maximmalin/simul/frontend/README.md

# EngineeringTeam

Open in Bolt (https://bolt.new/~/sb1-g74egklw)
