maximmalin/simul/tests/requirements/README.md

# tests/requirements/
Автоматические тесты Brig Receiver по матрице требований.

## Порядок работы
1. Тесты запускаются через `.venv/bin/pytest tests/requirements/ -v`.
2. Чек-лист обновляется вручную при появлении новых требований или готовности тестов.
3. Расчёты (calculations/, math/) не используются — только параметры из требований и reference-файлов.

## Подпапки
- `tests/requirements/antenna/` — антенная система (REQ-A1/B1/C1/SW1/ANT-ALL)
- `tests/requirements/rf/` — RF Frontend (REQ-01/03/04/05/06, SNR REQ-36, шум REQ-37)
- `tests/requirements/ao/` — акустооптический процессор (REQ-07/08/09/11/13/14/15)
- `tests/requirements/system/` — системные требования (REQ-01 покрытие, диапазон 0–7 ГГц)
- `tests/requirements/emc/` — электромагнитная совместимость (REQ-21…REQ-25)
- `tests/requirements/reception/` — дальность приёма (Friis/шум) и пеленгация (NEC-2/AntennaSim)
- `tests/requirements/reliability/` — надёжность, MTBF по REQ-26 (Octave)
- `tests/requirements/thermal/` — тепловой режим: fast (θ_JA) + FEM (PCB CAD + ngspice)
- `tests/requirements/checklist.csv` — чек-лист требований
- `tests/requirements/README.md` — описание подпапок
- `tests/requirements/checklist/README.md` — описание чек-листа

## Источник
- requirements/*/REQ-*.md
- tests/README.md
