maximmalin/simul/hardware/antenna/README.md

# antenna/README.md
'''
Много диапазонная печатная антенная решетка (Multi-Band Antenna Array)
Размер: 150 × 150 мм, материал — СВЧ-текстолит FR-4 толщиной 0.8 мм.
'''
