maximmalin/simul/sim/outputs/ngspice/README.md

# Brig Receiver antennas -> ngspice S-parameter networks

Generated by `sim/scripts/export_ngspice.py` from the openEMS FDTD results in
`sim/outputs/openems_results.json`.  Reference impedance 50 ohm everywhere.

## Data provenance

* **Ch B / Ch C** - single-patch FDTD (openEMS, FR-4 eps_r=4.5, tan_d=0.02,
  h=0.8 mm, PML_8 absorbing boundaries).  The patch resonant length and the
  probe offset were retuned from an initial simulation so that each element
  resonates at its design frequency and presents ~50 ohm at the feed.
  ``Zin(f)`` is the simulated input impedance; ``S11`` is exact.  Radiation
  efficiency is the FDTD ``Prad/P_acc`` ratio at resonance.
* **Ch A** - analytic printed-dipole model (0-900 MHz).  Not an FDTD result;
  efficiency is assumed ideal.  Replace with an FDTD run if a
  frequency-dependent dipole model is required.

## Files

| Ch | 1-port | 2-port | f_res (GHz) | S11 @ f_res (dB) | eta_rad |
|----|---|---|---|---|---|
| A | `ant_cha.s1p` | `ant_cha.s2p` | 0.200 | -12.0 | 100% |
| B | `ant_chb.s1p` | `ant_chb.s2p` | 2.450 | -33.1 | 30% |
| C | `ant_chc.s1p` | `ant_chc.s2p` | 5.800 | -24.4 | 50% |

* `ant_ch<X>.s1p` - antenna feed reflection only (exact FDTD `Zin`).
* `ant_ch<X>.s2p` - 2-port: port 1 = feed, port 2 = radiated-wave port.
* `ant_sparams.lib` - ngspice subcircuits `ANT_CHA` / `ANT_CHB` / `ANT_CHC`.
* `antenna_model.net` - demo netlist (unit source at the space port).

## Two-port definition

```
 port 1 (feed)  ---[ ANT_CHx ]---  port 2 (radiated wave)
  to RF front-end                   test signal / free space
```

* `S11(f) = (Zin(f) - 50) / (Zin(f) + 50)` - from the FDTD input impedance.
* `S22 = 0` - matched radiation sink.
* `S21 = S12 = sqrt(eta) * sqrt(1 - |S11|^2) * exp(j*arg(S11))`.

Power balance: driving port 1 gives `|S11|^2 + |S21|^2 = eta` (the accepted
power is radiated with efficiency `eta`; the remainder is dielectric and
conductor loss).  On receive, driving port 2 delivers `eta*(1 - |S11|^2)` of
the incident power to the feed.

To emulate a received wave, drive port 2 and read port 1; to load a
transmitter, drive port 1 into the receiver front-end.

## Usage in ngspice

```spice
.include ant_sparams.lib
V_test   space 0 dc 0 ac 1
Xant_chB feed  space 0 ANT_CHB touchstone="ant_chB.s2p"
Rfeed    feed  0 50
.control
sp lin 101 1e9 4e9
print S_1_1 S_2_1
.endc
```

Run the demo: `ngspice -b sim/outputs/ngspice/antenna_model.net`

## Why no FMU

ngspice 44 reads Touchstone natively via the XSPICE `xfer` code model
(see `/usr/share/doc/ngspice/examples/sp/file.cir`).  No FMU wrapper is
needed for this network.

## Notes / limitations

* The model reproduces the simulated feed impedance exactly.
* Radiation efficiency is the FDTD `Prad/P_acc` ratio at resonance.  Pass
  `--eta <x>` to the exporter to override every channel with a fixed value.
* `|S11|` is clipped to `< 1` (passivity) at a handful of far-out-of-band
  points where the raw FDTD impedance gives a marginal `|S11| > 1`.
* The transmission phase is taken as `arg(S11)` (lossless reciprocal 2-port
  convention).  Magnitudes are exact; absolute far-field phase is not
  calibrated (that needs a two-antenna reference measurement).
