maximmalin/simul/design/library_index.md

# Library Index

| Ref | Type | KiCad Lib ID | Footprint |
|-----|---|---|---|
| PLC0415 | plc | Device:R | - |
| BLE001 | ble | Device:R | - |
| PLC0415 | plc | Device:R | - |
| PLC0415 | plc | Device:R | - |
| PLC0415 | plc | Device:R | - |
| PLC0415 | plc | Device:R | - |
| PLC0415 | plc | Device:R | - |
| PLC0415 | plc | Device:R | - |
| PLC0415 | plc | Device:R | - |
| BLE001 | ble | Device:R | - |
| BLE001 | ble | Device:R | - |
| BLE001 | ble | Device:R | - |
| BLE001 | ble | Device:R | - |
| BLE001 | ble | Device:R | - |
