maximmalin/simul/requirements/antenna/REQ-ANT-01_channel_a.md

# REQ-ANT-01 — Антенная система, канал A

**Подсистема:** Антенная панель (печатная плата 150×150 мм, FR-4 0.8 мм)

- **Требование:** Приём в диапазоне 0–900 МГц, входное сопротивление 50 ± 10 Ом, КНД ≥ 5 дБи на 433 МГц.
- **Проверка:** `tests/requirements/antenna/test_antenna.py`; FDTD — `sim/scripts/antenna_fdtd.py`.

### Сквозной расчёт физики

Печатный диполь на FR-4 с ε_r = 4.4 рассчитывается с учётом
диэлектрической проницаемости подложки, уменьшающей эффективную длину:

λ_eff = c / (f · √((1 + ε_r)/2))

Для резонанса на 200 МГц (нижняя граница рабочего диапазона):
λ_0 = 1.5 м, λ_eff ≈ 0.92 м → длина диполя ≈ 0.46 м.

На 433 МГц λ_0 = 0.69 м → КНД печатного диполя на проводящей
подложке с экранирующей обратной стороной составляет ≈ 5.5 дБи.
