maximmalin/simul/requirements/mechanics/REQ-MECH-02_zoning.md

# REQ-MECH-02 — Зонирование корпуса

**Подсистема:** Механика / корпус
**Схема:** `references/structural_block.drawio`

- **Требование:** Корпус разделить на три электрически изолированные секции — ВЧ-аналоговую, цифровую и питания — перегородками из алюминия с прокладками.
- **Проверка:** `tests/requirements/emc/test_emc.py::test_req_25_*`.

### Секции и их содержимое

| секция | элементы платы | требование |
|---|---|---|
| **ВЧ-аналоговая** | `J_ANT`, `Q_LNA1/2`, `X_QWC1`, `U_MIX1`, `U_OP1`, `FB1`, `C_ANA*` | аналоговая «земля» звездой; тактовые линии STM32 не входят |
| **Цифровая** | `U1`, `Y1`, `J_USB`, `C_MCU*` | своя GND-плоскость, экран от ВЧ-секции |
| **Питание** | `J_PWR`, `U_LDO`, `C_LDO*` | сквозной фильтр на входе аналоговой секции |

### Сквозной расчёт физики

Токи переключения `U1` (72 МГц и гармоники) текут по цифровой «земле».
При отсутствии разделения общий ток создаёт падение напряжения
ΔV = I·R_общ на сопротивлении общей «земли», которое проявляется
как ошибка на входе АЦП и неотличимо от полезного сигнала.

Чтобы ΔV оставалось ниже цены младшего разряда АЦП
(q_LSB = 3.3/4096 ≈ 0.8 мВ), требуется R_общ < 0.8·10⁻³ / I_цифр.
При I_цифр = 20 мА: R_общ < **40 мОм** — достигается только при
звёздной разводке «земли» и разделении на секции.

> В предыдущей редакции третьей секцией считался «цифровой блок
> (ESP32, ПЛИС)», а гальваническая изоляция обеспечивалась связью с ПК
> **только по Wi-Fi**. В Krystal Radio беспроводной связи нет: данные
> выводятся по USB CDC, микроконтроллер — STM32F103C8T6, ПЛИС не
> применяется. Оптический блок отсутствует.
