maximmalin/simul/requirements/blocks/req_27.md

# # Блок требования REQ-27

## Электробезопасность (Electrical Safety)
- **Требование:** Изделие должно соответствовать требованиям безопасности по ГОСТ IEC 60950-1-2014 (Эквивалент: IEC 60950-1 / IEC 62368-1)
- **Структурный блок:** Блок 6.2 «Безопасность — Электрическая»
- **Скрещивание с общими техническими требованиями:**
  - Требование раздельного питания блоков (230В Сеть → DC преобразователи изолированы)
  - Гальваническая изоляция интерфейсов (USB, Ethernet — оптические изоляторы)
  - Взаимосвязь с требованием REQ-23 (EMC излучение)
- **Сквозной расчет физики:** Изоляционное напряжение между сетью 230В и низковольтными секциями должно не менее 3000 В (per IEC 62368-1, Class I equipment). При рабочем напряжении +12V и +5V от линейных стабилизаторов (LM7812/LM7805) от батарейного питания изоляция не требуется (обеспечивается батарейной изоляцией от сети). Защита от перегрузок: автоматический выключатель при токе > 2A, время отключения < 0.1 с. Заземление корпуса (Grounding screw per ГОСТ 14192-96, знак «Заземление»). Утечка тока на корпус не должна превышать 0.5 mA (per IEC 60950-1).
