maximmalin/simul/requirements/blocks/req_28.md

# # Блок требования REQ-28

## Защита от перегрузок (Overcurrent Protection)
- **Требование:** Автоматический выключатель при токе > 2A, время отключения < 0.1 с
- **Структурный блок:** Блок 6.3 «Защита цепей»
- **Скрещивание с общими техническими требованиями:**
  - Взаимосвязь с требованием REQ-19 (стабилизация ±0.1° C — система Пельтье)
  - Взаимосвязь с требованием REQ-04 (NF ≤ 3.5 дБ — питание УПЧ КТ368А)
- **Сквозной расчет физики:** Стабилизаторы питания LM7812/LM7805 потребляют ток от батарей в диапазоне 200–500 мА (при нагрузке 0.5–2 А на выходе). Автоматический выключатель (полимерный восстановляемый предохранитель, R PolySwitch, rated 2A) гасит перегрузки от короткого замыкания или аварийной нагрузки. При токе 2A падение напряжения на fuse: V_drop ≈ I · R ≈ 2A · 0.05Ω ≈ 0.1V (минимум). Время отключения: t_break ≈ 0.01–0.1 с (для polymeric fuse). Это предотвращает перегрев проводников (температура подъема ΔT ≈ I²·R·t / C_thermal < 10° C при R_wire ≈ 0.1Ω) и пожары.
