maximmalin/simul/requirements/blocks/req_29.md

# # Блок требования REQ-29

## Заземление и защита от удара током (Grounding)
- **Требование:** Заземление корпуса, утечка тока на корпус не более 0.5 mA
- **Структурный блок:** Блок 6.4 «Заземление»
- **Скрещивание с общими техническими требованиями:**
  - Взаимосвязь с требованием REQ-27 (электробезопасность)
  - Взаимосвязь с требованием REQ-23 (EMC излучение)
- **Сквозной расчет физики:** Заземляющий провод сечением S ≥ 0.5 мм² (per ГОСТ 3198) обеспечивает токос방ока при аварийном контакте. Утечка тока I_leakage ≤ 0.5 mA рассчитывается по формуле I_leakage = V_isolation / R_insulation, где V_isolation ≈ 500 В (напряжение сети) и R_insulation ≥ 100 MΩ (per IEC 60950-1). ΔT на корпусе от потоса: Q = I² · R · t ≈ (0.0005A)² · 0.1Ω · 3600s ≈ 0.0009 J — незначительное нагревание (ΔT < 0.1° C при массе корпуса ~500 г, c_al ≈ 0.9 J/g·K).
