maximmalin/simul/requirements/blocks/req_antenna_system.md

# # Блок требования REQ-A1: Антенна Канал А (0–900 МГц)
## Печатная полуволновая змейка

- **Требование:** Прием радиосигналов в диапазоне 0–900 МГц, входное сопротивление 50 ± 10 Ом, коэффициент усиления не менее 5 дБи на частоте 433 МГц, SWR ≤ 2.0 по всей полосе
- **Структурный блок:** Узел 0.1 / Блок А «Антенна Канал А»
- **Скрещивание с общими техническими требованиями:**
  - Входное сопротивление 50 Ом (REQ-03, ГОСТ 20275-91)
  - Совместимость с ВЧ-трактом 0–7 ГГц (REQ-01)
- **Физическая реализация:**
  - Тип: печатная полуволновая антенна-змейка (Meander Line Antenna)
  - Материал: СВЧ-текстолит FR-4, толщина 0.8 мм, ε = 4.5
  - Связь с трактом: копланарный волновод (GCPW), Z₀ = 50 Ом, ширина 1.2 мм, зазор 0.2 мм
  - Панель: 150 × 150 мм
- **Критерии приемки:**
  - Диапазон приема: не менее 0–900 МГц (SWR ≤ 2.0)
  - Входное сопротивление: 50 ± 10 Ом в полосе
  - КНД ≥ 5 дБи на 433 МГц
  - Результаты моделирования NEC2/NEC4 в файле `antenna/band_a/simulation.nec`

---

# # Блок требования REQ-B1: Антенна Канал Б (1.2–3.0 ГГц)
## Микрополосковая матрица 2×2

- **Требование:** Прием радиосигналов в диапазоне 1.2–3.0 ГГц, резонанс 2.45 ± 0.02 ГГц, коэффициент усиления не менее 8 дБи, входное сопротивление 50 ± 5 Ом (SWR ≤ 1.5)
- **Структурный блок:** Узел 0.2 / Блок Б «Антенна Канал Б»
- **Скрещивание с общими техническими требованиями:**
  - Входное сопротивление 50 Ом (REQ-03, ГОСТ 20275-91)
  - Участие в коммутации через PIN-ключи (структурная схема)
  - Покрытие диапазона 0–7 ГГц в составе антенной решетки (REQ-01)
- **Физическая реализация:**
  - Тип: микрополосковая матрица патчей 2×2 (4 элемента)
  - Материал: СВЧ-текстолит FR-4, толщина 0.8 мм, ε = 4.5
  - Шаг между центрами элементов: 91.7 мм
  - Связь с трактом: GCPW 50 Ом (ширина 1.2 мм, зазор 0.2 мм)
  - Панель: 150 × 150 мм
- **Критерии приемки:**
  - Резонансная частота: 2.45 ± 0.02 ГГц
  - КНД: не менее 8 дБи (в основном лепестке)
  - Входное сопротивление: 50 ± 5 Ом (SWR ≤ 1.5)
  - Результаты моделирования в HFSS/CST или NEC2 в файле `antenna/band_b/simulation.nec`

---

# # Блок требования REQ-C1: Антенна Канал В (4.0–7.0 ГГц)
## Микрополосковая матрица 4×4

- **Требование:** Прием радиосигналов в диапазоне 4.0–7.0 ГГц, резонанс 5.8 ± 0.05 ГГц, коэффициент усиления не менее 12 дБи, входное сопротивление 50 ± 5 Ом, уровень сторонних лепестков ≤ −15 дБ
- **Структурный блок:** Узел 0.3 / Блок В «Антенна Канал В»
- **Скрещивание с общими техническими требованиями:**
  - Входное сопротивление 50 Ом (REQ-03, ГОСТ 20275-91)
  - Участие в коммутации через PIN-ключи (структурная схема)
  - Покрытие диапазона 0–7 ГГц в составе антенной решетки (REQ-01)
  - Требование к помехоустойчивости и экранированию (REQ-21, REQ-25)
- **Физическая реализация:**
  - Тип: микрополосковая матрица патчей 4×4 (16 элементов)
  - Материал: СВЧ-текстолит FR-4, толщина 0.8 мм, ε = 4.5 (для верхней части диапазона ≥ 5 ГГц допускается Rogers RO4350B)
  - Связь с трактом: GCPW 50 Ом (ширина 1.2 мм, зазор 0.2 мм)
  - Экранирование: металлическая камера вокруг антенной решетки (стенки ≥ 1.5 мм, алюминий)
  - Панель: 150 × 150 мм
- **Критерии приемки:**
  - Резонансная частота: 5.8 ± 0.05 ГГц
  - Диапазон работы: 4.0–7.0 ГГц (SWR ≤ 2.0)
  - КНД: не менее 12 дБи (матрица 4×4)
  - Входное сопротивление: 50 ± 5 Ом
  - Уровень сторонних лепестков ≤ −15 дБ
  - Результаты моделирования в HFSS/CST или открытой альтернативе в файле `antenna/band_c/simulation.nec`

---

# # Блок требования REQ-SW1: Переключатель антенных каналов
## СВЧ PIN-ключи

- **Требование:** Коммутация антенных входов А/Б/В с изоляцией не включенных каналов не менее 40 дБ, быстродействие переключения ≤ 1 мкс, управляемость от микроконтроллера (TTL-уровень)
- **Структурный блок:** Узел 1.1 / Блок «Переключатель СВЧ-каналов»
- **Скрещивание с общими техническими требованиями:**
  - Совместимость с ВЧ-трактом (REQ-03, 50 Ом)
  - Защита от наводок Wi-Fi (REQ-23, REQ-25)
  - Входит в Отсек 1 (СВЧ-тракт и селекция)
- **Физическая реализация:**
  - Тип: бескорпусные СВЧ PIN-диоды серии КА507
  - Управление: TTL-импульсы от ESP32 (контроллер Отсек 4)
  - Схема коммутации: три входа (А, Б, В) → один выход на миксер/ТВ-тюнер
  - Изоляция невыбранных каналов: ≥ 40 дБ
- **Критерии приемки:**
  - Изоляция невыбранных каналов: ≥ 40 дБ
  - Время переключения: ≤ 1 мкс
  - Входное и выходное сопротивление: 50 ± 5 Ом
  - Управление от ESP32: TTL-уровень, гарантированное закрытие каналов во время Wi-Fi Burst

---

# # Блок требования REQ-ANT-ALL: Антенная система (комплексный)
## Многодиапазонная печатная антенная решетка

- **Требование:** Три независимых приемных канала (А: 0–900 МГц, Б: 1.2–3.0 ГГц, В: 4.0–7.0 ГГц) на единой печатной панели 150 × 150 мм, FR-4 0.8 мм, с переключением через PIN-ключи, совместное покрытие диапазона 0–7 ГГц
- **Структурный блок:** Узел 0.1–0.3 + Узел 1.1 / Блоки А, Б, В, Переключатель
- **Скрещивание с общими техническими требованиями:**
  - Диапазон 0–7 ГГц (REQ-01)
  - Входное сопротивление 50 Ом (REQ-03)
  - ЭМС: эксплуатация в помеховой обстановке (REQ-21, REQ-22)
  - Совместимость с ТЗ (раздел 3.1, RF Frontend)
- **Критерии приемки:**
  - Полное покрытие: 0–7 ГГц без пропусков
  - Каждый канал: согласован по 50 Ом, SWR ≤ 2.0
  - Переключение каналов: без потери направленности и КНД
  - Панель: единая плата 150 × 150 мм, FR-4 0.8 мм
  - Все файлы трассировки в KiCad/Altium: `block0_5v_bus.kicad_sch`, `block1_rf_frontend.kicad_sch`, `block3.kicad_sch`
