maximmalin/simul/requirements/blocks/req_block_26_29.md

# Блок требований: Надежность и безопасность

## Ссылка на требование: REQ-26 через REQ-27

### 26. Среднее время наработки на отказ (MTBF)
- **Требование:** T₀ должно составлять не менее 10 000 часов
- **Структурный блок:** Блок 6.1 «Надежность — Время наработки»
- **Скрещивание с общими техническими требованиями:**
  - Требование ГОСТ 27.002-2015 (Эквивалент: ISO 13849-1 / IEC 61508)
  - Взаимосвязь с качеством ПО (ISO/IEC 25010) и надежностью 하드웨어
- **Сквозной расчет физики:** MTBF рассчитывается на основе Mean Time Between Failures (MTBF = ΣMTBF_i), где каждый компонент имеет свой собственный MTBF:
  - Алюминиевый корпус: MTBF ≈ 50 000 ч (при условии отсутствия коррозии)
  - Лазерный диод: MTBF ≈ 10 000 ч при температуре 25° C (удваивается при каждом снижении температуры на 10° C по правилу Arrhenius)
  - Элементы Пельтье: MTBF ≈ 20 000 ч (при непрерывной работе в диапазоне -40...+50° C)
  - CMOS-матрица: MTBF ≈ 30 000 ч (при правильном термостабилизировании)
  - Итого система: MTBF_system ≈ 1 / (1/50000 + 1/10000 + 1/20000 + 1/30000) ≈ 5 882 ч — недостаточно, поэтому требуется система предупредительного обслуживания и модулируемое проектирование для замены отдельных узлов без остановки всей системы. Целевой MTBF 10 000 часов достигается за счет использования redundant (дублирующих) каналов для критических функций (стабилизация температуры, захват спектра).

### 27. Электробезопасность (Electrical Safety)
- **Требование:** Изделие должно соответствовать требованиям безопасности по ГОСТ IEC 60950-1-2014 (Эквивалент: IEC 60950-1 / IEC 62368-1)
- **Структурный блок:** Блок 6.2 «Безопасность — Электрическая»
- **Скрещивание с общими техническими требованиями:**
  - Требование раздельного питания блоков (230В Сеть → DC преобразователи изолированы)
  - Гальваническая изоляция интерфейсов (USB, Ethernet — оптические изоляторы)
  - Взаимосвязь с требованием REQ-23 (ЭМС излучение)
- **Сквозной расчет физики:** Изоляционное напряжение между сетью 230В и низковольтными секциями должно не менее 3000 В (per IEC 62368-1, Class I equipment). При рабочем напряжении +12V и +5V от линейных стабилизаторов (LM7812/LM7805) от батарейного питания изоляция не требуется (обеспечивается батарейной изоляцией от сети). Защита от перегрузок: автоматический выключатель при токе > 2A, время отключения < 0.1 с. Заземление корпуса (Grounding screw per ГОСТ 14192-96, знак «Заземление»). Утечка тока на корпус не должна превышать 0.5 mA (per IEC 60950-1).

### 28. Защита от перегрузок (Overcurrent Protection)
- **Требование:** Автоматический выключатель при токе > 2A, время отключения < 0.1 с
- **Структурный блок:** Блок 6.3 «Защита цепей»
- **Скрещивание с общими техническими требованиями:**
  - Взаимосвязь с требованием REQ-19 (стабилизация ±0.1° C — система Пельтье)
  - Взаимосвязь с требованием REQ-04 (NF ≤ 3.5 дБ — питание УПЧ КТ368А)
- **Сквозной расчет физики:** Стабилизаторы питания LM7812/LM7805 потребляют ток от батарей в диапазоне 200–500 мА (при нагрузке 0.5–2 А на выходе). Автоматический выключатель ( polymeric resettable fuse, R PolySwitch, rated 2A) гасит перегрузки от короткого замыкания или аварийной нагрузки. При токе 2A падение напряжения на fuse: V_drop ≈ I · R ≈ 2A · 0.05Ω ≈ 0.1V (минимум). Время отключения: t_break ≈ 0.01–0.1 с (для polymeric fuse). Это предотвращает перегрев проводников (температура подъема ΔT ≈ I²·R·t / C_thermal < 10° C при R_wire ≈ 0.1Ω) и пожары.

### 29. Заземление и защита от удара током (Grounding)
- **Требование:** Заземление корпуса, утечка тока на корпус не более 0.5 mA
- **Структурный блок:** Блок 6.4 «Заземление»
- **Скрещивание с общими техническими требованиями:**
  - Взаимосвязь с требованием REQ-27 (электробезопасность)
  - Взаимосвязь с требованием REQ-23 (EMC излучение)
- **Сквозной расчет физики:** Заземляющий провод сечением S ≥ 0.5 мм² (per ГОСТ 3198) обеспечивает токос방ока при аварийном контакте. Утечка тока I_leakage ≤ 0.5 mA рассчитывается по формуле I_leakage = V_isolation / R_insulation, где V_isolation ≈ 500 В (напряжение сети) и R_insulation ≥ 100 MΩ (per IEC 60950-1). ΔT на корпусе от потоса: Q = I² · R · t ≈ (0.0005A)² · 0.1Ω · 3600s ≈ 0.0009 J — незначительное нагревание (ΔT < 0.1° C при массе корпуса ~500 г, c_al ≈ 0.9 J/g·K).
