maximmalin/simul/hardware/antenna/band_a/task.md

# Блок-узел 0.1: Печатная полуволновая змейка (0–900 МГц)

## Общие данные
- Тип антенны: Печатная полуволновая антенна-змейка (Meander Line Antenna)
- Частотный диапазон: 0–900 МГц
- Назначение: Прием раций (УКВ/ОТР) и служебной связи
- Материал: СВЧ-текстолит FR-4, толщина 0.8 мм, ε = 4.5
- Связь с трактом: Копланарный волновод с заземлением (GCPW), Z₀ = 50 Ом
  - Ширина дорожки: 1.2 мм
  - Зазор до боковой земли: 0.2 мм

## Технические задания
1. Рассчитать геометрию змейки дляrezонанса на нижней границе диапазона (низкочастотный фильтр-дифференцирующее звено).
2. Спроектировать трассировку змейки в KiCad / Altium — файл `block0_5v_bus.kicad_sch`.
3. Рассчитать входное сопротивление на частотах 200, 400, 600, 900 МГц (S₁₁ ≤ −10 дБ).
4. Согласовать импеданс змейки с GCPW 50 Ом (рассчитать стыковочное соединение).
5. Провести моделирование в NEC2/NEC4 (файл `antenna/band_a/simulation.nec`).
6. Свести результаты моделирования с экспериментом (после изготовления прототипа).

## Критерии приемки
- Диапазон приема: не менее 0–900 МГц (SWR ≤ 2.0)
- Входное сопротивление: 50 ± 10 Ом в полосе
- Кювета панели: 150 × 150 мм, FR-4, 0.8 мм

## Файлы
- `block0_5v_bus.kicad_sch` — схема соединения змейки с GCPW
- `block0_5v_bus.kicad_pcb` — трассировка печатной платы (пока не создан)
- `simulation.nec` — входной файл для NEC2
- `report.pdf` — отчет по результатам моделирования и испытаний
