maximmalin/simul/plan/blocks.md

> **⚠️ УСТАРЕВШИЙ ДОКУМЕНТ.** Этот план относится к отменённой
> акустооптической схеме (акустооптический преобразователь, ESP32 + Wi-Fi,
> ПЛИС, лазер 650 нм, нож Фуко, фотодиоды BPW34). **Изделие не строим.**
> Действующие требования — в `requirements/` (структура по подсистемам SDR).
> Соответствие «старое требование → чем заменено» — в
> `requirements/README.md`, раздел «Исправленные ошибки исходной редакции».

# План робіт над проєктом Brig Receiver

**Проєкт:** Компактний багаточастотний випромінювальний приймач спеціального призначення  
**Дата створення плану:** 2026-09-17  
**Версія плану:** 2.0 (антенна система + переключач, виправлення відповідності ТЗ)

---

## Огляд

| Розділ | Зміст |
|---|---|
| 1. Основні блоки системи (за схемою structural.drawio) | Таблиця всіх блоків з кодами та посиланнями на вимоги |
| 2. Критерії прийому (для кожного блоку) | Мінімальні параметри прийому |
| 3. Діаграма взаємодії блоків | Короткий опис потоків сигналу |
| 4. План робіт по кожному блоку | Кроки реалізації |
| 5. Посилання на ТЗ | Файли в requirements/*/ та work/tz-* |

---

## 1. Основні блоки системи (за схемою structural.drawio)

| № | Блок | Код блоку | Вхід | Вихід | Вимоги | Файл проекту |
|---|---|---|---|---|---|---|
| 0.1 | Антенна Канал А (0–900 МГц) — печатная змейка | `Ant_A` | Ефір 0–900 МГц | GCPW 50 Ом → PIN_Switches | REQ-A1 | hardware/antenna/band_a/task.md |
| 0.2 | Антенна Канал Б (1.2–3.0 ГГц) — матрица 2×2 | `Ant_B` | Ефір 1.2–3.0 ГГц | GCPW 50 Ом → PIN_Switches | REQ-B1 | hardware/antenna/band_b/task.md |
| 0.3 | Антенна Канал В (4.0–7.0 ГГц) — матрица 4×4 | `Ant_C` | Ефір 4.0–7.0 ГГц | GCPW 50 Ом → PIN_Switches | REQ-C1 | hardware/antenna/band_c/task.md |
| 1.1 | Переключач СВЧ-каналів (PIN-ключі КА507) | `PIN_Switches` | 3 входи від Ant_A/B/C | 1 вихід на Міксер/Тюнер | REQ-SW1 | — (в складі Отсек1) |
| 1.2 | Міксер 1 (1.2–3 ГГц, LO 2.0 ГГц) | `Mixer_1` | Від PIN_Switches | На ТВ-Тюнер (ПЧ 38 МГц) | REQ-06 | — |
| 1.3 | Міксер 2 (4.0–7 ГГц, LO 5.15 ГГц) | `Mixer_2` | Від PIN_Switches | На ТВ-Тюнер (ПЧ 38 МГц) | REQ-06 | — |
| 1.4 | ТВ-Селектор каналів (KS-H-132) | `TV_Tuner` | Від Міксерів + Канал А | ПЧ 38 МГц → КТ368А | REQ-05 | — |
| 1.5 | Буферний УПЧ КТ368А | `KT368_Amp` | Від ТВ-Тюнер (38 МГц) | На захисну вилку | REQ-04 | — |
| 1.6 | Захисна диодна вилка КД522/1N4148 | `Diode_Clamp` | Від КТ368А | На кварц (КТ-1) | REQ-05, REQ-06 | — |
| 2.1 | Вскритий кварц 38 МГц | `Custom_Transducer` | Від Diode_Clamp (КТ-1) | Звук у PMMA | — | — |
| 2.2 | Звукопровід PMMA (ТОСП) 20×30×5 мм | `PMMA_Block` | Від кварца + лазер | На нож Фуко | — | — |
| 2.3 | Лазер DVD 650 нм | `Laser_DVD` | Від ОУ К140УД7 | На PMMA | REQ-07 | — |
| 2.4 | ОУ К140УД7 (стабілізатор струму) | `OpAmp_Driver` | Від LDO 5В | На лазер | REQ-08 | — |
| 2.5 | Нож Фуко (винт М3×0.25) | `Foucault_Knife` | Від PMMA + лазер | На фотодіоди | — | — |
| 2.6 | Диференціальна фотодіодна матриця BPW34 | `Photodiode_IQ` | Від ножу Фуко | Ток 100 нА–600 мкА → FPAA | — | — |
| 3.1 | Трансимпедансний каскад К140УД7 | `FPAA_Denoise` | Від Photodiode_IQ (КТ-2) | На вичател | — | — |
| 3.2 | Диференціальний вичател К140УД8 | `FPAA_Subtractor` | Від FPAA_Denoise | Очищений аналог → STM32 | — | — |
| 3.3 | АЦП STM32F103C8T6 (PA0/PA1 + DMA) | `STM32_ADC` | Від FPAA_Subtractor | Цифровий потік → STM32_ML | REQ-13, REQ-14, REQ-15 | — |
| 3.4 | Ядро TinyML (int8, TensorFlow Lite Micro) | `STM32_ML` | Від STM32_ADC | Цифровий потік I/Q → ESP32_DMA | — | — |
| 4.1 | SPI DMA приймач (ESP32, Ядро 0) | `ESP32_DMA` | Від STM32_ML | У кільцевий буфер RAM | — | — |
| 4.2 | Глибокий кільцевий буфер RAM | `ESP32_Buffer` | Від ESP32_DMA | На ESP32_WiFi | — | — |
| 4.3 | Вбудована PCB-антенна змійка (ESP32, Ядро 1) | `ESP32_WiFi` | Від ESP32_Buffer | UDP/TCP на ПК | REQ-23 | — |
| 4.4 | Апаратний таймер 2-Tone (ESP32, Ядро 1) | `ESP32_2Tone` | — | TTL на PIN_Switches | — | — |
| 5.1 | Акумулятор Li-Po (2S/3S) | `Battery` | — | На Buck + LDO | — | — |
| 5.2 | Impульсний Buck-конвертер | `Buck_Converter` | Від Battery | Шумні 5В → ESP32_DMA | — | — |
| 5.3 | Cверхмалошумящий LDO (LT1763/LM7805) | `LDO_Analog` | Від Battery | Чисті 5В → OpAmp_Driver, TV_Tuner, FPAA_Denoise, STM32_ADC | — | — |
| 5.4 | СВЧ-дроссель BLM18 + кераміка 10нФ/33пФ | `Ferrite_Bead` | Від ESP32_DMA (навідка) | Запоруха на границі відсеків | REQ-24 | — |
| ПК | Ноутбук оператора (SDR++ / GNU Radio) | `PC_SDR` | Від ESP32_WiFi | Відображення водопаду | REQ-31–REQ-34 | — |

---

## 2. Критерії прийому (для кожного блоку)

| № блоку | Критерії прийому | Файл вимог |
|---|---|---|
| 0.1 | Діапазон 0–900 МГц (SWR ≤2.0); вхідний опір 50±10 Ом; КНД ≥5 дБи на 433 МГц | REQ-A1 |
| 0.2 | Резонанс 2.45±0.02 ГГц; діапазон 1.2–3.0 ГГц; КНД ≥8 дБи; вхідний опір 50±5 Ом (SWR≤1.5) | REQ-B1 |
| 0.3 | Резонанс 5.8±0.05 ГГц; діапазон 4.0–7.0 ГГц; КНД ≥12 дБи; вхідний опір 50±5 Ом; бокові лепестки ≤-15 дБ; екранірование алюміній ≥1.5 мм | REQ-C1 |
| 1.1 (переключач) | Ізоляція невиділених каналів ≥40 дБ; час переключення ≤1 мкс; вхідний/вихідний опір 50±5 Ом; керування TTL від ESP32 | REQ-SW1 |
| Антена система (комплекс) | Повне покриття 0–7 ГГц без пропусків; єдина панель 150×150 мм FR-4 0.8 мм; всі канали 50 Ом, SWR≤2.0 | REQ-ANT-ALL |
| 1.2–1.3 (міксери) | Виходна потужність до 1.5 Вт; зонування частот | REQ-06 |
| 1.4 (ТВ-тюнер) | Захист від перевантаження до +20 дБм; NF ≤3.5 дБ (разом з УПЧ) | REQ-05, REQ-04 |
| 2.3 (лазер) | λ = 650 нм; стабільність опт. потужності ≤0.5% | REQ-07, REQ-08 |
| 2.4 (АРМ) | Наявність АРМ; клас безпеки лазера 3B | REQ-09 |
| 2.1 (кварц) | TeO₂; просвітлення торців R<0.2% | REQ-11, REQ-12 |
| 3.3 (АЦП) | КМОП ≥2048 пікселів; ДДП пікселя ≥72 дБ; частота зчитування рядків ≥50 кГц | REQ-13, REQ-14, REQ-15 |
| 4.3 (Wi-Fi) | Рівень помехоемісії ≤CISPR 22 Class B; екраніровання корпусу | REQ-23, REQ-25 |
| 5.4 (фільтри питання) | Фільтри на лініях +5В, GND; гашення ВЧ-шуму | REQ-24 |
| ПК (HOST API) | Драйвер C/C++ (Linux/Windows); Source block для GNU Radio; USB 3.0 без втрат кадрів | REQ-31, REQ-32, REQ-33, REQ-34 |

---

## 3. Діаграма взаємодії блоків (коротко)

```
[0.1]→[0.2]→[0.3]  Антенна система (3 канали)
   ↓     ↓     ↓
  Ant_A  Ant_B  Ant_C  →  GCPW 50 Ом
   ↓     ↓     ↓
[1.1] PIN_Switches (переключач 3→1, REQ-SW1)
   ↓
[1.4] TV_Tuner ←— [1.2] Mixer_1 ←— Канал Б (1.2–3 ГГц)
              ←— [1.3] Mixer_2 ←— Канал В (4.0–7 ГГц)
   ↓
[1.5] KT368_Amp → [1.6] Diode_Clamp → [2.1] Кварц (КТ-1, P≤1 мВт)
                                            ↓
[2.2] PMMA ←— [2.3] Лазер + [2.4] ОУ К140УД7
   ↓ (звук + світло)
[2.5] Нож Фуко → [2.6] Photodiode_IQ (КТ-2, ток 100 нА–600 мкА)
   ↓
[3.1] FPAA_Denoise → [3.2] FPAA_Subtractor → [3.3] STM32_ADC → [3.4] STM32_ML
                                                                    ↓
[4.1] ESP32_DMA → [4.2] ESP32_Buffer → [4.3] ESP32_WiFi → ПК (SDR++)
   ↖__________ [4.4] ESP32_2Tone (зворотний зв'язок на PIN_Switches) __________↙

Питання (зіркова розводка):
[Battery] → [Buck_Converter] → ESP32_DMA (шумні 5В)
[Battery] → [LDO_Analog] → OpAmp_Driver, TV_Tuner, FPAA_Denoise, STM32_ADC (чисті 5В)
[ESP32_DMA] —(навідка СВЧ)→ [5.4] Ferrite_Bead BLM18 → земля
```

---

## 4. План робіт по кожному блоку

### Блок 0.1: Антенна Канал А (0–900 МГц)
1. Розрахувати геометрію змійки для резонансу на нижній межі діапазону.
2. Спроектувати трасування в KiCad: `block0_5v_bus.kicad_sch`.
3. Розрахувати вхідний опір на 200/400/600/900 МГц (S₁₁ ≤-10 дБ).
4. Узгодити імпеданс з GCPW 50 Ом.
5. Моделювання в NEC2/NEC4: `antenna/band_a/simulation.nec`.

### Блок 0.2: Антенна Канал Б (1.2–3.0 ГГц)
1. Розрахувати розміри патча для 2.45 ГГц.
2. Спроектувати систему живлення 4 елементів (рівномірна фаза і амплітуда).
3. Розрахувати взаємний вплив елементів.
4. Трасування в KiCad: `block1_rf_frontend.kicad_sch`.
5. Моделювання в HFSS/CST або NEC2.

### Блок 0.3: Антенна Канал В (4.0–7.0 ГГц)
1. Розрахувати розміри патча для 5.8 ГГц (врахувати дисперсію, втрати).
2. Спроектувати систему живлення 16 елементів.
3. Розрахувати напрямність (dBi) матриці 4×4.
4. Екранірование: металева камера навколо решітки (алюміній ≥1.5 мм).
5. Трасування в KiCad: `block3.kicad_sch`.
6. Моделювання в HFSS/CST або відкриті альтернативи.

### Блок 1.1: Переключач СВЧ-каналів (PIN-ключі)
1. Відібрати PIN-діоди КА507 для діапазону до 7 ГГц.
2. розрахувати схему комутації 3 входи → 1 вихід.
3. Розрахувати ізоляцію невиділених каналів (≥40 дБ).
4. Забезпечити TTL-керування від ESP32 (Отсек 4).
5. Переконатися, що канали гасяться під час Wi-Fi Burst (REQ-SW1).

### Блоки 1.2–1.6 (СВЧ-тракт)
1. Збірка міксерів на 3А112А, LO 2.0 ГГц і 5.15 ГГц.
2. Настройка ТВ-тюнеру на ПЧ 38 МГц.
3. Буферний каскад КТ368А (ток коллектора 5 мА).
4. Захисна вилка КД522/1N4148 (U_пп ≤0.63 В).
5. Перевірка NF ≤3.5 дБ (REQ-04).

### Блоки 2.1–2.6 (Акустооптична камера)
1. Монтаж кварца 38 МГц, PMMA, лазера, ножу Фуко.
2. Налаштування керування лазером (ОУ К140УД7, 45 мА).
3. Юстировка ножу Фуко (винт М3×0.25, перекриття 50%).
4. Монтаж фотодіодів BPW34 з кроком 0.915 мм.
5. Перевірка стабільності опт. потужності ≤0.5% (REQ-08).

### Блоки 3.1–3.4 (FPAA + STM32)
1. Збірка трансимпедансного каскаду К140УД7.
2. Збірка диференціального вичателю К140УД8 (компенсація 1 мА).
3. Налаштування АЦП STM32 на PA0/PA1 + DMA.
4. Інтеграція TinyML (int8, TensorFlow Lite Micro).

### Блоки 4.1–4.4 (ESP32)
1. Налаштування SPI DMA приймача (Ядро 0).
2. Кільцевий буфер RAM (глибокий).
3. Вбудована PCB-антенна змійка, орієнтація назад (REQ-23).
4. Таймер 2-Tone (Ядро 1, частота ≥125 кГц).
5. Перевірка рівня помехоемісся (CISPR 22 Class B).

### Питання (Блоки 5.1–5.4)
1. Розводка зіркою: Battery → Buck + LDO.
2. Встановлення СВЧ-дросселя BLM18 на кордоні відсеків (REQ-24).
3. Кераміка 10нФ/33пФ на землю біля перегородок.

---

## 5. Посилання на ТЗ

### Основне ТЗ
- `technical_task.md` — Технічне завдання версії 2.0 (повна версія, з антенною системою)
- `technical_task_ru.md` — російська версія (довершена відповідно до §10 таблиці відповідностей)
- `technical_task_en.md` — англійська версія
- `technical_task_ua.md` — українська версія

### Вимоги (requirements/*/) — УСТАРЕЛИ, див. requirements/README.md
- `req_antenna_system.md` — **новий файл**: REQ-A1, REQ-B1, REQ-C1, REQ-SW1, REQ-ANT-ALL (антенна система)
- `req_01.md` — REQ-01 (мгновена смуга 500 МГц)
- `req_02.md` — REQ-02 (SFDR 75–80 дБ)
- `req_03.md` — REQ-03 (вхідний опір 50 Ом, SMA)
- `req_04.md` — REQ-04 (NF ≤3.5 дБ)
- `req_05.md` — REQ-05 (захист від перевантаження)
- `req_06.md` — REQ-06 (ВЧ-драйвер 1.5 Вт)
- `req_07.md–req_15.md` — REQ-07–REQ-15 (оптико-механічний вузол, АО-процесор)
- `req_16.md–req_20.md` — REQ-16–REQ-20 (кліматичні умови)
- `req_21.md–req_25.md` — REQ-21–REQ-25 (ЕМС)
- `req_26.md–req_29.md` — REQ-26–REQ-29 (надежність і безпека)
- `req_30.md` — REQ-30 (консервация)
- `req_block_30_33.md` — REQ-30–REQ-33 (упаковка, транспортування)
- `req_31.md–req_34.md` — REQ-31–REQ-34 (HOST API, ПЗ)
- `req_block_01_035.md` — REQ-31–REQ-35 (інтеграция ПЗ і HOST API)

### Файли антенної системи
- `hardware/antenna/README.md` — опис антенної решітки
- `hardware/antenna/band_a/task.md` — завдання на Канал А
- `hardware/antenna/band_b/task.md` — завдання на Канал Б
- `hardware/antenna/band_c/task.md` — завдання на Канал В

### Схема
- `structural.drawio` — структурна схема (Mermaid) з антенною системою і переключачем

### Робочі папки (work/tz-*)
- `work/tz-a/block0_power.md` — Блок 0: Система живлення 5В
- `work/tz-b/block1_rf_frontend.md` — Блок 1: СВЧ-тракт і селекція
- `work/tz-c/block2_ao_camera.md` — Блок 2: Акусто-оптична камера
- `work/tz-d/block3_fpaa_stm32.md` — Блок 3: ФПАА і Сопроцесор STM32
- `work/tz-e/block4_esp32_wifi.md` — Блок 4: Цифровий канал зв'язку ESP32

---

## 6. Зміни від версії 1.0 до 2.0

1. Додано антнену систему: 3 канали (0.1, 0.2, 0.3) + переключач (1.1) в таблицю блоків.
2. Додено новий файл вимог `req_antenna_system.md` (REQ-A1, REQ-B1, REQ-C1, REQ-SW1, REQ-ANT-ALL).
3. Оновлено `structural.drawio` — антennі блоки і переключач мають явні посилання на вимоги.
4. Оновлено `technical_task.md` версії 2.0 — додано розділ 3.1 "Антенная система" з підрозділами 3.1.1–3.1.5, розділ 9 "Структурная схема", таблицю відповідностей вимог (§10), Приложение А і Б.
5. Перевірено відповідність всіх файлів вимог `requirements/blocks/req_*.md` — без конфліктів з talk.txt.
6. Оновлено план робіт — додано кроки для антенної системи і переключача.
