maximmalin/simul/plan/plan.md

міррідж брек-рецівер: план роботи

1. Блок 0: повітряна шина + LC-фільтри
   1.1. KiCad schematic (KіCad 9, S-Expression формат) — наявна? перевірити
   1.2. ngspice симуляція Buck-конвертера
   1.3. Підключення схемної бібліотеки сімволів
   1.4. Експорт PDF/PNG для документації

2. Блок 1: акусто-оптичне ядро (Br...[truncated]
