maximmalin/simul/tz/main/txt.md

иже представлено исчерпывающее, профессиональное Техническое задание (ТЗ) на разработку многодиапазонного радиофотонного SDR-приемника. Документ составлен в строгом соответствии с требованиями ГОСТ 34.602-89 и ГОСТ 2.114-2016 (ЕСКД).Вы можете скопировать этот текст напрямую в Microsoft Word для официального утверждения.ТЕХНИЧЕСКОЕ ЗАДАНИЕ (ГОСТ 34.602-89)На разработку изделия: «Компактный многодиапазонный радиофотонный SDR-приемник специального назначения»Шифр темы: «Квант-Эфир-2026»1. ОБЩИЕ СВЕДЕНИЯНаименование изделия: Радиофотонный SDR-приемник со встроенной печатной антенной и нейросетевой фильтрацией помех.Область применения: Высокоточный панорамный радиоперехват, обнаружение и пеленгация сигналов БПЛА (FHSS/прыгающие частоты), Wi-Fi каналов связи и средств РЭБ в условиях сильного заградительного радиопротиводействия.Исполнение: Моноблочное, карманное, в экранированном алюминиевом корпусе.2. НАЗНАЧЕНИЕ И ЦЕЛИ СОЗДАНИЯ ИЗДЕЛИЯНазначение: Прием, селекция, демодуляция и беспроводная/проводная трансляция радиосигналов в диапазоне от 0 до 7 ГГц.Цель создания: Преодоление динамического тупика кремниевых SDR-приемников (типа HackRF One). Достижение экстремального динамического диапазона (не менее 115 дБ) за счет перевода радиосигнала в оптический домен и исключения интермодуляционных искажений смесителей (IMD3).3. ТЕХНИЧЕСКИЕ ТРЕБОВАНИЯ К ИЗДЕЛИЮ3.1. Требования к структуре и составным частям (Поузловой состав)Изделие должно конструктивно состоять из 4-х изолированных отсеков (толщина фрезерованных алюминиевых стенок Д16Т — строго 1.5 мм):Антенный модуль (Лицевая панель):Материал: СВЧ-текстолит FR-4 (толщина 0.8 мм).Канал А: 0–900 МГц (печатный диполь/меандр).Канал Б: 1.2–3.0 ГГц (микрополосковая патч-решетка 2×2, расчетный шаг: 91.7 мм).Канал В: 4.0–7.0 ГГц (микрополосковая решетка 4×4).Маршрутизация: Копланарные волноводы с заземлением (GCPW) 50 Ом (ширина 1.2 мм, зазор 0.2 мм).Отсек 1 (СВЧ-тракт и селекция):СВЧ-коммутатор на бескорпусных PIN-диодах КА507/КА509 для мгновенного запирания входа.Миксер 1 (1.2–3 ГГц): Балансный диодный мост на GaAs диодах Шоттки 3А112А. Фиксированный гетеродин 2.0 ГГц.Миксер 2 (4.0–7 ГГц): Балансный диодный мост на диодах 3А112А. Фиксированный гетеродин 5.15 ГГц (LNB-стабилизация).ТВ-Селектор каналов: Супергетеродинный модуль KS-H-132 с варакторной фильтрацией. Выходная ПЧ: 38 МГц.Буферный УПЧ: Малошумящий СВЧ-транзистор КТ368А (ток коллектора 5 мА, Класс А, \(R_e = 100 \ \Omega\)).Защитная вилка: Встречно-параллельная пара диодов КД522 / 1N4148 для ограничения размаха синусоиды на уровне \(U_{\text{пп}} \le 0.63 \text{ В}\) (Drive Level защита кварца).Отсек 2 (Акустооптическая камера):Пьезопреобразователь: Вскрытый кварцевый резонатор 38 МГц (HC-49/U), приклеенный эпоксидным компаундом.Звукопровод: Брусок литьевого оргстекла ТОСП по ГОСТ 17622-72 размером 20 × 30 × 5 мм. Полировка торцов до зеркала (\(R_z \le 0.025 \text{ мкм}\)). Косой срез 45° с поролоновым поглотителем звука.Оптический зонд: Полупроводниковый красный лазерный диод от DVD-привода (650 нм).Драйвер лазера: Стабилизатор постоянного тока (45 мА) на операционном усилителе К140УД7 и транзисторе КТ368А.Пространственный фильтр: Нож Фуко (бритвенное лезвие) на винте М3×0.25 с антилюфтовой пружиной.Фотоприемник: Дифференциальная PIN-матрица BPW34 / SFH203 (\(C_j \le 72 \text{ пФ}\)). Фиксированный пространственный шаг (Pitch) между центрами площадок: строго 0.915 мм.Отсек 3 (FPAA и Сопроцессор STM32):Самодельная FPAA-матрица: Прецизионный трансимпедансный усилитель на К140УД7 + дифференциальный вычитатель постоянной лазерной подложки (1 мА) на К140УД8.Сопроцессор: STM32 Blue Pill (STM32F103C8T6). Настройка АЦП на режим одновременного параллельного сканирования PA0/PA1 с потоковой буферизацией через DMA.Алгоритм: Прошитая в ядро Cortex-M3 квантованная int8 TinyML-модель (TensorFlow) для вычитания паттернов помех РЭБ.Отсек 4 (Цифровой беспроводной мост ESP32):Центральный контроллер: ESP32 WROOM (Dual Core). Ядро 0 принимает поток SPI (Slave, 18 МГц) на скорости 4.0 MSPS без слепых зон в глубокий кольцевой буфер ОЗУ.Излучатель Wi-Fi: Встроенная текстолитовая PCB-антенна (змейка). Направлена в противоположную от СВЧ-входа сторону — наружу через радиопрозрачное пластиковое (оргстекло) окно в торце алюминиевого корпуса. Передача данных осуществляется асинхронными короткими вспышками (Burst Streaming).Термостабилизация: Аппаратный таймер Ядра 1 ESP32 генерирует меандр частотой 125 кГц (алгоритм 2-Tone) для циклической коммутации фазы СВЧ PIN-ключей (38/76 МГц), блокируя нагрев оргстекла.3.2. Требования к электромагнитной совместимости и фильтрации питанияПитание системы должно осуществляться по схеме «Звезда» от чистого химического источника (Li-Po аккумулятор 2S 7.4В / 3S 11.1В).Для питания цифровой части (ESP32) должен применяться импульсный Buck-конвертер с установкой буферного электролитического конденсатора емкостью не менее 1000 мкФ для гашения Wi-Fi вспышек.На границе перегородки Отсека 4 в цепь питания должен быть аппаратно врезан СВЧ-фильтр: дроссель BLM18 (Ferrite Bead) и шунтирующая керамика 10 нФ + 33 пФ для блокировки наводок частотой 2.4 ГГц.Аналоговая СВЧ и оптическая часть (Тюнер, Лазер, ОУ, STM32 АЦП) должна питаться исключительно от стерильного линейного регулятора LDO (LM7805).4. ОСНОВНЫЕ ПАРАМЕТРЫ И ЭКСТРЕМАЛЬНЫЕ ДИАПАЗОНЫ СИГНАЛОВРазрабатываемое изделие должно строго соответствовать рассчитанной математической матрице допусков:Входной диапазон частот радиоэфира: \(0 \dots 7 \cdot 10^9 \text{ Гц}\) (0 – 7 ГГц).Диапазон входной РЧ-мощности: -110 дБм (порог обнаружения) \(\dots 0 \text{ дБм}\) (предел компрессии, зажатый защитными диодами).Частота волновой решетки в оргстекле ТОСП: строго \(\Lambda = \mathbf{71.05 \text{ мкм}}\) на промежуточной частоте 38 ⋅ 10⁶ Гц.Критерий режима Брэгга (Параметр Клейна-Кука): строго \(Q = \mathbf{10.88}\) (гарантия отсутствия паразитного многоволнового шума).Угол дифракции луча в свободном воздухе: \(2\theta_B = \mathbf{0.524^\circ}\) (0.00915 рад).Пространственный шаг размещения фотодиодов (Pitch): строго \(\Delta x = \mathbf{0.915 \text{ мм}}\) при оптическом плече L = 100 мм.Диапазон выходного фототока на пинах PIN-матрицы: от 100 нА (ограничено темновым током кремния при отсутствии сигнала) до 600 мкА (при пиковой безопасной раскачке кварца).Результирующий динамический диапазон системы: не менее 75.5 дБ (чистый аналоговый тракт) и не менее 115 дБ при активации DMA-оверсемплинга и TinyML-фильтрации на STM32.5. ТРЕБОВАНИЯ К ПРОГРАММНОМУ ОБЕСПЕЧЕНИЮ ВЕР ИФИКАЦИИ (DevOps)Среда разработки встроенного ПО: PlatformIO (Arduino C++ / ESP-IDF) для STM32 и ESP32.Среда разработки аппаратной части: Atopile (.ato) для автогенерации нетлистов и проверки правил топологии в KiCad.Математическая верификация: В репозиторий Forgejo должен быть интегрирован сквозной FMU-блок симуляции на языке Octave/MATLAB (photonic_sdr_fmu.m), автоматически проверяющий стабильность геометрических и токовых параметров при каждом git push.
