maximmalin/simul/work/tz-d/block3_fpaa_stm32.md

***[ГОСТ 34.602-89]***

**ПЕРЕДАЧА ТЕХНИЧЕСКОГО ЗАДАНИЯ**

На разработку изделия: **Нейро-фильтрация и оверсемплинг (Отсек 3)** для приёмника Brig Receiver

Шифр темы: **B3_FPAA_STM32**

> Документ составлен по образцу РГР «Перетворювач з 5 на 9В» (КПІ, 2024) + ГОСТ 34.602-89, ГОСТ 2.114-2016 (ЕСКД).

---

## 1. ОБЩИЕ СВЕДЕНИЯ

### 1.1. Наименование изделия
**ФПАА + сопроцессор STM32 (отсек 3)** — узел 3.x структурной схемы `structural.drawio`.

### 1.2. Область применения
Аналого-цифровая обработка слабого фототока с выходов PIN-матрицы (узел 2.6): трансимпедансное преобразование, вычитание постоянной засветки лазера, параллельное сканирование АЦП, вычитание паттернов помех РЭБ с помощью TinyML-модели на STM32F103C8T6.

### 1.3. Исполнение
Самодельная FPAA-матрица на советских операционных усилителях (К140УД7, К140УД8) + STM32 Blue Pill (STM32F103C8T6) с прошитой int8 TinyML-моделью (TensorFlow Lite Micro). Питание: стерильный LDO 5В.

---

## 2. НАЗНАЧЕНИЕ И ЦЕЛИ СОЗДАНИЯ

### 2.1. Назначение
Преобразование дифференциального фототока (100 нА – 600 мкА) в цифровые I/Q-числа, очистка от DC-составляющей лазера (1 мА) и паттернов помех РЭБ, выдача очищенного цифрового потока на SPI (4.0 MSPS) в отсек 4 (ESP32).

### 2.2. Цель создания
Достижение динамического диапазона ≥ 75.5 дБ на чистом аналоговом тракте + ≥ 115 дБ с активацией DMA-оверсемплинга и TinyML-фильтрации на STM32.

---

## 3. ТЕХНИЧЕСКИЕ ТРЕБОВАНИЯ К ИЗДЕЛИЮ

### 3.1. Требования к структуре (поузловой состав)

Отсек 3 должен содержать 3 изолированных узла:

#### Узел 3.1 — Трансимпедансный усилитель (К140УД7)
- Функция: преобразование тока фотодиодов (100 нА – 600 мкА) в напряжение
- К140УД7: прецизионный операционный усилитель
- Коэффициент трансимпеданса: R_f = 10 кОм – 100 кОм (настраиваемый)
- Питание: стерильный LDO 5В

#### Узел 3.2 — Дифференциальный вычитатель (К140УД8)
- Функция: аппаратное вычитание постоянной засветки лазера (1 мА)
- К140УД8: дифференциальный операционный усилитель
- Вход: трансимпедансный сигнал от узла 3.1
- Выход: очищенный аналоговый сигнал (AC-компонента только)
- Питание: стерильный LDO 5В

#### Узел 3.3 — АЦП STM32 (STM32F103C8T6)
- Микроконтроллер: STM32F103C8T6 (Cortex-M3, 72 МГц)
- Режим АЦП: непрерывное параллельное сканирование PA0/PA1
- Разрядность: 12 бит
- Потоковый захват буфера в ОЗУ через DMA
- Частота дискретизации: 4.0 MSPS (за счёт DMA)
- Вход: очищенный аналоговый сигнал от узла 3.2

#### Узел 3.4 — Ядро TinyML (Edge Inference)
- Модель: квантованная int8 TinyML-модель (TensorFlow Lite Micro)
- Функция: математическое вычитание паттернов помех РЭБ из I/Q-потока
- Разрядность: int8 (квантование весов)
- Размещение: во флеш-памяти STM32F103C8T6
- Вход: цифровой поток от АЦП (узел 3.3)
- Выход: очищенный I/Q-поток на SPI (узел 4.1)

### 3.2. Требования к электромагнитной совместимости и фильтрации питания

- Питание от стерильного LDO (LM7805, узел 5.3)
- Аналоговая часть (К140УД7, К140УД8) должна питаться исключительно от стерильного линейного регулятора
- STM32: отдельный таймер ядра 1 для генерации меандра 125 кГц (алгоритм 2-Tone)

---

## 4. ОСНОВНЫЕ ПАРАМЕТРЫ И ЭКСТРЕМАЛЬНЫЕ ДИАПАЗОНЫ СИГНАЛОВ

| Параметр | Значение | Ед. |
|---|---|-----|
| Диапазон входного фототока | 100 нА – 600 мкА | А |
| Постоянная засветка лазера (вычитается) | 1 мА (эквивалентный ток) | мА |
| Коэффициент трансимпеданса R_f | 10 кОм – 100 кОм | Ом |
| Разрядность АЦП | 12 бит | бит |
| Частота дискретизации (DMA) | 4.0 млн отсчётов/с | с⁻¹ |
| Частота тактирования STM32 | 72 | МГц |
| Ядро TinyML: тип модели | int8 quantized | — |
| Динамический диапазон (чистый аналоговый тракт) | ≥ 75.5 | дБ |
| Динамический диапазон (с DMA + TinyML) | ≥ 115 | дБ |

---

## 5. ТРЕБОВАНИЯ К ПРОГРАММНОМУ ОБЕСПЕЧЕНИЮ ВЕРИФИКАЦИИ (DevOps)

- Среда разработки встроенного ПО: PlatformIO (Arduino C++ / ESP-IDF) для STM32 и ESP32
- Математическая верификация: FMU-блок симуляции Octave/MATLAB (`photonic_sdr_fmu.m`) в репозиторий Forgejo, проверка стабильности геометрических и токовых параметров при каждом git push
- ТinyML-модель: TensorFlow Lite Micro, квантование int8, обучение на паттернах помех РЭБ

---

## ДОДАТОК А. Схема электрическая принципиальная

- FPAA-цепь: PIN-матрица → трансимпедансный усилитель (К140УД7) → дифференциальный вычитатель (К140УД8) → АЦП STM32 (PA0/PA1) → TinyML ( Cortex-M3) → SPI (4.0 MSPS)
- Питание: стерильный LDO 5В для аналоговой части, 5В цифровой для STM32

---

## ДОДАТОК Б. Перечень элементов

| Узел | Компонент | Количество | Примечание |
|---|---|---|---|
| 3.1 | ОУ К140УД7 | 1 | трансимпедансный, R_f настраиваемый |
| 3.2 | ОУ К140УД8 | 1 | дифференциальный вычитатель |
| 3.3 | STM32F103C8T6 (Blue Pill) | 1 | Cortex-M3, 72 МГц, 12-бит АЦП |
| 3.4 | Flash-память STM32 | 1 | TinyML модель int8 |
| Питание | LDO LM7805 | 1 | стерильный |

---

## ДОДАТОК В. Кресление друкованной платы

- Для отсека 3: одна плата с FPAA-матрицей и STM32
- Разводка по звезде: аналоговая и цифровая части разделены
- Экранирование: алюминиевая стенка 1.5 мм (Д16Т), изоляция ≥ 80 дБ

---

## ДОДАТОК Г. Кресление электронного модуля

- FPAA-матрица на дискретных советских ОУ (К140УД7, К140УД8)
- STM32 Blue Pill (STM32F103C8T6) на плате с разъёмом для отладки

---

## ДОДАТОК Д. Спецификация на электронный модуль

- Узел 3.x — 4 подузла: трансимпедансный УС, дифференциальный вычитатель, АЦП STM32, TinyML-ядро
- Коэффициент трансимпеданса: 10 кОм – 100 кОм
- Частота дискретизации: 4.0 MSPS (DMA)
- ТinyML-модель: int8 quantized, TensorFlow Lite Micro
- Динамический диапазон: ≥ 75.5 дБ (аналог) + ≥ 115 дБ (с DMA + TinyML)
