maximmalin/simul/requirements/reception_range.md

# Дальность приёма по разделам требований (reception distance)

Документ сводит **дальность приёма** (reception distance) — максимальное
расстояние, на котором приёмник различает сигнал с требуемым отношением
сигнал/шум, — к каждому разделу матрицы требований
(`requirements/requirements_matrix.csv`).

## Модель

Дальность считается по уравнению Friis с порогом приёмника:

```
S_min = k·T₀·B·NF + SNR        (REQ-04: NF = 3.5 дБ; REQ-36/37: B = 2.7 кГц, SNR = 10 дБ)
R     = λ/(4π) · 10^((EIRP + G_rx − S_min)/20)
```

Опорные параметры — `sim/scripts/link_budget.py` (цель `make link-budget`):

| Параметр | Значение |
|---|---|
| Шумовая дорожка N (2.7 кГц, NF 3.5 дБ) | −136.2 дБм (≤ −120 дБм, REQ-37 ✓) |
| Порог S_min (MDS) | −126.2 дБм (≤ −110 дБм, REQ-37 ✓) |
| EIRP источника (опорный) | +30 дБм (1 Вт) |
| Запас на помехи/многолучёвость | 20 дБ |

## Дальность радиовидимости по каналам

| Канал | f | G_rx | Радиовидимость | С запасом 20 дБ |
|---|---|---|---|---|
| A — змейка 200 МГц | 200 МГц | 2.15 дБи | 9 821 км | 982 км |
| Б — решётка 2×2 2.45 ГГц | 2.45 ГГц | 6.0 дБи | 1 249 км | 125 км |
| В — решётка 4×4 5.8 ГГц | 5.8 ГГц | 12.0 дБи | 1 053 км | 105 км |

> Дальности приёмника — «в свободном пространстве». При подавлении внешней
> помехи на 40…60 дБ (REQ-22) гарантированная дальность составляет
> **0.1…10 км** (наихудший канал В — около 0.1 км при 60 дБ десенса).

## Дальность по разделам

### Раздел 1 — Общие сведения (цели проекта: полоса, динамический диапазон)
Дальность приёма определяет целевой ориентир по дальности обнаружения.
Максимум — по каналу A (200 МГц): **982 км** (радиовидимость 9 821 км).
См. REQ-01 (мгновенная полоса) и REQ-02 (динамический диапазон).

### Раздел 2 — Радиочастотный тракт (RF Frontend)
Дальность задаётся чувствительностью тракта (NF ≤ 3.5 дБ, REQ-04) и
шумовой дорожкой (REQ-37): **982 км** (канал A, реальная обстановка).
MDS = −126.2 дБм ≤ −110 дБм.

### Раздел 3 — Акустооптический процессор (АО-процессор)
Дальность приёма определяется **RF-трактом**, а не оптической обработкой
(АО-ядро работает с уже принятым сигналом и не меняет радиус приёма).
Значение — как в разделе 2: **982 км**.

### Раздел 4 — Климатические и механические условия
В рабочем диапазоне температур (+15…+30 °C, REQ-16) и влажности
(≤ 80 %, REQ-18) дальность не изменяется: **982 км**.

### Раздел 5 — Электромагнитная совместимость (ЭМС)
Дальность под воздействием внешнего поля 3 В/м (REQ-22) после подавления
помехи на 40…60 дБ: **1…10 км** (гарантированная дальность при ЭМС).
См. `tests/requirements/emc/`.

### Раздел 6 — Надёжность и безопасность
Дальность сохраняется на протяжении всего срока службы
(MTBF ≈ 2.05·10⁶ ч по REQ-26): **982 км**.

### Раздел 7 — Упаковка, транспортирование и консервация
Дальность приёма при хранении/транспортировании не нормируется — **н/д**.

### Раздел 8 — Требования к программному обеспечению (HOST API)
Дальность приёма не зависит от ПО; однако оценка дальности/пеленга
доступна в API/отчёте (разделы «Дальность приёма» и «Пеленгация») — **н/д**.
