maximmalin/simul/requirements/mechanics/REQ-MECH-01_enclosure.md

# REQ-MECH-01 — Корпус и экранирование

**Подсистема:** Механика / корпус
**Задание агента:** `AGENT_ENCLOSURE.md` (FreeCAD-модель)

- **Требование:** Корпус из фрезерованного алюминия с толщиной стенки ≥ 0.5 мм, разделённый перегородками на три секции с радиочастотными электропроводящими прокладками.
- **Стандарт:** MIL-DTL-83528 (прокладки), IPC-2221 Class 2 / ГОСТ Р 51418-620.1 (зазоры), CISPR 22-2012 (экранирование).
- **Проект:** `hardware/enclosure/krystal-case.FCStd`, `krystal-case.step`.

### Сквозной расчёт физики

Глубина скин-слоя алюминия:

δ = √(2ρ/(ω·μ₀·μᵣ)), ρ = 2.65·10⁻⁸ Ом·м

| частота | δ |
|---|---|
| 1 ГГц | 2.59 мкм |
| 7 ГГц | 0.98 мкм |

При толщине стенки 0.5 мм и f = 1 ГГц коэффициент поглощения
A = 8.686·t/δ ≈ **1677 дБ** — сам металл даёт практически неограниченное
экранирование. Реальный предел задают не стенки, а стыки, щели, окна
и разъёмы, поэтому нормой является **контактное сопротивление прокладок
≤ 10 мОм**, а не толщина.

Компонент отражения R = 168 − 20·log₁₀(f·r) + 20·log₁₀(√(σ_Cu/σ_Al))
при f = 1 ГГц, r = 0.1 м даёт **10.2 дБ**.

### Материалы

| элемент | материал | примечание |
|---|---|---|
| стенки, перегородки | Al 6061-T6 или Al Mg3 | σ ≈ 3.5·10⁷ См/м |
| прокладки | токопроводящий эластомер | R ≤ 10 мОм до 10 ГГц |
| винт заземления | М3, ГОСТ 14192-96 | знак «Заземление», 0.5 Н·м |
| отсек силикагеля | герметичный карман | ГОСТ 3956-76 тип V, ≈ 8 г / 500 см³ |

### Построенная модель

Габариты платы взяты из `out/circuit.json` (88.6 × 85.1 × 1.6 мм).

| параметр | значение |
|---|---|
| наружный размер | 92.6 × 89.1 × 17.5 мм |
| стенка | 0.5 мм Al |
| дно / крышка | 2.0 / 1.5 мм |
| перегородки | 1.0 мм, 3 секции |
| рекурсия прокладки | 0.5 мм глубиной × 2.5 мм шириной, по периметру |
| отверстие силикагеля | Ø 3 мм |
| крепёж | 4 × М3 в углах дна |
| объём алюминия | 25 см³ (7 % от габаритного параллелепипеда) |

Три секции (REQ-MECH-02): ВЧ-аналоговая (слева, до X = 0.1·W),
цифровая и питание (справа, разделены по Y = 0.28·H).
