maximmalin/simul/requirements/baseband/REQ-BB-01_buffers.md

# REQ-BB-01 — Буферы полосы основных частот

**Подсистема:** Полоса основных частот (ПЧ = 0 Гц, complex I/Q)
**Аппаратная реализация:** `U_OP1` (OPA2134), `R_OPI`/`R_OPQ` 10 кОм, `C_OPI`/`C_OPQ` 100 пФ

- **Требование:** Дифференциальное усиление I и Q квадратур с размахом, достаточным для полной загрузки 12-разрядного АЦП, и коэффициентом шума, не ухудшающим тракт.
- **Проверка:** `sim/scripts/verify_pin_contract.py` (контракт выводов PA0/PA1), ngspice.

### Сквозной расчёт физики

OPA2134 — малосигнальный прецизионный усилитель с полосой 8 МГц и
напряжением смещения ±5 В, что перекрывает диапазон ±3.3 В цифровой шины
с запасом на голову (headroom).

Усиление задаётся `R_OPI`/`R_OPQ` = 10 кОм в цепи обратной связи OPA2134:
коэффициент усиления 1+R = 11 при единичном резисторе обратной связи
не более 100 кОм, что соответствует точности предусилителя.

Размах на выходе буфера должен быть ≥ 2.5 В размах, чтобы загрузить
12-разрядный АЦП (4096 отсчётов) при полном использовании диапазона.
При 12 бит и опорном напряжении 3.3 В цена младшего значащего разряда:
q_LSB = 3.3 / 4096 ≈ **0.8 мВ**.

Конденсаторы `C_OPI`/`C_OPQ` = 100 пФ вместе с входным импедансом АЦП
образуют фильтр, срезающий ВЧ составляющие на частоте
f_c = 1/(2π·R·C) = 1/(2π·10·10³·100·10⁻¹²) ≈ **159 кГц** — это и есть
полоса ПЧ приёмника (REQ-PERF-02).
