maximmalin/simul/requirements/baseband/REQ-BB-02_adc.md

# REQ-BB-02 — Оцифровка I/Q в микроконтроллере

**Подсистема:** Оцифровка
**Аппаратная реализация:** `U1` (STM32F103C8T6), `TP_ADC_I`, `TP_ADC_Q`, `C_MCU1..C_MCU3`

- **Требование:** Оцифровка обеих квадратур I и Q встроенным АЦП с разрядностью 12 бит и частотой выборки ≥ 0.8 МГц, с фиксированным назначением выводов.
- **Стандарт:** STM32F103C8T6 datasheet (DM-00004189), раздел АЦП: f_ADC,max = 14 МГц.
- **Проверка:** `sim/scripts/verify_pin_contract.py` — 31 проверка контракта выводов.

### Контракт выводов

Жёсткий контракт между аналоговой и цифровой частями платы; проверяется
автоматически (`verify_pin_contract.py`) и не может быть изменён молча:

| вывод STM32 | назначение | источник |
|---|---|---|
| **PA0** | ADC_IN0 — квадратура **I** | `ADC_I_F` через `R_AF_I` |
| **PA1** | ADC_IN1 — квадратура **Q** | `ADC_Q_F` через `R_AF_Q` |
| **PA6** | гетеродин **LO** | `LO_SRC` через `R_LO` 50 Ом |
| **PA7** | управление усилением **GAIN** | `CTRL` |

### Сквозной расчёт физики

Цикл преобразования 12-разрядного АЦП = время выборки + 12.5 тактов
на сходимость. При минимальном времени выборки 1.5 такта полный цикл
составляет 14 тактов. Предельная частота такта АЦП по datasheet — 14 МГц:

f_max = 14·10⁶ / 14 = **1.0 MSPS**

При тактовой частоте ядра 72 МГц и делителе АЦП 6 (12 МГц):
f = 12·10⁶ / 14 ≈ **0.86 MSPS**.

> **Известное ограничение первой ревизии.** Частота выборки ограничена
> 1 MSPS, а не 2–4 MSPS. Значение `DEFAULT_SAMP_RATE = 2.4 МГц` в
> `src/gnuradio_krystal/virtual_iq.py` относится к **виртуальной**
> ко-симуляции GNU Radio, а не к аппаратному АЦП, и не является
> характеристикой приёмника.
>
> Следствие: требование «мгновенная полоса ≥ 500 МГц в реальном времени»
> (REQ-PERF-01) **не выполняется** этим АЦП. Для 500 МГц на выходе нужен
> АЦП ≥ 0.5 GSPS, что требует внешнего АЦП либо замены МК.
>
> Для расширения полосы в будущей ревизии: переход на STM32H7
> (до 3.6 MSPS встроенный АЦП) либо внешний АЦП с параллельным интерфейсом.
