maximmalin/simul/requirements/emc/REQ-EMC-01_shielding.md

# REQ-EMC-01 — Экранирование корпуса

**Подсистема:** ЭМС · **Связано с:** REQ-MECH-01, REQ-MECH-02

- **Требование:** Корпус из фрезерованного алюминия, разделённый на три изолированные секции, с радиочастотными электропроводящими прокладками.
- **Стандарт:** MIL-DTL-83528 (прокладки), ГОСТ CISPR 22-2012 Класс Б.
- **Проверка:** `tests/requirements/emc/test_emc.py::test_req_21_*` — 7 тестов.

### Сквозной расчёт физики

Глубина скин-слоя алюминия δ = √(2ρ/(ω·μ₀·μᵣ)) при ρ = 2.65·10⁻⁸ Ом·м:

| частота | δ | требуемая кратность |
|---|---|---|
| 1 ГГц | 2.59 мкм | 3δ = 7.8 мкм |
| 7 ГГц | 0.98 мкм | 3δ = 2.9 мкм |

При стенке 0.5 мм (500 мкм) толщина превышает 3δ более чем в 60 раз.

> **Исправленная ошибка исходной редакции.** Указывалось δ ≈ 0.025 мм при
> 1 ГГц — значение завышено примерно в 10 раз. Корректно δ ≈ 2.6 мкм.
> Тест `test_req_21_skin_depth_aluminium` падает при возврате старой цифры.

Эффективность экранирования складывается из отражения, поглощения и
переизлучения: SE ≈ R + A + B, где A = 8.686·t/δ.
При t = 0.5 мм и f = 1 ГГц: R ≈ 10.2 дБ, A ≈ 1677 дБ.

Практический предел задают стыки: норма — контактное сопротивление
прокладок **≤ 10 мОм** до 10 ГГц, а не толщина стенки.
