maximmalin/simul/requirements/emc/REQ-EMC-02_immunity.md

# REQ-EMC-02 — Иммунитет к внешним электромагнитным полям

**Подсистема:** ЭМС · **Связано с:** REQ-MECH-01, REQ-EMC-01

- **Требование:** Приёмник должен сохранять работоспособность при воздействии внешнего электромагнитного поля уровня жёсткости 2 (3 В/м) в диапазоне 80–2700 МГц.
- **Стандарт:** ГОСТ 30804.4.3-2013, IEC 61000-4-3 (уровень 2).
- **Проверка:** `tests/requirements/emc/test_emc.py::test_req_22_*` — 7 тестов.

### Критерий соответствия

Иммунитет по IEC 61000-4-3 — это критерий **функционирования**: прибор
не должен насыщаться и терять функции. Отношение сигнал/помеха при этом
ухудшается — это ожидаемо и не является нарушением.

### Сквозной расчёт физики

Мощность, наведённая внешним полем на эффективную длину антенны h,
в согласованном 50-омном входе:

U_ind = E·h,  P_ind = U_ind²/(4·R_вх)

При E = 3 В/м и h = 0.1 м: U_ind = 0.3 В, **P_ind = 4.5·10⁻⁴ Вт**.

> **Исправленная ошибка исходной редакции.** Указывалось 1.8·10⁻⁵ Вт —
> занижено примерно в 25 раз. Тест `test_req_22_induced_power_correct`
> падает при возврате старой цифры.

Доступная мощность поля на согласованной антенне 1 ГГц (диполь 1.5 дБи)
по формуле P = E²·G·λ²/(32π²) составляет ≈ 3.6 мВт (**+5.6 дБм**) —
на 130 дБ выше MDS (−126.16 дБм).

Помеха гасится двумя независимыми механизмами:

| механизм | ослабление | источник |
|---|---|---|
| экранирование корпуса | 40–60 дБ | REQ-EMC-01 |
| избирательность тракта (1000 МГц → 2.7 кГц ПЧ) | 55.7 дБ | REQ-BB-01 |

В сумме > 90 дБ. На входе смесителя (после 40 дБ экрана и 20 дБ усиления
LNA) помеха составляет −14…−34 дБм — с запасом >20 дБ до точки компрессии
1 дБ тракта (+10 дБм), то есть АЦП **не насыщается**.
