maximmalin/simul/requirements/emc/REQ-EMC-03_emission.md

# REQ-EMC-03 — Уровень радиопомех

**Подсистема:** ЭМС · **Связано с:** REQ-PWR-01, REQ-MECH-02

- **Требование:** Уровень индустриальных радиопомех, создаваемых приёмником, не должен превышать норм ГОСТ CISPR 22-2012 (Класс Б).
- **Стандарт:** ГОСТ CISPR 22-2012 / EN 55022 / CISPR 32.
- **Проверка:** `tests/requirements/emc/test_emc.py::test_req_23_*` — 5 тестов.

### Нормы Класс Б (квазипиковый детектор, 3 м)

| диапазон | предел |
|---|---|
| 30–1000 МГц | 40 дБмкВ/м |
| 0.5–5 ГГц | 47 дБмкВ/м |

### Источники помех приёмника

| источник | механизм | мера |
|---|---|---|
| `U1` STM32F103C8T6, 72 МГц | переключение ядра и периферии, гармоники 72·n МГц | экран цифровой секции |
| `Y1` XTAL 8 МГц | тактовые гармоники | разделение с ВЧ-трактом |
| `J_USB` USB CDC | синхронизирующие переходы, кабель как антенна | фильтр на входе питания |
| `U_LDO` AMS1117-3.3 | пульсации нагрузки | `C_LDO1` 100 мкФ, `C_LDO2` 100 нФ |
| `U_MIX1` LT5560 | ВЧ-излучение смесителя | ВЧ-секция под экраном |

Количество гармоник тактовой в нормируемой полосе 30–1000 МГц:
1000/72 ≈ 13 гармоник — все они попадают под норму Класс Б и должны
подавляться экранированием и фильтрацией.

> В исходной редакции источником помех указывался Wi-Fi модуль ESP32
> на частотах 2.4 и 5 ГГц. Беспроводной связи в Krystal Radio нет:
> вывод данных — USB CDC, микроконтроллер — STM32F103C8T6.
