maximmalin/simul/requirements/emc/REQ-EMC-04_supply_filters.md

# REQ-EMC-04 — Фильтры питания

**Подсистема:** ЭМС · **Связано с:** REQ-PWR-01, REQ-PWR-02

- **Требование:** Линии питания (+5V вход, +3V3 цифровая, +3V3_ANA аналоговая, GND) должны быть снабжены развязывающими конденсаторами и ферритами для подавления ВЧ-шума.
- **Проверка:** `tests/requirements/emc/test_emc.py::test_req_24_*` — 6 тестов.

### Сквозной расчёт физики

Частота среза фильтра «индуктивность + ёмкость»:

f_c = 1/(2π·√(L·C))

| фильтр | L | C | f_c |
|---|---|---|---|
| LC-фильтр (справочный) | 10 мкГн | 100 нФ | **159 кГц** |
| накопление AMS1117 | — | 100 мкФ | 1.6 кГц |
| ВЧ-шунт | — | 100 нФ | > 1 МГц |
| буфер ОУ (REQ-BB-01) | 10 кОм | 100 пФ | 159 кГц |

> **Исправленная ошибка исходной редакции.** Указывалось f_c ≈ 16 кГц при
> L = 10 мкГн, C = 100 нФ. Расчёт даёт 1/(2π·√(10⁻⁵·10⁻⁷)) = 1/(2π·10⁻⁶)
> ≈ **159 кГц** — на порядок выше. Тест `test_req_24_lc_cutoff_correct`
> падает при возврате старой цифры.

Феррит `FB1` (600 Ом @ 100 МГц) даёт ослабление на аналоговой шине:
35.6 дБ @ 100 МГц, 55.6 дБ @ 500 МГц, при этом сопротивление
постоянному току практически нулевое.

Без развязки ВЧ-шум от нагрузки проникал бы в приёмный тракт и ухудшал
NF с нормы 3.5 дБ (REQ-RF-02), что снижает чувствительность.
