maximmalin/simul/requirements/environment/REQ-ENV-01_temperature.md

# REQ-ENV-01 — Температурные режимы

**Подсистема:** Условия эксплуатации

- **Требование:** Рабочий диапазон +15…+30 °C; предельный (хранение) −40…+50 °C.
- **Стандарт:** ГОСТ 15150-69 (климатическое исполнение УХЛ4), МКБ по MIL-STD-810G.
- **Проверка:** `sim/scripts/thermal_pcb.py` → `out/thermal_fast.json`, `out/thermal_fem.json`.

### Температурный дрейф

Уход частоты задаётся кварцевым резонатором `Y1` (8 МГц) и ёмкостями монтажа:

Δf/f = (α_T + ΔK_v)·ΔT

| параметр | значение |
|---|---|
| α_T (кварцевый КТР) | 0.03 ppm/°C |
| ΔK_v (ёмкость монтажа) | ≈ 3 ppm/°C |
| суммарно | ≈ 3 ppm/°C |

При ΔT = 30 °C уход составляет 0.8 ppm, что на частоте 2.45 ГГц
даёт ≈ 2 кГц — в пределах полосы ПЧ 2.7 кГц (REQ-BB-01).
Активная термостабилизация не требуется.

> В исходной редакции удержание ±0.1 °C обеспечивалось элементами Пельтье
> и ПИД-регулятором на ПЛИС — под акустооптическую схему с лазером и
> кристаллом TeO₂. В zero-IF приёмнике такой системы нет, и она
> не нужна: вклад ухода укладывается в допустимую погрешность.
