maximmalin/simul/requirements/environment/REQ-ENV-02_humidity_vibration.md

# REQ-ENV-02 — Влажность, вибрация, консервация

**Подсистема:** Условия эксплуатации и хранения

## Влажность
- **Требование:** Относительная влажность не более 80 % при +25 °C без образования конденсата.
- **Стандарт:** ГОСТ 9.014-78, ГОСТ 3956-76 (силикагель).

При RH > 80 % на плате возможна конденсация: капли на ВЧ-тракте
(`J_ANT`, `U_MIX1`, `U_OP1`) и на входе АЦП меняют коэффициент передачи
и увеличивают шум. Для zero-IF приёмника это **основной климатический
риск**: оптического канала нет, защищать нечего, кроме самой платы.

Меры: герметичный корпус с силикагелем (тип V) из расчёта ≈ 8 г на
объём ≈ 500 см³ (поглощение до 25 % массы), влагозащитное покрытие
ВЧ-тракта, сушка при вскрытии (REQ-ENV-03).

## Вибрация
- **Требование:** Устойчивость к вибрации 10–55 Гц с амплитудой смещения до 0.15 мм.
- **Стандарт:** MIL-STD-810G, метод 514.

Вибрация вызывает не оптическую модуляцию, а изменение паразитных
параметров: рассогласование SMA-разъёма `J_ANT` и пьезоэлектрический
эффект на конденсаторах и резонаторе `Y1`.

Рассогласование при размыкании 0.15 мм даёт |S₁₁| −18…−10 дБ вместо
требуемых ≤ −18 дБ, что снижает уровень полезного сигнала.

Меры: разъём с фиксацией, крепление SMA к корпусу, виброизоляция
ВЧ-зоны, жёсткое крепление платы в 4 точках.

## Консервация
- **Требование:** Консервация ВЗ-10 — герметичный чехол с просушкой.
- **Стандарт:** NATO STANAG 4280 / Def Stan 81-41, уровень A.

В чехол закладывается активированный силикагель по ГОСТ 3956-76 (тип V).
Расчётная масса ≈ 8 г на объём ≈ 500 см³. Срок сохраняемости без
переконсервации — не менее 3 лет.

После 3 лет силикагель насыщается, и при первом включении возможна
конденсация на ВЧ-тракте и входе АЦП — необходима переконсервация
или сушка 80 °C в течение 2 часов.
