maximmalin/simul/requirements/power/REQ-PWR-01_supply.md

# REQ-PWR-01 — Цепь питания

**Подсистема:** Питание
**Аппаратная реализация:** `J_PWR` (USB_B, 5V_IN), `U_LDO` (AMS1117-3.3), `C_LDO1` 100 мкФ, `C_LDO2` 100 нФ, `C_MCU1..3`

- **Требование:** Линейное питание 5 В → 3.3 В без импульсных преобразователей, с развязкой на каждом выводе потребителя.
- **Проверка:** ngspice `.op` — `sim/scripts/thermal_pcb.py` (расчёт потерь), `tests/requirements/emc/test_emc.py::test_req_24_*`.

### Сквозной расчёт физики

```
J_PWR (USB-B, 5V_IN)
   └── U_LDO AMS1117-3.3 ── +3V3
         ├── C_LDO1  100 мкФ   накопление, сглаживает шаг нагрузки
         ├── C_LDO2  100 нФ    ВЧ-шунт
         ├── C_MCU1  100 нФ    развязка U1
         ├── C_MCU2  100 нФ    развязка Y1
         └── C_MCU3  4.7 мкФ   ВН-фильтр питания U1
```

Расчёт тока: AMS1117-3.3 в SOT-223 допускает до 1 А. Потребление платы:
STM32F103 ≈ 25 мА, LT5560 ≈ 30 мА, 2N7002 ×2 ≈ 6 мА, OPA2134 ≈ 7 мА,
светодиоды/прочее ≈ 2 мА — итого **≈ 70 мА**, что составляет 7 % от
максимума и обеспечивает запас по рассеиванию.

Импульсный преобразователь отсутствует намеренно: его тактовая частота
давала бы спектральную плотность помех на порядок выше, чем у линейного
стабилизатора (REQ-EMC-03).
