maximmalin/simul/requirements/power/REQ-PWR-02_analog_rail.md

# REQ-PWR-02 — Аналоговая шина и развязка от ВЧ-помех

**Подсистема:** Питание
**Аппаратная реализация:** `FB1` (600 Ом @ 100 МГц), `C_ANA1` 10 мкФ, `C_ANA2` 100 нФ, `L_MIX` (600 Ом @ 100 МГц), `C_MIX3` 100 нФ

- **Требование:** Аналоговая шина `+3V3_ANA` должна быть изолирована от цифровой `+3V3` ферритом, чтобы ВЧ-шум цифровой части не попадал в усиливаемый тракт.
- **Проверка:** `tests/requirements/emc/test_emc.py::test_req_24_ferrite_isolation`.

### Сквозной расчёт физики

`FB1` — ферритовая бусинка с импедансом 600 Ом на 100 МГц и практически
нулевым сопротивлением на постоянном токе. Это развязывает ВЧ-шум
цифровой шины, сохраняя постоянную составляющую питания.

Полоса подавления: при 100 МГц ослабление 35.6 дБ, при 200 МГц — 41.6 дБ,
при 500 МГц — 55.6 дБ (рост ~20 дБ на декаду).

Отдельная ферритовая бусинка `L_MIX` питает смеситель `U_MIX1`:
это защищает вход усиления от тактовых гармоник STM32 (72 МГц и его
гармоники в диапазоне 0–7 ГГц, где и сосредоточено экранирование).

Частота среза шунтирующего конденсатора 100 нФ:
|X_C| при 1 ГГц = 1/(2π·10⁹·100·10⁻⁹) ≈ **1.6 Ом** — практически
закорачивает ВЧ на землю во всём рабочем диапазоне.

Аналоговая шина питает: `Q_LNA2`, `U_MIX1`, `U_OP1` — то есть только
аналоговые каскады. Цифровые (`U1`, `Y1`) питаются от `+3V3` напрямую.
