maximmalin/simul/requirements/reliability/REQ-REL-01_mtbf.md

# REQ-REL-01 — Надёжность

**Подсистема:** Надёжность · **Связано с:** REQ-ENV-01

- **Требование:** MTBF при эксплуатации не менее 10 000 часов.
- **Проверка:** `sim/octave/reliability_model.m` → `out/reliability.json`; `tests/requirements/reliability/`.

### Модель

Parts-count + ускорение Аррениуса для каждого элемента:

λ_total = Σ λ_i(T_use)

где λ_i(T) = λ_i,ref · exp(−Ea/k · (1/T_use − 1/T_ref)),
T_use = 308 K (+35 °C), T_ref = 298 K (+25 °C).

### Элементы и их вклад

| элемент | кол-во | роль |
|---|---|---|
| STM32F103C8T6 | 1 | МК, тактовые гармоники |
| LT5560 | 1 | смеситель |
| OPA2134 | 1 | буферы ПЧ |
| 2N7002 | 2 | усилители |
| AMS1117-3.3 | 1 | стабилизатор |
| LPJ-1 | 1 | фильтр |
| конденсаторы MLCC | 22 | развязка, согласование |
| резисторы | 16 | делители, нагрузки |
| ферриты | 2 | развязка ВЧ |
| кварц 8 МГц | 1 | тактирование |
| SMA / USB-B | 2 | разъёмы |

Параметры (base FIT, Ea, T_ref, T_use) — в
`sim/octave/reliability_parts.tsv`.

### Результат

MTBF ≈ **2.05·10⁶ ч**, что превышает норму 10 000 ч более чем на два
порядка. Запас обусловлен тем, что критичные элементы (конденсаторы,
кварцевый резонатор) имеют базовую надёжность 10⁻⁷ и выше, а
полупроводниковые приборы работают при малом повышении температуры
относительно опорной.

> В исходной редакции строка MTBF «Лазерный диод ≈ 10 000 ч»
> относилась к оптическому изделию. Здесь указаны реальные элементы платы.
