maximmalin/simul/requirements/rf/REQ-RF-02_lna.md

# REQ-RF-02 — Малошумящие усилители

**Подсистема:** ВЧ (радиочастотная часть)
**Аппаратная реализация:** `Q_LNA1` (2N7002, общий затвор), `Q_LNA2` (2N7002), `X_QWC1` (LPJ-1), `R_G1..R_G4`, `L_LNA1/L_LNA2` 18 мкГн

- **Требование:** Два каскада усиления с суммарным коэффициентом шума тракта ≤ 3.5 дБ и усилением ≥ 15 дБ в диапазоне 0–7 ГГц.
- **Стандарт:** IEEE Std 145 ( Noise Figure).
- **Проверка:** `tests/requirements/rf/test_rf.py`, каскадный расчёт Friis.

### Сквозной расчёт физики

LNA1 включён по схеме общего затвора (common-gate): вход и выход на истоке,
затвор подключён к входу через `C_IN` 100 пФ и смещён делителем
`R_G1`/`R_G2` = 10 кОм/10 кОм. Такая схема даёт развязку по выходу
при 180° фазовом сдвиге и полное согласование по входу без трансформатора.

Каскадное сложение по Friis:

| каскад | NF, дБ | G, дБ | вклад в NF_total |
|---|---|---|---|
| `Q_LNA1` | 2.0 | 10 | 2.00 |
| `X_QWC1` LPJ-1 | 0.5 | −1.5 | ≈ 0.00 |
| `Q_LNA2` | 2.0 | 10 | 0.09 |
| `U_MIX1` LT5560 | 8.0 | 6 | 0.05 |

NF_total ≈ 2.14 дБ — с запасом укладывается в 3.5 дБ.
Доминирует первый каскад: все последующие в сумме дают менее 0.15 дБ.

Инд��кторы `L_LNA1`/`L_LNA2` (18 мкГн) — дроссели развязки питания
нагрузочного затвора, они не входят в полосу усиления.
