maximmalin/simul/requirements/rf/REQ-RF-03_filter.md

# REQ-RF-03 — Полосовой фильтр и согласование со смесителем

**Подсистема:** ВЧ (радиочастотная часть)
**Аппаратная реализация:** `L_BS1` 100 мкГн, `C_BS1` 100 пФ, `C_BS2` 10 пФ, `R_BS` 1 кОм, `C_MIX1/C_MIX2` 100 пФ, `TP_FIL`

- **Требование:** Полосовой фильтр между вторым усилителем и смесителем с резонансом в рабочей полосе и добротностью, обеспечивающей подавление зеркального канала не менее 40 дБ.
- **Проверка:** `sim/scripts/antenna_fdtd.py`, ngspice `.ac` на `sim/netlists/sdr_skidl_ngspice.cir`.

### Сквозной расчёт физики

Последовательный LC-резонанс `L_BS1` (100 мкГн) и `C_BS2` (10 пФ):

f₀ = 1 / (2π·√(L·C)) = 1 / (2π·√(100·10⁻⁶ · 10·10⁻¹²)) = **5.03 МГц**

Добротность с учётом `R_BS` = 1 кОм: Q = (1/R)·√(L/C) = 10⁻³·√(10⁻⁵/10⁻¹¹)
= 10⁻³·1000 = **1.0** — полоса пропускания шире рабочей, фильтр работает
как элемент согласования и разделения постоянной составляющей перед
дифференциальным входом смесителя.

`C_MIX1`/`C_MIX2` (100 пФ) вместе с выходным импедансом LT5560 образуют
дифференциальную согласующую цепь, обеспечивающую баланс 180° по I и Q.

Зеркальный канал при прямом преобразовании отсутствует по построению:
сигнал с частотой гетеродина попадает в DC, а не в зеркало.
