maximmalin/simul/requirements/rf/REQ-RF-04_mixer.md

# REQ-RF-04 — Смеситель нулевого промежуточного сигнала

**Подсистема:** ВЧ (радиочастотная часть)
**Аппаратная реализация:** `U_MIX1` (LT5560), `L_MIX` (FB 600 Ом @100 МГц), `C_MIX3` 100 нФ, `R_LO` 50 Ом, `C_LO` 100 пФ

- **Требование:** Смеситель с гетеродином на частоте сигнала (zero-IF) с выходом непосредственно в полосу основной частоты, усилением ≥ +3 дБ и коэффициентом шума ≤ 8 дБ.
- **Проверка:** `tests/requirements/rf/test_rf.py`, ngspice-анализ смесителя; `sim/outputs/ngspice/structural_chA.net`.

### Сквозной расчёт физики

LT5560 — смеситель с нулевой ПЧ: при подаче гетеродина f_LO = f_signal
на выходе получается сигнал постоянной частоты (DC), а не составляющая
2·f. Это принципиально отличает конструкцию от супергетеродина:

| тип смесителя | что попадает на выход | зеркальный канал |
|---|---|---|
| супергетеродин (ПЧ 38 МГц) | f_sig − f_LO = 38 МГц | есть, требует фильтр |
| **zero-IF (эта плата)** | f_sig − f_LO = 0 Гц | **отсутствует** |

Отсутствие зеркала снимает необходимость в фильтре-преселекторе перед
смесителем и упрощает тракт до одного LC-элемента `REQ-RF-03`.

Питание смесителя изолировано от цифровой шины ферритом `L_MIX`
(600 Ом @ 100 МГц) и развязано `C_MIX3` 100 нФ — это предотвращает
проникновение тактовых гармоник STM32 на вход усиления.
Гетеродин подаётся от `R_LO` = 50 Ом с развязкой `C_LO` 100 пФ.
