maximmalin/simul/requirements/safety/REQ-SAFE-01_electrical.md

# REQ-SAFE-01 — Электробезопасность

**Подсистема:** Безопасность · **Связано с:** REQ-PWR-01, REQ-MECH-01

- **Требование:** Изделие должно соответствовать требованиям электробезопасности по ГОСТ IEC 60950-1-2014 (класс II).
- **Стандарт:** IEC 60950-1 / IEC 62368-1.
- **Проверка:** `tests/requirements/emc/test_emc.py`, `tests/requirements/reliability/`.

### Класс защиты

Плата питается от USB-порта (5 В, `J_PWR`). Преобразования 230 В → постоянный
ток на плате **нет**, поэтому класс защиты — **II** (двойная изоляция),
а не I.

| узел | напряжение | примечание |
|---|---|---|
| `J_PWR` VBUS | 5 В | вход питания |
| `U_LDO` AMS1117-3.3 | 3.3 В | линейный стабилизатор |
| ВЧ-тракт | 3.3 В (`+3V3_ANA`) | через феррит `FB1` |
| `U1` STM32F103C8T6 | 3.3 В | цифровая зона |

### Требования

- **Предел тока** — ограничивается в БП и USB-портом: 500 мА (USB 2.0) /
  900 мА (USB 3.0). Потребление платы ≈ 70 мА.
- **Ток утечки на корпус** ≤ 0.5 мА (IEC 60950-1). При напряжении
  изоляции ≈ 250 В (USB) и сопротивлении изоляции ≥ 100 МОм:
  I_ут = 250/100·10⁶ = **2.5 мкА** — на два порядка ниже нормы.
- **Заземление корпуса** — винт М3, ГОСТ 14192-96, знак «Заземление».
- **Выделение тепла** от тока утечки пренебрежимо:
  Q = I²·R·t = (2.5·10⁻⁶)²·0.1·3600 ≈ 2·10⁻⁹ Дж.

> **Изменения относительно исходной редакции.** Указывались стабилизаторы
> LM7812/LM7805, питание «от батарейного питания» и автоматический
> выключатель на 2 А, а также требование изоляции 3000 В между сетью
> 230 В и низковольтными секциями. В Krystal Radio фактически применяется
> AMS1117-3.3 с питанием от USB; сетевого напряжения на плате нет,
> поэтому требование 3000 В **не применимо**.
