maximmalin/simul/requirements/blocks/req_21.md

# Блок требования REQ-21

## Экранирование корпуса (Case Shielding)

- **Требование:** Корпус приёмника должен быть выполнен из фрезерованного алюминия и разделён на три изолированные секции (ВЧ-аналоговая, цифровая, питание) с использованием радиочастотных электропроводящих прокладок (MIL-DTL-83528).
- **Структурный блок:** Блок 5 «ЭМС — конструктивное экранирование»
- **Скрещивание с общими техническими требованиями:**
  - ГОСТ CISPR 22-2012 (Класс Б — для жилых и промышленных зон)
  - ГОСТ 30804.4.3-2013 (иммунитет к внешним полям 2–3 В/м)
  - MIL-DTL-83528 (электропроводящие прокладки)
  - IPC-2221 Class 2 / ГОСТ Р 51418-620.1 (минимальные зазоры и ширина токопроводящих дорожек)

### Соответствие фактической конструкции

Требование относится к плате **Krystal Radio (zero-IF, прямое преобразование)**,
а не к устаревшей акустооптической схеме. Фактические блоки, которые корпус
разделяет:

| Секция | Содержимое платы |
|---|---|
| ВЧ-аналоговая | `J_ANT` (SMA), `Q_LNA1`/`Q_LNA2` (2N7002), `X_QWC1` (LPJ-1), `U_MIX1` (LT5560), `U_OP1` (OPA2134) |
| Цифровая | `U1` (STM32F103C8T6, 72 МГц), `Y1` (XTAL 8 МГц), `J_USB` (USB CDC), `J_PWR` (USB-B питание) |
| Питание | `U_LDO` (AMS1117-3.3), `C_LDO1` 100 мкФ, `C_LDO2` 100 нФ, `FB1` 600 Ом@100 МГц |

В конструкции **нет** оптического блока, лазера, ножа Фуко, фотодиодов и
FPGA — эти элементы относятся к отменённой акустооптической схеме и в
изделии не применяются.

- **Сквозной расчет физики:** Глубина скин-слоя алюминия

  δ = √(2ρ / (ω·μ₀·μᵣ)), ρ_al = 2.65·10⁻⁸ Ом·м, μᵣ = 1

  При f = 1 ГГц: ω = 2π·10⁹, ω·μ₀ = 7895.6, δ = √(5.3·10⁻⁸ / 7895.6) ≈ **2.59 мкм**.
  При f = 7 ГГц: δ ≈ 2.59 / √7 ≈ **0.98 мкм**.

  > **Замечание к исходной редакции.** В предыдущей версии требования было
  > указано δ ≈ 0.025 мм при 1 ГГц. Это значение завышено примерно в 10 раз;
  > корректная глубина скин-слоя для алюминия на 1 ГГц — ≈ 2.6 мкм.
  > Исправленное значение используется в `tests/requirements/emc/test_emc.py`.

  Эффективность экранирования при толщине стенки t ≫ δ складывается из
  отражения, поглощения и переизлучения:

  SE ≈ 168 − 20·log₁₀(f·r) + 20·log₁₀(√(σ_Cu/σ_Al)) + 8.686·t/δ

  При t = 0.5 мм, f = 1 ГГц, r = 0.1 м: R ≈ 10 дБ, A ≈ 1677 дБ.
  То есть **сам материал стенки даёт практически неограниченное экранирование**;
  реальный предел задают не металл, а стыки, щели, окна и разъёмы. Именно
  поэтому нормой является не «толщина», а контактное сопротивление по
  прокладкам ≤ 10 мОм и разделение на три секции.

  Без экранирования мощность наведённых помех (REQ-22) может превысить
  полезный сигнал приёмника и привести к насыщению АЦП STM32 и потере
  динамического диапазона.
