maximmalin/simul/requirements/blocks/req_22.md

# Блок требования REQ-22

## Иммунитет к внешним электромагнитным полям (Immunity to External EM Fields)

- **Требование:** Приёмник должен сохранять работоспособность и заложенный динамический диапазон при воздействии внешних электромагнитных полей в соответствии с ГОСТ 30804.4.3-2013 (уровень жёсткости 2 — 3 В/м) в диапазоне 80–2700 МГц.
- **Структурный блок:** Блок 5.2 «Иммунитет к помехам»
- **Скрещивание с общими техническими требованиями:**
  - ГОСТ CISPR 22-2012 (Класс Б)
  - IEC 61000-4-3 (уровень 2 — 3 В/м), эквивалент ГОСТ 30804.4.3-2013
  - REQ-21 (экранирование), REQ-24 (фильтры питания)

### Соответствие фактической конструкции

Проверяется устойчивость ВЧ-тракта платы Krystal Radio:
`J_ANT` → `Q_LNA1`/`Q_LNA2` → `X_QWC1` → `U_MIX1` (LT5560) → `U_OP1` (OPA2134) → АЦП `U1`.

Помеха попадает в тракт только через вход SMA и через цепи питания
(`FB1`, аналоговая шина `+3V3_ANA`). Цифровой тракт (`U1`, USB CDC) и
стабилизатор `U_LDO` защищены разделением на секции (REQ-25).

- **Сквозной расчет физики:** Напряжение, наведённое внешним полем на
  эффективную длину антенны h, и соответствующая мощность в 50-омном входе:

  U_ind = E · h, P_ind = U_ind² / (4 · R_вх)

  При E = 3 В/м и h = 0.1 м: U_ind = 0.3 В, P_ind = 0.09 / 200 = **4.5·10⁻⁴ Вт**.

  > **Замечание к исходной редакции.** В предыдущей версии требования было
  > указано P_ind = (E·h)²/50 ≈ 1.8·10⁻⁵ Вт. Величина занижена примерно в 25 раз:
  > при 50-омном согласованном входе мощность нормируется как U²/(4·R), что даёт
  > 4.5·10⁻⁴ Вт. Даже с этой поправкой помеха превышает целевой сигнал
  > (MDS ≈ −126 дБм ≈ 2.4·10⁻¹⁶ Вт) на 9 порядков, поэтому экранирование
  > и фильтрация обязательны.

  Требуемое ослабление — не менее 40–60 дБ — обеспечивается совместно
  REQ-21 (алюминиевый корпус + прокладки ≤10 мОм) и REQ-24 (феррит
  `FB1` 600 Ом@100 МГц и развязка 10 мкФ/100 нФ на аналоговой шине).

  > **Замечание о критерии.** Иммунитет по ГОСТ 30804.4.3-2013 / IEC 61000-4-3 — это
  > критерий **функционирования**: прибор не должен насыщаться и терять функции,
  > а отношение сигнал/помеха при этом ухудшается. Требовать сохранения MDS
  > в поле 3 В/м физически невозможно.

  Действительно, доступная мощность поля на согласованной антенне 1 ГГц
  (диполь, 1.5 дБи) по формуле P = E²·G·λ²/(32π²) составляет ≈ 3.6 мВт (+5.6 дБм) —
  это на 130 дБ выше MDS. Помеха гасится двумя независимыми механизмами:

  1. **Экранирование** 40–60 дБ (REQ-21);
  2. **Избирательность тракта**: при качании поля 80–2700 МГц и полосе ПЧ 2.7 кГц
     ослабление составляет 10·log₁₀(1000·10⁶ / 2700) ≈ 55.7 дБ.

  В сумме это более 90 дБ — достаточно, чтобы помеха не достигла точки
  компрессии ВЧ-тракта. На входе смесителя (после 40 дБ экрана и 20 дБ
  усиления LNA) помеха составляет −14…−34 дБм, то есть с запасом >20 дБ
  до точки компрессии 1 дБ (+10 дБм). Потеря чувствительности при этом
  ожидаема и не является нарушением критерия иммунитета.
