maximmalin/simul/requirements/blocks/req_23.md

# Блок требования REQ-23

## Уровень радиопомех (Emission Level)

- **Требование:** Уровень индустриальных радиопомех, создаваемых приёмником, не должен превышать норм ГОСТ CISPR 22-2012 (Класс Б), эквивалент EN 55022.
- **Структурный блок:** Блок 5.3 «Эмиссия: излучаемая и проводимая»
- **Скрещивание с общими техническими требованиями:**
  - ГОСТ CISPR 22-2012 (Класс Б — для жилых и промышленных зон)
  - REQ-21 (экранирование корпуса), REQ-24 (фильтры питания), REQ-25 (зонирование)
  - IEC 55022 Class B, CISPR 32

### Соответствие фактической конструкции

Источники помех приёмника Krystal Radio (без устаревшего Wi-Fi модуля):

| Источник | Механизм излучения | Мера |
|---|---|---|
| `U1` STM32F103C8T6, такт 72 МГц | переключение ядра и периферии, гармоники 72·n МГц | экран цифровой секции |
| `Y1` XTAL 8 МГц + тактовые гармоники | экранирование, разнесение с ВЧ-трактом | разделение секций (REQ-25) |
| USB CDC (`J_USB`) | синхронизирующие переходы, кабель как антенна | фильтр на входе питания |
| `U_LDO` AMS1117-3.3 | пульсации напряжения нагрузки (линейный, не импульсный) | `C_LDO1` 100 мкФ, `C_LDO2` 100 нФ |
| `U_MIX1` LT5560, гетеродин LO | ВЧ-излучение смесителя | ВЧ-секция под экраном |

> **Замечание к исходной редакции.** Ранее источником помех указывался
> Wi-Fi модуль ESP32 на частотах 2.4 и 5 ГГц. В конструкции Krystal Radio
> беспроводной связи нет: данные выводятся по USB CDC (`J_USB`), а
> микроконтроллер — STM32F103C8T6. Требование по норме эмиссии (Класс Б)
> остаётся в силе, но обоснование переписано под фактические источники.

- **Сквозной расчет физики:** Норма CISPR 22 Класс Б (квазипиковый детектор,
  дистанция 3 м) — 30–1000 МГц: **40 дБмкВ/м**; 0.5–5 ГГц: **47 дБмкВ/м**.

  Импульсный преобразователь в схеме отсутствует, поэтому спектральная
  плотность помех от питания определяется пульсациями AMS1117 и разбросом
  нагрузки; линейный стабилизатор на порядок тише ШИМ-источника того же
  класса. Обязательны керамические конденсаторы 0.1 мкФ на выводах
  стабилизатора и феррит `FB1` перед аналоговой шиной.

  Без этих мер проводимые помехи по цепи питания могут превысить норму
  Класс Б на 10–20 дБ, что делает приёмник непригодным для жилых зон.
