maximmalin/simul/requirements/blocks/req_24.md

# Блок требования REQ-24

## Фильтры питания (Power Supply Filters)

- **Требование:** Линии питания приёмника (+5V вход, +3V3 цифровая, +3V3_ANA аналоговая, GND) должны быть снабжены развязывающими конденсаторами и обводчиками (ферритами) для подавления ВЧ-шума.
- **Структурный блок:** Блок 5.4 «Фильтры питания»
- **Скрещивание с общими техническими требованиями:**
  - REQ-04 (NF ≤ 3.5 дБ — приёмный тракт)
  - REQ-21 (экранирование), REQ-23 (эмиссия)
  - IPC-2221 / ГОСТ Р 51418-620.1 (развязка питания)

### Соответствие фактической конструкции

Фактическая цепь питания платы Krystal Radio:

```
J_PWR (USB-B, 5V_IN)
   └── U_LDO  AMS1117-3.3 ── +3V3
         ├── C_LDO1  100 мкФ   (накопление)
         ├── C_LDO2  100 нФ    (ВЧ-шунт)
         └── FB1  600 Ом @ 100 МГц ── +3V3_ANA
               ├── C_ANA1  10 мкФ
               └── C_ANA2  100 нФ
```

Импульсных преобразователей в схеме нет — питание линейное (AMS1117-3.3),
поэтому спектральный состав помех определяется пульсациями нагрузки, а не
частотой переключения.

- **Сквозной расчет физики:** Частота среза фильтра «дроссель + конденсатор»

  f_c = 1 / (2π·√(L·C))

  | Фильтр | L | C | f_c |
  |---|---|---|---|
  | LC-фильтр (справочный, из исходной редакции) | 10 мкГн | 100 нФ | **159 кГц** |
  | Выходная развязка AMS1117 | — | 100 мкФ | 1.6 кГц (ESR-коррекция) |
  | ВЧ-шунт | — | 100 нФ | > 1 МГц (шунтирование до 1 ГГц) |

  > **Замечание к исходной редакции.** Указано f_c ≈ 16 кГц при L = 10 мкГн и
  > C = 100 нФ. Расчёт даёт 1/(2π·√(10⁻⁵·10⁻⁷)) = 1/(2π·10⁻⁶) ≈ **159 кГц** —
  > значение занижено на порядок.

  Феррит `FB1` (600 Ом @ 100 МГц) даёт падение уровня на аналоговой шине
  в полосе 100 МГц и выше. Без развязки ВЧ-шум от нагрузки проникал бы
  в приёмный тракт и ухудшал коэффициент шума с нормы 3.5 дБ (REQ-04),
  что ведёт к потере чувствительности и динамического диапазона.
