maximmalin/simul/requirements/blocks/req_25.md

# Блок требования REQ-25

## Зонирование экранирования (Shielding Zoning)

- **Требование:** Корпус приёмника должен быть разделён на три изолированные секции — ВЧ-аналоговую, цифровую и питания — с алюминиевыми перегородками и радиочастотными электропроводящими прокладками.
- **Структурный блок:** Блок 5.5 «Зонирование»
- **Скрещивание с общими техническими требованиями:**
  - REQ-21 (экранирование корпуса)
  - REQ-04 (NF ≤ 3.5 дБ)
  - REQ-23 (уровень радиопомех)
  - REQ-24 (фильтры питания)

### Соответствие фактической конструкции

Секции корпуса для платы Krystal Radio:

| Секция | Элементы платы | Требование к разделению |
|---|---|---|
| **ВЧ-аналоговая** | `J_ANT`, `Q_LNA1`, `Q_LNA2`, `X_QWC1`, `U_MIX1`, `U_OP1`, `FB1`, `C_ANA1/2` | заземление — аналоговая «земля» звездой; тактовые линии STM32 не входят |
| **Цифровая** | `U1` STM32F103C8T6, `Y1`, `J_USB`, `C_LDO1/2` | own-плоскость GND, экран от ВЧ-секции |
| **Питание** | `J_PWR`, `U_LDO` AMS1117-3.3 | сквозной фильтр/феррит на входе аналоговой секции |

> **Замечание к исходной редакции.** Ранее третья секция описывалась как
> «цифровой блок (ESP32, ПЛИС)», а изоляция обеспечивалась связью с ПК
> **только по Wi-Fi**. В Krystal Radio беспроводной связи нет: вывод данных
> выполняется по **USB CDC** (`J_USB`), микроконтроллер — STM32F103C8T6,
> ПЛИС не применяется. Оптический блок (лазер 650 нм, PMMA, нож Фуко,
> фотодиоды BPW34) в изделии также отсутствует.
>
> Гальваническая изоляция ВЧ-тракта обеспечивается **разделением на секции и
> экранированием**, а не отсутствием проводной связи: сигнал I/Q приходит
> на АЦП по дифференциальным аналоговым входам `PA0/PA1` через развязанную
> операционную ступень.

- **Сквозной расчет физики:** Зонирование предотвращает перекрёстную связь
  между ВЧ- и цифровой секциями. Токи переключения `U1` (72 МГц и гармоники)
  текут по цифровой «земле»; при отсутствии разделения их общий ток создаёт
  падение напряжения на сопротивлении общей «земли», которое проявляется как
  напряжение ошибки на входе АЦП и неотличимо от полезного сигнала.

  Требуемое ослабление — 40–60 дБ (REQ-21/REQ-22), контактное сопротивление
  прокладок ≤ 10 мОм. Разделение секций обеспечивает сохранение динамического
  диапазона 85–100 дБ.
