maximmalin/simul/requirements/blocks/req_37.md

# Блок требования REQ-37

## Уровень собственного шума и порог обнаружимости (Noise Floor / MDS)
- **Требование:** Уровень собственного шума приёмника (приведённый ко входу) — не более −120 дБм в полосе 2.7 кГц; минимальный различимый сигнал (MDS) — не менее −110 дБм при S+N/N = 10 дБ.
- **Стандарт:** ITU-R SM.326 / Эквивалент: IEEE Std 145
- **Структурный блок:** Блок 2 «RF Frontend — шумовая дорожка и чувствительность»
- **Скрещивание с общими техническими требованиями:**
  - REQ-04 (коэффициент шума NF ≤ 3.5 дБ) — определяет наклон шумовой дорожки
  - REQ-36 (SNR ≥ 60 дБ) — числитель отношения сигнал/шум
  - REQ-03 (50 Ом, SMA) — источник согласованной шумовой нагрузки
- **Сквозной расчёт физики:** Шум согласованной нагрузки при T = 290 K в полосе B = 2700 Гц: N₀ = kTB = −174 дБм/Гц + 10·log₁₀(2700) = −174 + 34.3 = −139.7 дБм. С учётом коэффициента шума приёмника NF ≤ 3.5 дБ (REQ-04) приведённый ко входу шум не превышает N = −139.7 + 3.5 ≈ −136 дБм, что даёт ≥ 16 дB запаса относительно нормы −120 дБм (учитывая сетевые и индустриальные помехи KB-диапазона). Порог обнаружимости MDS = N + 10 дБ = −120 + 10 = −110 дБм, что обеспечивает сигнал S+N/N = 10 дБ. Значение MDS согласовано с чувствительностью −110 дБм из REQ-04.
