maximmalin/simul/requirements/blocks/req_01.md

# Блок требования REQ-01

## Мгновенная полоса частот (Instantaneous Bandwidth)
- **Требование:** Прибор должен обеспечивать мгновенную полосу частот не менее 500 МГц (целевой показатель: 1000 МГц)
- **Сравнение с HackRF One:** Не менее чем в 25 раз шире (HackRF: 20 МГц)
- **Структурный блок:** Блок 1 «Общие параметры системы»
- **Скрещивание с общими техническими требованиями:**
  - Требование ГОСТ Р 52016-2003 / ITU-R SM.328 (диапазон 10 МГц–6 ГГц)
  - Требование ГОСТ 24375-80 / IEEE Std 211 (мгновенная БПЧ)
- **Сквозной расчет физики:** Расчет Friis Transmission Equation определяет минимальную мощность сигнала на входе антенны (Cantenna) в диапазоне 0–7 ГГц, что задает нижний порог чувствительности, который последующие блоки должны преодолеть. Целевая БПЧ 500 МГц обеспечивает в 25 раз больше информации за одно сканирование по сравнению с HackRF One (20 МГц), что критично для автоматического мониторинга среды без поиска частоты.
