maximmalin/simul/requirements/blocks/req_02.md

# # Блок требования REQ-02

## Динамический диапазон блокировки (Dynamic Range of Blocking)
- **Требование:** Коэффициент динамического диапазона по блокированию (SFDR) не менее 75–80 дБ
- **Сравнение с HackRF One:** Мин. на 30 дБ лучше (HackRF: 45–50 дБ)
- **Структурный блок:** Блок 2 «RF Frontend — Входной тракт»
- **Скрещивание с общими техническими требованиями:**
  - Требование NF ≤ 3.5 дБ (IEEE Std 145)
  - Требование входного опора 50 Ом (GOST 20275-91)
- **Сквозной расчет физики:** Каскад усиления ТВ-селектора + УПЧ КТ368А обеспечивает суmulтивное уси amplification 316×63 = 19 908, что преображает входной сигнал −38 дБм в выходную мощность 3.1 мВт, укладываясь в предел безопасности ≤10 мВт для исключения насыщения лазерного луча. SFDR ≥75–80 дБ гарантирует, что сильные помехи (например, сигнал дрона на 1 Вт = +30 дБм) не насытят АЦП, а слабый сигнал (входной уровень −110 дБм) останется distinguishable. Динамический диапазон 85–100 дБ достигается за счет оптического разделения мощностей и пассивной фильтрации ножом Фуко: избыточная энергия помехи превращается в свет и геометрически сбрасывается, не перегружая электронную цепь.
