maximmalin/simul/requirements/blocks/req_03.md

# # Блок требования REQ-03

## Входное опора и разъем (Input Impedance)
- **Требование:** Входное опора ВЧ-порта: 50 Ом, разъем типа SMA
- **Стандарт:** GOST 20275-91 / Эквивалент: IEC 60169-15
- **Структурный блок:** Блок 2 «RF Frontend — Соединение с антенной»
- **Скрещивание с общими техническими требованиями:**
  - Совместимость с антенной Cantenna (диаметр 90 мм, частота 2.4 ГГц)
  - Интеграция с системой RF-фронтэнда
- **Сквозной расчет физики:** Расчет коэффициента усиления антенны Grec ≈ 10 дБи = 1 для диаметра 90 мм на частоте 2.4 ГГц λ_rf = 0.125 м определяет захваченную мощность сигнала P_rec = P_tx · G_tx · G_rec · (λ_rf / 4πR)² = 1 Вт · 1.58 · 10 · (0.125 / (4π·100))² ≈ 1.56×10⁻⁷ Вт (−38 дБм). Это минимальный сигнал, который последующие каскады усиления должны обрабатывать без насыщения. Совместимость разъема SMA гарантирует минимизацию потерь на контактах (VSWR < 1.5) в диапазоне 0–7 ГГц.
