maximmalin/simul/requirements/blocks/req_04.md

# # Блок требования REQ-04

## Коэффициент шума входного тракта (Noise Figure)
- **Требование:** Коэффициент шума (Noise Figure, NF) входного тракта: не более 3.5 дБ
- **Стандарт:** Эквивалент: IEEE Std 145
- **Структурный блок:** Блок 3 «RF Frontend — Минимальный шум»
- **Скрещивание с общими техническими требованиями:**
  - Критически важно для достижения чувствительности −110 дБм
  - Взаимодействие с ластовыми усилителями КТ368А
- **Сквозной расчет физики:** Каскадное усиление G_tuner ≈ 25 дБ = 316 и G_KT368 ≈ 18 дБ = 63 приводит к полной мощности на выходе P_rf_out = P_rec · G_tuner · G_KT368 = (1.56×10⁻⁷ Вт) × 316 × 63 = 0.0031 Вт = 3.1 мВт (+4.9 дБм). Уровень шума на выходе определяется формулой NF_total = NF_1 + (NF_2 − 1)/G_1, где NF_1 = 3.5 дБ (входной усилитель), G_1 = 316 (усилитель селектора). Итоговый NF системы ≈ 3.5 + (NF_KT368 − 1)/316. Даже при NF_KT368 = 10 дБ, итоговый NF ≈ 3.53 дБ, что соответствует требованию. Без хорошего входного усилителя с NF ≤ 3.5 дБ общий NF системы вырастал бы до 5–6 дБ, что снизил бы чувствительность до −100 дБм вместо целевых −110 дБм, а динамический диапазон — до 70–80 дБ вместо 85–100 дБ.
