maximmalin/simul/requirements/blocks/req_05.md

# # Блок требования REQ-05

## Защита от перегрузки (Overload Protection)
- **Требование:** ВЧ-тракт должен содержать коммутируемый блок преселекторов, малошумящий усилитель с защитой от перегрузки (до +20 дБм)
- **Структурный блок:** Блок 4 «RF Frontend — Защита от перегрузок»
- **Скрещивание с общими техническими требованиями:**
  - Требление GOST IEC 60825-1 Class 3B (безопасность лазера)
  - Соответствие ГОСТ 30804.4.3-2013 (иммунность к внешним полям)
- **Сквозной расчет физики:** Выходной ВЧ-драйвер: Линейный усилитель мощности сигнала до 1.5 Вт для обеспечения максимальной дифракционной эффективности пьезоэлектрического преобразователя ячейки Брэгга. Мощность 1.5 Вт — это расчетный предел, выше которогоPossible laser channel saturation. При входном сигнале 3.1 мВт (после каскада усиления) и потенциальной помехе 1 Вт (+30 дБм) коэффициент перегрузки +20 дБм гарантирует, что мощность 1.3 Вт не вызовет насыщения лазерного луча, а защитный блок преселекторов отсечет переженные гармоники перед входом в УПЧ КТ368А. Нож Фуко additionally снижает фазовый шум от оставшихся помех до < -110 дБс/Гц.
