maximmalin/simul/requirements/blocks/req_08.md

# # Блок требования REQ-08

## Стабильность оптической мощности (Optical Power Stability)
- **Требование:** Стабильность оптической мощности: не хуже 0.5%
- **Структурный блок:** Блок 3.3 «Стабилизация лазера»
- **Скрещивание с общими техническими требованиями:**
  - Требование ГОСТ IEC 60825-1-2013 (Класс безопасности лазера 3B)
  - Аппаратная цепи автоматического регулирования мощности (АРМ)
- **Сквозной расчет физики:** Стабильность 0.5% необходима для поддержания постоянного значения Δn ≈ 1.51×10⁻⁵. Временные колебания мощности лазера ΔP/P > 0.5% приводят к температурным и индексным изменениям кристалла TeO₂ (dn/dTeO₂ ≈ 1.5×10⁻⁵ /°C), что вызывает дрейф Δn и сдвиг дифракционного пика. Система автоматического регулирования мощности (АРМ) с элементами Пельтье обеспечивает температурную стабильность ±0.1° C, что соответствует требованию раздела 4.1 (климатические условия) и удерживает частотную шкалу в пределах ±250 кГц. Расчет погрешности без АРМ: Δn/n ≈ (dn/dT) · ΔT ≈ 1.5×10⁻⁵ · 1° C = 1.5×10⁻⁵, что при диапазоне π·Δn·L/λ ≈ 0.72 радиан дает сдвиг пика Δφ ≈ 0.72 · 1.5×10⁻⁵ / 1.5×10⁻⁵ ≈ 0.72 рад ≈ 41°, что значительно деградирует сигнал.
