maximmalin/simul/requirements/blocks/req_09.md

# # Блок требования REQ-09

## Автоматическое регулирование мощности (Automatic Power Regulation)
- **Требование:** Наличие цепи автоматического регулирования мощности (АРМ) (ГОСТ IEC 60825-1-2013 / Эквивалент: IEC 60825-1 — Класс безопасности лазера 3B)
- **Структурный блок:** Блок 3.2 «Оптико-механический узел — ЦОС»
- **Скрещивание с общими техническими требованиями:**
  - Требование класса безопасности лазера 3B
  - Взаимодействие с ГОСТ 30804.4.3-2013 (иммунность к внешним полям)
- **Сквозной расчет физики:** Цепи АРМ с элементами Пельтье обеспечивают удержание температуры ±0.1° C, что критически важно для стабильности Δn ≈ 1.51×10⁻⁵. Без АРМ дрейф температуры на 1° C приведет к изменению Δn на ~15% (dn/dTeO₂ ≈ 1.5×10⁻⁵ /°C), что сведет динамический диапазон с 85–100 дБ до 70–80 дБ. АРМ измеряет выходную мощность лазера пирогой пирометром или диодным 감지телем и корректирует ток драйвера лазера в реальном времени. ПИД-регулятор с коэффициентами Kp=0.5, Ki=0.1, Kd=0.01 обеспечивает перерегулирование без осцилляций при шаге регулирования 0.1% мощности.
