maximmalin/simul/requirements/blocks/req_12.md

# # Блок требования REQ-12

## Покрытие торцов кристалла (Crystal End Face Coating)
- **Требование:** Торцы кристалла должны иметь диэлектрическое просветляющее покрытие с коэффициентом отражения R < 0.2%
- **Структурный блок:** Блок 3.1 «Оптическая предварительная подготовка»
- **Скрещивание с общими техническими требованиями:**
  - Требование ГОСТ ISO 9211-1-2016
  - Соответствие SFDR ≥75–80 дБ
- **Сквозной расчет физики:** Коэффициент отражения R < 0.2% минимизирует потери мощности лазера на поверхности кристалла. При R = 0.2% потеря мощности на одной поверхности: ΔP/P = R = 0.002 = 0.2%. При двух концах (вход и выход) общие потери: 1 − (1 − R)² ≈ 2R = 0.4%. При R > 0.2% потеря мощности сократит интенсивность ультразвука I_ac, что приведет к уменьшению Δn по формуле Δn = √(½M₂ρv³I_ac). При I_ac уменьшении на 0.4% Δn уменьшится на ~0.2%, а η_opt = sin²(π·Δn·L/λ) уменьшится примерно на 0.44% (по правилу цепочки производных). Хотя это кажется небольшим, накопление эффектов приведет к динамическому диапазону ниже целевых 85–100 дБ. При R = 1% потери составят ~2% на каждой поверхности, итого ~4%, что приведет к снижению η_opt с 44.4% до примерно 42.5% и динамическому диапазону до ~96 дБ (все еще в пределах целевого диапазона, но с меньшим запасом).
