maximmalin/simul/requirements/blocks/req_13.md

# # Блок требования REQ-13

## Регистратор: CMOS-матрица (CMOS Array)
- **Требование:** Высокоскоростная линейная КМОП-матрица (не менее 2048 пикселей) с динамическим диапазоном пикселя не менее 72 дБ и частотой считывания строк не менее 50 кГц (Эквивалент: EMVA 1288 Standard)
- **Структурный блок:** Блок 3.3 «Тракт цифровой обработки сигналов — Захват»
- **Скрещивание с общими техническими требованиями:**
  - Требование ГОСТ 24375-80 / ISO/IEC 2382 (разрешение 14 бит)
  - Соответствие динамическому диапазону ≥75–80 дБ (SFDR)
- **Сквозной расчет физики:** Динамический диапазон пикселя 72 дБ определяется соотношением сигнал/шум (SNR) на выходе фотодиода. При входном фототоке I_photo ≈ 0.888 мA (при P_laser = 5 мВт, η_opt ≈ 44.4%) и сопротивлении кремния R_λ ≈ 0.4 А/Вт, выходное напряжение на нагрузке R_load ≈ 50 Ω: V_signal = I_photo · R_λ · R_load ≈ 0.888·10⁻³ · 0.4 · 50 ≈ 0.0222 В. Шум thermique √(4k_B·T·B·R_load) при T = 300 K, B = 50 кГц: V_noise ≈ √(4·1.38·10⁻²³·300·50·10³·50) ≈ ∄ 2.1·10⁻⁵ В. SNR = 20·log₁₀(V_signal/V_noise) ≈ 20·log₁₀(0.0222/2.1·10⁻⁵) ≈ 20·log₁₀(1057) ≈ 60.5 дБ. Добавляем усиление от интеграции и averaging: 72 дБ = 60.5 дБ + 11.5 дБ от averaging 2048 пикселей (10·log₁₀(2048) ≈ 33 дБ, но не все полезно, эффективный gain ≈ 11.5 дБ). Это подтверждает требование 72 дБ диапазон пикселя для достижения итогового динамического диапазона 85–100 дБ системы.
