maximmalin/simul/requirements/blocks/req_14.md

# # Блок требования REQ-14

## Динамический диапазон пикселя (Pixel Dynamic Range)
- **Требование:** Динамический диапазон пикселя: не менее 72 дБ
- **Структурный блок:** Блок 3.3 «Тракт ЦОС — Характеристика пикселя»
- **Скрещивание с общими техническими требованиями:**
  - Требование EMVA 1288 Standard
  - Взаимосвязь с ГОСТ Р 52016-2003 / ISO/IEC 2382 (14 бит эквивалент)
- **Сквозной расчет физики:** Динамический диапазон пикселя 72 дБ определяется как отношение пиковой сигнальной мощности к шуму пола (noise floor). Пиковая сигнальная мощность соответствует насыщению фотодиода при I_photo_max ≈ 10 мА (предел по току ESP32 АЦП). Шум пола определяетсяthermal noise и readout noise CMOS-матрицы. При B = 50 кГц полосы и R_load = 50 Ω: V_noise_thermal ≈ 21 μV (как рассчитано ранее). Пиковое напряжение V_sat ≈ I_sat · R_λ · R_load, где I_sat ≈ 10 мА → V_sat ≈ 10·10⁻³ · 0.4 · 50 ≈ 0.2 В. SNR = 20·log₁₀(0.2/0.000021) ≈ 20·log₁₀(9523) ≈ 79.6 дБ. При accounting реального readout noise CMOS (около 10–20 электронов ≈ 0.5–1 μV) итоговый SNR ≈ 72–75 дБ. Таким образом, требование 72 дБ гарантирует, что пиксель сможет регистрировать сигналы от очень слабых (вблизи шумового пола) до насыщения, обеспечивая полный динамический диапазон системы.
