maximmalin/simul/requirements/blocks/req_18.md

# # Блок требования REQ-18

## Относительная влажность (Relative Humidity)
- **Требование:** не более 80% при температуре +25° C (без конденсации влаги)
- **Структурный блок:** Блок 4.2 «Климатические условия — Влажность»
- **Скрещивание с общими техническими требованиями:**
  - Требование ГОСТ 15150-69
  - Эквивалент: ISO 554-1976 (влажность)
- **Сквозной расчет физики:** При относительной влажности >80% при +25° C возможно образование конденсата на поверхности кристалла TeO₂ и фотодиодов.Конденсат изменяет показатель преломления на поверхности кристалла, что приводит к неконтролируемому изменению Δn и искажению дифракционного пика. Внутри корпуса должен быть заложен расчетное количество активированного силикагеля (по ГОСТ 3956-76) для поглощения излишков влаги. Расчетный вес силикагеля: m_silica ≈ 5–10 г для объема корпуса ~500 см³, срок службы до полной насыщенности (3 года без переконсервации per ГОСТ 9.014-78). При насыщении силикагеля (вес увеличивается на 25–30% от поглощенной влаги) требуется переконсервация или сушка при 80° C в течение 2 часов. Итоговый эффект: без силикагеля при влажности 80%+ конденсат на кристалле TeO₂ может привести к изменению Δn на 5–10%, что сведет динамический диапазон с 85–100 дБ до 75–85 дБ.
