maximmalin/simul/requirements/blocks/req_20.md

# # Блок требование REQ-20

## Устойчивость к вибрации (Vibration Resistance)
- **Требование:** Конструкция должна уwithstand вибрационным нагрузкам в диапазоне частот 10–55 Гц с амплитудой смещения до 0.15 мм
- **Структурный блок:** Блок 4.4 «Механическая прочность — Вибрация»
- **Скрещивание с общими техническими требованиями:**
  - Требование ГОСТ 30631-99 (ИКЦ 60068-2-6)
  - Эквивалент: IEC 60068-2-6 (синусоидальный метод)
- **Сквозной расчет физики:** Вибрационные нагрузки на частотной ranges 10–55 Гц с амплитудой 0.15 мм могут вызывать модуляцию оптического пути с частотой модуляции f_mod ≈ v_amplitude · / λ ≈ 0.15 mm / 650 nm ≈ 230 kHz. Это может привести к фазовым флуктуациям в дифракционном пике. Фирмная монтаж элементов оптической схемы на едином фрезерованном основании из сплава Д16Т (Al 2024-T3) с жестким креплением минимизирует передачу вибраций к кристаллу TeO₂. Допуск на пространственный перекос элементов оптической оси при максимальной рабочей температуре не должен превышать 0.5 μm (требование REQ-22), что обеспечено использованием вибропрочного компенсатора из эластичного полимера с модулем упругости E ≈ 2 GPa. Расчет амплитуды перекоса: δx ≈ · a / ω², где a = 0.15·10⁻³ м, ω = 2π·55 ≈ 345 рад/с → δx ≈ 0.15·10⁻³ / 345² ≈ 1.26·10⁻⁹ м ≈ 0.00126 μm, что значительно меньше допуска 0.5 μm. Однако на более низких частотах (10 Гц) амплитуда перекоса возрастает: δx ≈ 0.15·10⁻³ / (2π·10)² ≈ 0.00024 μm, все еще в пределах допуска.
