maximmalin/simul/requirements/blocks/req_30.md

# # Блок требования REQ-30

## Консервация и защита (Preservation)
- **Требование:** Прибор проходит консервацию по варианту защиты ВЗ-10 согласно ГОСТ 9.014-78 (Эквивалент: ISO 4520 / MIL-STD-2073-1, метод 30)
- **Структурный блок:** Блок 7.1 «Консервация — Защита от коррозии»
- **Скрещивание с общими техническими требованиями:**
  - Взаимосвязь с требованием REQ-31 (низкоуровневое ПО — инициализация при включении)
  - Взаимосвязь с требованием REQ-26 (MTBF — коррозия сокращает время наработки)
- **Сквозной расчет физики:** Консервация ВЗ-10 предполагает герметичный чехол из алюминированной или трехслойной полиэтиленовой барьерной пленки с последующей просушкой внутри. Внутрь чехла закладывается расчетное количество активированного силикагеля по ГОСТ 3956-76 (тип V — поглощение влаги до 25% от своего веса). Расчетный вес: m_silica ≈ 8 г для объема корпуса V ≈ 500 см³. Срок сохраняемости без переконсервации: не менее 3 лет (per NATO STANAG 4280 / Def Stan 81-41, Level A). При хранении beyond 3 лет силикагель насыщается влажностью (влажностьRelative humidity > 80%), что при последующем включении прибора может привести к конденсации на кристалле TeO₂ и фотодиодах (см. требование REQ-18). После срока 3 лет требуется переконсервация или сушка силикагеля при 80° C в течение 2 часов.
