maximmalin/simul/requirements/blocks/req_32.md

# # Блок требования REQ-32

## Верхний уровень программного модуля (Upper-level Software Module)
- **Требование:** Наличие открытого программного модуля (Source block) для интеграции в экосистему GNU Radio для вывода комплексного потока панорамных данных в реальном времени
- **Структурный блок:** Блок 8.2 «GNU Radio Integration»
- **Скрещивание с общими техническими требованиями:**
  - Требование наличия Source block в GNU Radio
  - Совместимость с потоком данных форматов
- **Сквозной расчет физики:** Выходной фототок I_photo ≈ 0.888 мА (при P_laser = 5 мВт, η_opt ≈ 44.4%) должен конвертироваться в цифровой поток данных с разрядностью 14 бит (аналоговый эквивалент), обеспечивая динамический диапазон 85–100 дБ. Модуль должен реализовывать БПФ/FFT для математической обработки спектра на уровне CPU, а также аппаратную генерацию фаз синхронизации на ПЛИС. Интеграция в GNU Radio обеспечивает выведение комплексного потока данных с параметрами: Δn (изменение индекса преломления), displacement (смещение), strain tensors (тензоры деформации) из результатов FEM-моделирования ElmerSolver.
