maximmalin/simul/requirements/blocks/req_33.md

# # Блок требования REQ-33

## Интерфейс USB 3.0 (USB 3.0 Interface)
- **Требование:** Непрерывный захват кадров спектра по шине USB 3.0 без потери кадров
- **Структурный блок:** Блок 8.3 «Data Transfer Interface»
- **Скрещивание с общими техническими требованиями:**
  - Требование USB 3.0 Type-C / PCIe Gen2 (интерфейс передачи данных)
  - Требование аппаратной генерации фаз синхронизации на ПЛИС
- **Сквозной расчет физики:** Частота считывания строк CMOS-матрицы ≥50 кГц требует пропускной способности шины USB 3.0 (теоретическая максимальная скорость 5 Гбит/с), которая должна обеспечить передачу данных от датчиков (2 фотодиода на 4.3 мм от оси Брэгга) без пропусков. Расчет пикового потока данных: 2048 пикселей × 14 бит × 50 кадров/с = 1.4 Мбит/с (устойчиво в рамках возможности USB 3.0). Реальная пропускная способность USB 3.0 составляет 4 Гбит/с (после учета кодирования 8b/10b и overhead), что в 2850 раз превышает необходимый 1.4 Мбит/с, обеспечивая запас надежности.
