maximmalin/simul/requirements/blocks/req_34.md

# # Блок требования REQ-34

## Совместимость с GNU Radio (GNU Radio Compatibility)
- **Требование:** Модуль должен быть 호환ible с текущей версией GNU Radio и открытыми источниками
- **Структурный блок:** Блок 8.5 «Ecosystem Integration»
- **Скрещивание с общими техническими требованиями:**
  - Требование открытого программного модуля (Source block)
  - Стандарт ISO/IEC 25010 качестве ПО
- **Сквозной расчет физики:** Интеграция должна обеспечивать вывод комплексного потока данных, полученных от акустооптического процессора, с параметрами: Δn (изменение индекса преломления), displacement (смещение), strain tensors (тензоры деформации) из результатов FEM-моделирования ElmerSolver. Плотность точек данных: эпсилон_zz_mean/max/min для кварцевого слоя и ноды трансформации. Вывод данных осуществляется через Source block в GNU Radio в формате complex float (I/Q samples) с частотой выборки 50 кГц на строку и 2048 пикселей на кадр, обеспечивая паноральный обзор спектра в реальном времени.
