maximmalin/simul/requirements/blocks/req_block_06_10.md

# Блок требований: RF Frontend — Часть 2 (Усиление и фильтрация)

## Ссылка на требование: REQ-06 через REQ-10

### 6. Выходной ВЧ-драйвер (RF Output Driver)
- **Требование:** Линейный усилитель мощности сигнала до 1.5 Вт для обеспечения максимальной дифракционной эффективности пьезоэлектрического преобразователя ячейки Брэгга
- **Структурный блок:** Блок 4 «RF Frontend — Выходной тракт»
- **Скрещивание с общими техническими требованиями:**
  - Требление GOST IEC 60825-1 Class 3B (безопасность лазера)
  - Соответствие ГОСТ 30804.4.3-2013 (иммунность к внешним полям)
- **Сквозной расчет физики:** Каскад усиления ТВ-селектора + УПЧ КТ368А: G_tuner ≈ 25 дБ = 316, G_KT368 ≈ 18 дБ = 63, итоговая полная электрическая мощность на выходе: P_rf_out = (1.56×10⁻⁷ Вт) × 316 × 63 = 0.0031 Вт = 3.1 мВт (+4.9 дБм). Данная мощность укладывается в расчетный предел безопасности ≤10 мВт, выведенный ранее для исключения насыщения лазерного луча. Мощность 1.5 Вт на выходе драйвера обеспечивает максимальную дифракционную эффективность, так как не превышает порог насыщения фазового шума < -110 дБс/Гц, задаваемый ножом Фуко.

### 7. Коэффициент усиления ТВ-селектора (TV Selector Gain)
- **Требование:** Сквозной коэффициент усиления ТВ-селектора с учетом переноса частоты вверх/вниз в фиксированную ПЧ 38 МГц (≈ 25 дБ = 316)
- **Структурный блок:** Блок 2 «RF Frontend — Частоточное управление»
- **Скрещивание с общими техническими требованиями:**
  - Требование стабильности ПЧ: 38 МГц, дрейф ±250 кГц
  - Соответствие ГОСТ Р 52016-2003 (параметры приема)
- **Сквозной расчет физики:** Входной сигнал мощностью P_rec ≈ 1.56×10⁻⁷ Вт (−38 дБм) после каскада усиления: P_rf_out = P_rec × G_tuner × G_KT368 = 1.56×10⁻⁷ × 316 × 63 = 0.0031 Вт = 3.1 мВт. Это обеспечивает работу аккустооптического процессора в линейной области, так как выходная мощность недостаточна для насыщения кварцевой пластины 38 МГц.

### 8. Перенос частоты в ПЧ (Frequency Transfer to IF)
- **Требование:** Супергетеродинная схема переноса частоты в рабочий диапазон промежуточных частот акустооптического кристалла (ПЧ: 150–650 МГц)
- **Структурный блок:** Блок 3 «RF Frontend — Конвертер частот»
- **Скрещивание с общими техническими требованиями:**
  - Требование диапазона ПЧ: 150–650 МГц
  - Соответствие ГОСТ 24375-80 / IEEE Std 211 (БПЧ характеристики)
- **Сквозной расчет физики:** Перенос частоты с ВЧ-диапазона (0–7 ГГц) в ПЧ-диапазон (150–650 МГц) должен сохранять структуру сигнала для последующей обработки АЦП ESP32 в режиме I2S/DMA. Частота 38 МГц ПЧ фиксируется как центральный неотклоненный луч для расчета угла Брэгга, что критически важно для геометрического позиционирования фотодиодов на расстоянии 4.3 мм от оси центрального луча.

### 9. Питание тюнера (Tuner Power Supply)
- **Требование:** Питание тюнера (+12V или +5V) должно быть отвянуто от компьютера. Использовать линейный стабилизатор (например, LM7812/LM7805) и батарейку, выводы обвесить керамическими конденсаторами 0.1 мкФ для гашения ВЧ-пульсаций
- **Структурный блок:** Блок 5 «RF Frontend — Питание»
- **Скрещивание с общими техническими требованиями:**
  - Требование электромагнитной совместимости (ГОСТ CISPR 22-2012, Класс Б)
  - Гальваническая изоляция (полный барьер — связь с ПК только по Wi-Fi, сигнал переносится лазером)
- **Сквозной расчет физики:** Наводки от Wi-Fi модуля ESP32 в радиоприемный тракт должны быть подавлены экранированием. Стабилизация питания критически важна для поддержания стабильности ПЧ 38 МГц (дрейф ±250 кГц). Керамические конденсаторы 0.1 мкФ гасят ВЧ-пульсации, которые иначе исказили бы фазу сигнала и ухудшили бы динамический диапазон до 45–50 дБ (как у HackRF One), вместо целевых 85–100 дБ.

### 10. Экранирование RF-фронтэнда (RF Shielding)
- **Требование:** Селектор должен оставаться в родном штампованном стальном корпусе. Любые щели или открытые крышки приведут к проникновению наводок от Wi-Fi модуля ESP32 в радиоприемный тракт
- **Структурный блок:** Блок 5 «RF Frontend — Экранирование»
- **Скрещивание с общими техническими требованиями:**
  - Требование ГОСТ CISPR 22-2012 (Класс Б — для жилых и промышленных зон)
  - Требование ГОСТ 30804.4.3-2013 (иммунность к внешним полям 2–3 В/м)
- **Сквозной расчет физики:** Экранирование стальным корпусом предотвращает проникновение электромагнитных полей от Wi-Fi модуля в диапазон 0–7 ГГц. Без должного экранирования мощность помех может превысить полезный сигнал (P_rec ≈ 1.56×10⁻⁷ Вт), что приведет к насыщению АЦП и потере динамического диапазона. Правильное экранирование обеспечивает абсолютный иммунитет к РЭБ: избыточная энергия помехи превращается в свет и геометрически сбрасывается за ножом Фуко, достигая динамического диапазона 85–100 дБ.
