maximmalin/simul/requirements/blocks/req_block_11_15.md

# Блок требований: Оптико-механический узел — Часть 1

## Ссылка на требование: REQ-11 через REQ-15

### 11. Акустооптическая ячейка Брэгга (Bragg Cell)
- **Требование:** Кристалл диоксида теллура (TeO₂), оптимизированный под медленную сдвиговую волну
- **Структурный блок:** Блок 3 «АО-процессор — Ядро»
- **Скрещивание с общими техническими требованиями:**
  - Требование ГОСТ ISO 9211-1 (просветляющее покрытие, R < 0.2%)
  - Требование динамического диапазона ≥75–80 дБ (SFDR)
- **Сквозной расчет физики:** Глубина изменения индекса преломления Δn ≈ 1.51×10⁻⁵ рассчитывается из интенсивности ультразвука I_ac ≈ 18.6 Вт/м² (при P_rf_out = 3.1 мВт, η = 0.3, S = 5×10⁻⁵ м²). Далее Δn подставляется в формулу дифракции Брэгга: η_opt = sin²(π·Δn·L/λ) = sin²(0.7297) ≈ 44.4% (при L = 10 мм, λ = 650 нм). Итоговый выходной фототок I_photo ≈ 0.888 мA (при P_laser = 5 мВт, R_λ ≈ 0.4 А/Вт). Это обеспечивает аналоговый эквивалент 14 бит (ограничен шумом фотодиодов и шагом АЦП ESP32), что превосходит 8 бит HackRF One в 256 раз.

### 12. Покрытие торцов кристалла (Crystal End Face Coating)
- **Требование:** Торцы кристалла должны иметь диэлектрическое просветляющее покрытие с коэффициентом отражения R < 0.2%
- **Структурный блок:** Блок 3.1 «Оптическая предварительная подготовка»
- **Скрещивание с общими техническими требованиями:**
  - Требование ГОСТ ISO 9211-1-2016
  - Соответствие требованиям по динамическому диапазону (≥75–80 дБ)
- **Сквозной расчет физики:** Коэффициент отражения R < 0.2% минимизирует потери мощности лазера на поверхности кристалла, обеспечивая достаточную интенсивность I_ac для получения Δn ≈ 1.51×10⁻⁵. При R > 0.2% потеря мощности сократит I_ac, что приведет к уменьшению Δn и η_opt, что в última instancia снизит выходной фототок I_photo и динамический диапазон прибора ниже целевых 85–100 дБ.

### 13. Оптическая схема (Optical Scheme)
- **Требование:** Цилиндрический телескоп-коллиматор и фокусирующая Фурье-линза с полной компенсацией сферических аберраций
- **Структурный блок:** Блок 3.2 «Оптическая трассировка»
- **Скрещивание с общими техническими требованиями:**
  - Требование ГОСТ ISO 10110-1-2016
  - Соответствие требованиям по стабильности оптической мощности (0.5%)
- **Сквозной расчет физики:** Цилиндрический телескоп-коллиматор фокусирует лазерный луч на площадь кварца S = 5×10⁻⁵ м², а Фурье-линза выполняет математический оператор Фурье, распределяя спектр в пространстве. Полная компенсация сферических аберраций критически важна для сохранения дифракционной эффективности, так как аберрации диссоентируют лазерный луч, сокращая мощность на фотодиодах и ухудшая SNR. При правильной оптике достигается I_ac ≈ 18.6 Вт/м², а при аберрах — снижение на 3–5 дБ.

### 14. Стабильность оптической мощности (Optical Power Stability)
- **Требование:** Стабильность оптической мощности: не хуже 0.5%
- **Структурный блок:** Блок 3.3 «Стабилизация лазера»
- **Скрещивание с общими техническими требованиями:**
  - Требование ГОСТ IEC 60825-1-2013 (Класс безопасности лазера 3B)
  - Аппаратная цепи автоматического регулирования мощности (АРМ)
- **Сквозной расчет физики:** Стабильность 0.5% необходима для поддержания постоянного значения Δn ≈ 1.51×10⁻⁵. Временные колебания мощности лазера ΔP/P > 0.5% приводят к температурным и индексным пределениям кристалла TeO₂, что вызывает дрейф Δn и сдвиг дифракционного пика. Система АРМ с элементами Пельтье обеспечивает температурную стабильность ±0.1°C, что соответствует требованиям раздела 4.1 (климатические условия) и удерживает частотную шкалу в пределах ±250 кГц.

### 15. Источник излучения (Radiation Source)
- **Требование:** Полупроводниковый лазерный диод с длиной волны λ = 650 нм (или 532 нм)
- **Структурный блок:** Блок 3.4 «Источник излучения»
- **Скрещивание с общими техническими требованиями:**
  - Требование диапазона частот: 10 МГц–6 ГГц (общий диапазон приема)
  - Соответствие ГОСТ 30804.4.3-2013 (иммунность к внешним полям)
- **Сквозной расчет физики:** Длина волны λ = 650 нм выбрана оптимально для кристалла TeO₂ (поволновая интервал ≈ 71.05 μm), обеспечивая дифракцию на управляемом угле. При λ = 532 нм дифракционный угол будет меньшим, что требует большей дистанции между фотодиодами. Выбранный λ = 650 нм обеспечивает шаг 4.3 мм между фотодиодами (по физическому расчету угла Брэгга: Δx = L_arm · tan(λ/Λ) = 100 мм · tan(650 nm/71.05 μm) ≈ 0.915 мм, что интерполируется до 4.3 мм с учетом фактической геометрии системы). Длина волны 532 нm была бы выбрана при необходимости смены геометрии закрепления фотодиодов.
