maximmalin/simul/requirements/blocks/req_block_21_25.md

# Блок требований: Электромагнитная совместимость

## Ссылка на требование: REQ-21 через REQ-25

### 21. Экранирование корпуса (Case Shielding)
- **Требование:** Корпус должен быть выполнен из фрезерованного алюминия и разделен на три изолированные секции (ВЧ-блок, светоизолированный оптический блок, цифровой блок) с использованием радиочастотных электропроводящих прокладок
- **Структурный блок:** Блок 5 «ЭМС — Конструктивное экранирование»
- **Скрещивание с общими техническими требованиями:**
  - Требование ГОСТ CISPR 22-2012 (Класс Б — для жилых и промышленных зон)
  - Требование ГОСТ 30804.4.3-2013 (Иммунность к внешним полям 2–3 В/м)
  - Стандарт MIL-DTL-83528 (Электропроводящие прокладки)
- **Сквозной расчет физики:** Экранирование из фрезерованного алюминия (глубиной скриннинга δ ≈ √(2ρ/ωμ) ≈ 0.025 мм при f = 1 ГГц, ρ_al ≈ 2.65×10⁻⁸ О·м) предотвращает проникновение электромагнитных полей в диапазоне 0–7 ГГц. Без экранирования мощность радиопомех может превысить полезный сигнал (P_rec ≈ 1.56×10⁻⁷ Вт), что приведет к насыщению АЦП и потере динамического диапазона. Правильное экранирование обеспечивает абсолютный иммунитет к РЭБ: избыточная энергия помехи превращается в свет и геометрически сбрасывается за ножом Фуко, достигая динамического диапазона 85–100 дБ. РФ-прокладки обеспечивают контактное экранирование между секциями с сопротивлением ≤10 mΩ на частоту до 10 ГГц.

### 22. Иммунитет к внешним электромагнитным полям (Immunity)
- **Требование:** Прибор должен сохранять работоспособность и заложенный динамический диапазон при воздействии внешних электромагнитных полей в соответствии с ГОСТ 30804.4.3-2013 (уровень жесткости 2 — 3 В/м)
- **Структурный блок:** Блок 5.2 «Иммунитет к помехам»
- **Скрещивание с общими техническими требованиями:**
  - Требование ГОСТ CISPR 22-2012 (Класс Б)
  - Соответствие IEC 61000-4-3 (уровень 2 — 3 В/м)
- **Сквозной расчет физики:** Уровень внешних полей 2–3 В/м на частоте 80–2700 МГц может индуцировать напряжение в ВЧ-контуре. При входном сопротивлении 50 Ом индуцированная мощность P_ind = (E·h)² / (50 Ω), где h = эффективная длина антенны. При E = 3 В/м и h ≈ 0.1 m (для компактного устройства) P_ind ≈ 1.8×10⁻⁵ Вт, что в 115 раз превышает полезный сигнал P_rec ≈ 1.56×10⁻⁷ Вт. Экранивание и фильтры гасят индицированные помехи не менее чем на 40–60 дБ, обеспечивая сохранение динамического диапазона 85–100 дБ. Нож Фуко additionally снижает фазовый шум от оставшихся помех до < -110 дБс/Гц.

### 23. Уровень радиопомех (Emission Level)
- **Требование:** Уровень индустриальных радиопомех, создаваемых прибором, не должен превышать норм, установленных в ГОСТ CISPR 22-2012 (Класс Б)
- **Структурный блок:** Блок 5.3 «Эмиссия radiated и conducted»
- **Скрещивание с общими техническими требованиями:**
  - Требование ГОСТ CISPR 22-2012 (Класс Б — для применения в жилых и промышленных зонах)
  - Эквивалент: EN 55022
- **Сквозной расчет физики:** Прибор не должен создавать радиопомех, которые могли бы самосовершенствовать другие устройства в районе. Источник помех — это Wi-Fi модуль ESP32 (работает на частотах 2.4 ГГц и 5 ГГц) и цифровой блок (переключения на частоте процессора). Экранированный алюминиевый корпус с RFI-прокладками гасит излучение Wi-Fi модуля на уровень ≤ -30 дБм/м (по сравнению с открытым радиатором). Линейные стабилизаторы питания (LM7812/LM7805) вместо импульсных уменьшают проводимые помехи. Обязательное использование керамических конденсаторов 0.1 мкФ на выводях стабилизаторов для гашения ВЧ-пульсаций.

### 24. Фильтры питания (Power Supply Filters)
- **Требование:** Все линии питания (+12V, +5V, GND) должны быть оборудованы фильтрами заторного конденсатора и обводчиков для гашения ВЧ-шума
- **Структурный блок:** Блок 5.4 «Фильтры питания»
- **Скрещивание с общими техническими требованиями:**
  - Взаимодействие с требованием REQ-19 (стабилизация ±0.1° C)
  - Взаимодействие с требованием REQ-04 (NF ≤ 3.5 дБ)
- **Сквозной расчет физики:** Фильтры заторного конденсатора (cutoff frequency fc ≈ 1/(2π√(LC))) с L ≈ 10 μH и C ≈ 100 nF дают fc ≈ 16 кГц, что гасит ВЧ-пульсации стабилизаторов питания. Обводчики (ferrite beads) с сопротивлением R_f ≈ 100 Ω при f ≈ 100 МГц подавляют высокочастотные шумы. Без фильтров ВЧ-шум от стабилизаторов питания (особенно импульсных) проникал бы в ВЧ-тракт, ухудшая коэффициент шума NF с норм 3.5 дБ до 10–15 дБ, что приведет к потере чувствительности до −85 дБм (вместо целевых −110 дБм) и динамическому диапазону 45–50 дБ (вместо 85–100 дБ).

### 25. Зонирование экранирования (Shielding Zoning)
- **Требование:** Корпус разделен на три изолированные секции (ВЧ-блок, светоизолированный оптический блок, цифровой блок)
- **Структурный блок:** Блок 5.5 «Зонирование」
- **Скрещивание с общими техническими требованиями:**
  - Взаимодействие с требованием REQ-21 (экранирование корпуса)
  - Взаимодействие с требованием REQ-04 (NF ≤ 3.5 дБ)
  - Взаимодействие с требованием REQ-07 (laser diode λ = 650 nm)
- **Сквозной расчет физики:** Зонирование предотвращает кросс-контакт между блоками: ВЧ-блок (высокие частоты 0–7 ГГц) физически отделен от оптического блока (свет, 650 нм), чтобы RF-пери не проникали в область фотодиодов. Цифровой блок (ESP32, ПЛИС) отделен обоими от электромагнитным экраном (Al partition с RFI-прокладками). Это обеспечивает гальваническую изоляцию: связь с ПК идет только по Wi-Fi, а сигнал переносится лазером. Разделение зон позволяет достичь абсолютного иммунитета к РЭБ, так как помехи от Wi-Fi модуля не могут проникать в радиоприемный тракт, а энергия помех, проникающая в optical channel, превращается ножом Фуко в геометрическую скидывание, сохраняя динамический диапазон 85–100 дБ.
