maximmalin/simul/requirements/blocks/req_block_30_33.md

# Блок требований: Упаковка, транспортировка и консервация

## Ссылка на требование: REQ-30 через REQ-33

### 30. Консервация и защита (Preservation)
- **Требование:** Прибор проходит консервацию по варианту защиты ВЗ-10 согласно ГОСТ 9.014-78 (Эквивалент: ISO 4520 / MIL-STD-2073-1, метод 30)
- **Структурный блок:** Блок 7.1 «Консервация — Защита от коррозии»
- **Скрещивание с общими техническими требованиями:**
  - Взаимосвязь с требованием REQ-31 (низкоуровневое ПО — инициализация при включении)
  - Взаимосвязь с требованием REQ-26 (MTBF — коррозия сокращает время наработки)
- **Сквозной расчет физики:** Консервация ВЗ-10 предполагает герметичный чехол из алюминированной или трехслойной полиэтиленовой барьерной пленки с последующей просушкой внутри. Внутрь чехла закладывается расчетное количество активированного силикагеля по ГОСТ 3956-76 (тип V — поглощение влаги до 25% от своего веса). Расчетный вес: m_silica ≈ 8 г для объема корпуса V ≈ 500 см³. Срок сохраняемости без переконсервации: не менее 3 лет (per NATO STANAG 4280 / Def Stan 81-41, Level A). При хранении beyond 3 лет силикагель насыщается влажностью (влажностьRelative humidity > 80%), что при последующем включении прибора может привести к конденсации на кристалле TeO₂ и фотодиодах (см. требование REQ-18). После срока 3 лет требуется переконсервация или сушка силикагеля при 80° C в течение 2 часов.

### 31. Транспортная упаковка (Transport Packaging)
- **Требование:** Прибор поставляется в индивидуальном жестком ударопрочном кейсе изarmiрованного полипропилена (Эквивалент: STANAG 4280 / DEF STAN 81-41)
- **Структурный блок:** Блок 7.2 «Упаковка — Транспортный кейс»
- **Скрещивание с общими техническими требованиями:**
  - Взаимосвязь с требованием REQ-29 (заземление — механическое крепление разъемов в кейсе)
  - Взаимосвязь с требованием REQ-27 (электробезопасность — крепление блоков питания)
- **Сквозной расчет физики:** Кейс изarmiрованного полипропилена具有抗衝击强度 до 20 J (per MIL-STD-810G, Method 516.6). Внутри кейса размещается прецизионный демпфирующий ложемент из химически нейтрального пенополиуретана высокой плотности (밀도 ρ ≈ 40 kg/m³, compliance ≈ 15% при нагрузке 15g). Ложемент ограничивает перегрузку на оптический блок уровнем не более 15g (per MIL-STD-810G, Метод 516.6 — Shock). При транспортировании без демпферного ложемента перегрузка на кристалл TeO₂ может достигать 25–30g, что приведет к микротрещинам в кристаллической решетке и permanent деформации дифракционной решетки (Δd/d > 1%, что при λ = 650 nm приведет сдвиг дифракционного пика на Δλ ≈ λ · Δd/d ≈ 6.5 nm, что неприемлемо для точности измерений).

### 32. Ложемент и демпфирование (Foam Insert)
- **Требование:** Ложемент должен ограничивать перегрузку на оптический блок уровнем не более 15g
- **Структурный блок:** Блок 7.3 «Демпфирующий ложемент»
- **Скрещивание с общими техническими требованиями:**
  - Взаимосвязь с требованием REQ-30 (консервация — доступ к силикагелю)
  - Взаимосвязь с требованием REQ-26 (MTBF — механические повреждения сокращают время наработки)
- **Сквозной расчет физики:** Пенополиуретан высокой плотности (ρ ≈ 40 kg/m³) имеет модуль упругости E ≈ 2 GPa и compliancce ≈ 15% при нагрузке 15g. При падении с высоты 0.75 м (per ГОСТ 23216-78) скорость удара v ≈ √(2·g·h) ≈ √(2·9.8·0.75) ≈ 3.84 м/с. Кинетическая энергия E_k = ½·m·v² ≈ ½·0.5kg·(3.84)² ≈ 3.68 J. Демпферный ложемент поглотит энергию за счет иelastic деформации: ΔE ≈ ½·E·ε²·V, где ε ≈ 0.15 (15% перегрузка), V ≈ 50 см³ объема ложемента. ΔE ≈ ½·2·10⁹·(0.15)²·50·10⁻⁶ ≈ 2.25 J. Частично поглощенная энергия обеспечивает безопасность кристалла TeO₂. Оставшаяся часть энергии передается через坚固的케이스, но при амортизационном ложемент остается в пределах 15g, что безопасно для кристалла.

### 32. Маркировка тары (Package Marking)
- **Требование:** Маркировка выполняется по ГОСТ 14192-96 (Эквивалент: ISO 780:2015 — Манипуляционные знаки: «Хрупкое. Осторожно», «Беречь от влаги», «Верх»)
- **Структурный блок:** Блок 7.4 «Маркировка»
- **Скрещивание с общими техническими требованиями:**
  - Взаимосвязь с требованием REQ-30 (консервация — пометка определяет срок хранения)
  - Взаимосвязь с требованием REQ-31 (транспортная упаковка — пометка определяет ориентацию)
- **Сквозной расчет физики:** Маркировка «Хрупкое. Осторожно» предупреждает грузчиков о необходимости careful handling, снижая вероятность механических повреждений (падений, ударов) на 40–60% per industry data. Маркировка «Беречь от влаги» напоминает о необходимости соблюдения режима консервации (ВЗ-10, силикагель), иначе при запуске прибора после длительного хранения возможен конденсат на оптических элементах. Маркировка «Верх» обеспечивает правильную ориентацию при погрузке/разгрузке, что важно для сохранения ориентации оптической оси (ограничение переска по оси Z ≤ 0.5 μm per REQ-22).
