maximmalin/simul/work/tz-c/block2_acousto_optic.md

***[ГОСТ 34.602-89]***

**ПЕРЕДАЧА ТЕХНИЧЕСКОГО ЗАДАНИЯ**

На разработку изделия: **Акусто-оптическое инверторное ядро (Отсек 2)** для приёмника Brig Receiver

Шифр темы: **B2_AcoustoOptic**

> Документ составлен по образцу РГР «Перетворювач з 5 на 9В» (КПІ, 2024) + ГОСТ 34.602-89, ГОСТ 2.114-2016 (ЕСКД).

---

## 1. ОБЩИЕ СВЕДЕНИЯ

### 1.1. Наименование изделия
**Акусто-оптический преобразователь (отсек 2)** — узел 2.x структурной схемы `structural.drawio`.

### 1.2. Область применения
Преобразование электромагнитного сигнала СВЧ-диапазона (38 МГц) в оптический сигнал, модулируемый акустической волной в оргстекле ТОСП. Выход: дифференциальный фототок для последующей FPAA-обработки (отсек 3).

### 1.3. Исполнение
Оптическая скамья 100 мм. Режим Брэгга с параметром Клейна-Кука Q = 10.88. Звукопровод: литьевой оргстекло ТОСП. Вскрытый кварцевый резонатор 38 МГц как пьезopreобразователь.

---

## 2. НАЗНАЧЕНИЕ И ЦЕЛИ СОЗДАНИЯ

### 2.1. Назначение
Модуляция лазерного луча (650 нм, 45 мА) акустической волной сжатия в оргстекле с соблюдением условия Брэгга (угол 2θ_B = 0.524°). Выходной сигнал: пространственно-временная модуляция интенсивности лазера на ножe Фуко, детектируемая PIN-матрицей.

### 2.2. Цель создания
Получение акусто-оптического спектрального фильтра с Министерским динамическим диапазоном, свободным от интермодуляционных искажений (IMD3), за счёт перевода СВЧ-сигнала в оптический домен.

---

## 3. ТЕХНИЧЕСКИЕ ТРЕБОВАНИЯ К ИЗДЕЛИЮ

### 3.1. Требования к структуре (поузловой состав)

Отсек 2 должен содержать 4 изолированных узла:

#### Узел 2.1 — Пьезopreобразователь (вскрытый кварц 38 МГц)
- Компоненты: вскрытый кварцевый резонатор HC-49/U, 38 МГц
- Монтаж: эпоксидный компаунд, приклеенный к торцу бруска оргстекла
- Функция: преобразование электрического сигнала 38 МГц из СВЧ-тракта (узел 1.5, КТ368А) в упругую волну сжатия в оргстекле
- Вход: электрический сигнал с выхода КТ368А (P_max ≤ 1.0 мВт, U_пп ≤ 0.63 В)
- Выход: акустический импульс в оргстекле

#### Узел 2.2 — Звукопровод (оргстекло ТОСП)
- Компоненты: брусок литьевого оргстекла ТОСП по ГОСТ 17622-72 размером 20 × 30 × 5 мм
- Полировка торцов: до зеркала (R_z ≤ 0.025 мкм)
- Косой срез 45° с поролоновым поглотителем звука (без отражений)
- Период фазовой решётки: Λ = 71.05 мкм (на частоте 38 МГц)
- Параметр Брэгга: Q = 10.88 (Клейн-Кук)

#### Узел 2.3 — Лазер DVD (650 нм)
- Компоненты: полупроводниковый красный лазерный диод от DVD-привода, 650 нм
- Ток лазера: строго 45 мА (стабилизатор на ОУ К140УД7 + транзистор КТ368А)
- Функция: источник когерентных эталонных фотонов, прошивающих оргстекло перпендикулярно акустической волне

#### Узел 2.4 — Драйвер лазера (стабилизатор тока)
- Компоненты: ОУ К140УД7 + транзистор КТ368А (стабилизатор постоянного тока)
- Ток лазера: 45 мА ± 1 мА
- Обратная связь: контроль тока через шунтирующий резистор

#### Узел 2.5 — Нож Фуко (пространственный фильтр)
- Компоненты: лезвие бритвы, микрометрический винт М3×0.25, антилюфтовая пружина
- Функция: перекрытие центральной оси лазера на 50%, пространственный сдвиг светового пятна
- Шаг: 0.25 мм на оборот

#### Узел 2.6 — Фотоприёмник (PIN-матрица)
- Компоненты: дифференциальная PIN-матрица BPW34 / SFH203
- Ёмкость перехода: C_j ≤ 72 пФ
- Пространственный Pitch между центрами площадок: строго 0.915 мм
- Диапазон выходного фототока: от 100 нА (темновой ток кремния) до 600 мкА (пиковая раскачка кварца)
- Функция: детектирование модулированного лазерного излучения

### 3.2. Требования к электромагнитной совместимости и фильтрации питания

- Питание от стерильного LDO (LM7805, узел 5.3)
- Оптическая часть (лазер, фотодиоды, ОУ) должна питаться исключительно от стерильного линейного регулятора
- Защита от наводок: экранированный отсек алюминия (Д16Т, 1.5 мм)

---

## 4. ОСНОВНЫЕ ПАРАМЕТРЫ И ЭКСТРЕМАЛЬНЫЕ ДИАПАЗОНЫ СИГНАЛОВ

| Параметр | Значение | Ед. |
|---|---|-----|
| Частота волновой решётки в оргстекле | 71.05 | мкм |
| Параметр Клейна-Кука (Брэгга) | 10.88 | — |
| Угол дифракции луча в воздухе | 0.524° (0.00915 рад) | ° |
| Пространственный шаг фотодиодов (Pitch) | 0.915 | мм |
| Оптическое плечо L | 100 | мм |
| Длина волны лазера | 650 | нм |
| Ток лазера | 45 ± 1 | мА |
| Частота кварцевого резонатора | 38 | МГц |
| Диапазон фототока (выход) | 100 нА – 600 мкА | А |
| Максимальная мощность на кварц (от СВЧ-тракта) | ≤ 1.0 мВт | мВт |
| U_пп защитной вилки (вход кварца) | ≤ 0.63 | В |
| R_z полировки торцов оргстекла | ≤ 0.025 | мкм |

---

## 5. ТРЕБОВАНИЯ К ПРОГРАММНОМУ ОБЕСПЕЧЕНИЮ ВЕРИФИКАЦИИ (DevOps)

- Математическая верификация: FMU-блок симуляции Octave/MATLAB (`photonic_sdr_fmu.m`) в репозиторий Forgejo, проверка стабильности геометрических и токовых параметров при каждом git push
- Elmer FEM (модуль Solid Mechanics): расчёт деформаций оргстекла под действием акустической волны (nodes: 303, elements: 764, Tet10)
- Meep FDTD 3D: моделирование распространения лазера через оргстекло с акустической модуляцией (150×120×60, 1200 timesteps)
- Аналитические расчёты (Python): Bragg angle, Δn, efficiency, photodiode power — `bragg_optics_calc.py`

---

## ДОДАТОК А. Схема электрическая принципиальная

- Электрическая цепь: КТ368А → пьезopreобразователь (кварц 38 МГц) → оргстекло → лазер 650 нм → нож Фуко → PIN-матрица → FPAA (отсек 3)
- Питание: стерильный LDO 5В для лазера, ОУ, фотодиодов
- Стабилизатор тока лазера: ОУ К140УД7 + транзистор КТ368А, 45 мА

---

## ДОДАТОК Б. Перечень элементов

| Узел | Компонент | Количество | Примечание |
|---|---|---|---|
| 2.1 | Кварцевый резонатор HC-49/U, 38 МГц | 1 | вскрытый, эпоксидный компаунд |
| 2.2 | Оргстекло ТОСП 20×30×5 мм | 1 | ГОСТ 17622-72, полировка R_z ≤ 0.025 мкм |
| 2.3 | Лазерный диод DVD 650 нм | 1 | от DVD-привода |
| 2.4 | ОУ К140УД7 | 1 | стабилизатор тока |
| 2.4 | Транзистор КТ368А | 1 | стабилизатор тока |
| 2.5 | Лезвие бритвы + М3×0.25 + пружина | 1 комплект | нож Фуко |
| 2.6 | PIN-фотодиод BPW34 | 2+ | дифференциальная матрица, C_j ≤ 72 пФ |
| 2.6 | PIN-фотодиод SFH203 | 2+ | дифференциальная матрица |
| Питание | LDO LM7805 | 1 | стерильный |

---

## ДОДАТОК В. Кресление механической части

- Оптическая скамья: 100 мм (стандарт)
- Положение лазера: перпендикулярно поверхности оргстекла
- Положение ножа Фуко: на выходе лазера из оргстекла
- Положение PIN-матрицы: за ножом Фуко, на расстоянии обеспечивающем Pitch = 0.915 мм

---

## ДОДАТОК Г. Кресление электронного модуля

- Вскрытый кварц 38 МГц приклеен эпоксидным компаундом к торцу оргстекла
- Лазер 650 нм закреплён на оптической скамье, настроен на прохождение через оргстекло
- Нож Фуко: микрометрический винт М3×0.25 с антилюфтовой пружиной

---

## ДОДАТОК Д. Спецификация на электронный модуль

- Узел 2.x — 6 подузлов: пьезopreобразователь, оргстекло, лазер, драйвер лазера, нож Фуко, фотоприёмник
- Режим Брэгга: Q = 10.88, Λ = 71.05 мкм, 2θ_B = 0.524°
- Диапазон фототока: 100 нА – 600 мкА
- Питание: стерильный LDO 5В
