maximmalin/simul/technical_task_ru.md

# Техническое задание НА РАЗРАБОТКУ СВЕРХШИРОКОПОЛОСНОГО SDR-ПРИЕМНИКА НА ОСНОВЕ АКУСТООПТИЧЕСКОГО ПРОЦЕССОРА БРЭГГА

## ШИФР ПРОЕКТУ: «АОП-SDR-SPECTR»

Стандарт оформления документа: ГОСТ 2.105-95 / ГОСТ 19.201-78 (Эквивалент: ISO 5807:1985 / ISO/IEC TR 29115)

---

## 1. ОБЩИЕ СВЕДЕНИЯ И ЦЕЛЬ РАЗРАБОТКИ

**Название изделия:** Панорамный радиоприемник программно-определяемого радио (SDR) на базе акустооптического процессора (АОП) Брэгга.

**Назначение:** Безпоисковый панорамный автоматический радиомониторинг, обнаружение и перехват сложных радиосигналов со сверхкороткой длительностью (сигналы с ППРЧ/FHSS, радарные системы, СШП-системы) в условиях плотной помеховой обстановки.

**Целевой ориентир:** Изделие должно превосходить платформу HackRF One по мгновенной полосе пропускания (не менее чем в 25 раз) и по динамическому диапазону по блокированию (не менее чем на 30 дБ).

---

## 2. ТЕХНИЧЕСКИЕ ПАРАМЕТРЫ И СРАВНИТЕЛЬНЫЕ ХАРАКТЕРИСТИКИ

### Порівняльна таблиця параметрів:

| Наименование параметра / Характеристики | Прототип (HackRF One) | Проектуеме вироби (АОП-SDR) | Стандарти відповідності (ГОСТ / ISO) |
|---|---|---|---|
| Диапазон входных рабочих частот | 1 МГц — 6.0 ГГц | 10 МГц — 6.0 ГГц | ГОСТ Р 52016-2003 / ITU-R SM.328 |
| Мгновенная блузова группа (Real-time BW) | 20 МГц | не менее 500 МГц (целевая: 1000 МГц) | ГОСТ 24375-80 / IEEE Std 211 |
| Динамический диапазон по блокированию (SFDR) | ~45...50 дБ | не менее 75...80 дБ | ГОСТ Р 52016-2003 / IEEE Std 1385 |
| Эквивалентная разрядность спектра | 8 бит | 14 бит (определяется КМОП-линейкой) | ГОСТ Р 52016-2003 / ISO/IEC 2382 |
| Апаратное время задержки (Latency) | Переменное (от ПО) | фиксированное, ≤ 2.0 мкс | ГОСТ 24375-80 / ISO/IEC/IEEE 24748 |
| Частотный крок на пиксель (на пиксель) | Зависит от БПФ в ПО | ≤ 250 кГц (2048 пикселей на 500 МГц блузова группа) | ГОСТ 24375-80 / IEEE Std 1664 |
| Интерфейс передачи данных на ПК | USB 2.0 High Speed | USB 3.0 Type-C / PCIe Gen2 | Стандарты USB-IF / PCI-SIG |

---

## 3. ТРЕБОВАНИЯ К КОНСТРУКТИВНЫМ И ФУНКЦИОНАЛЬНЫМ ПОДСИСТЕМАМ

### 3.1. Радиочастотный тракт (RF Frontend)

- Входное сопротивление ВЧ-порта: 50 Ом, разъем типа SMA (ГОСТ 20275-91 / Эквивалент: IEC 60169-15).
- Коэффициент шума (Noise Figure, NF) входного тракта: не более 3.5 дБ (Эквивалент: IEEE Std 145).
- ВЧ-тракт должен содержать коммутируемый блок преселекторов, малошумящий усилитель с защитой от перегрузки (до +20 дБм) и супергетеродинную схему переноса частот в рабочий диапазон промежуточных частот акустооптического кристалла (ПЧ: 150–650 МГц).
- Выходной ВЧ-драйвер: Линейный усилитель мощности сигнала до 1.5 Вт для обеспечения максимальной дифракционной эффективности пьезоэлектрического преобразователя ячейки Брэгга.

### 3.2. Оптико-механический узел (АО-процессор)

- Источник излучения: Полупроводниковый лазерный диод с длиной волны λ = 650 нм (или 532 нм). Стабильность оптической мощности: не хуже 0.5%.
- Наличие цепи автоматического регулирования мощности (АРМ) (ГОСТ IEC 60825-1-2013 / Эквивалент: IEC 60825-1 — Класс безопасности лазера 3B).
- Акустооптическая ячейка Брэгга: Кристалл диоксида теллура (TeO₂), оптимизированный под медленную сдвиговую волну.
- Торцы кристалла должны иметь диэлектрическое просветляющее покрытие с коэффициентом отражения R < 0.2% (ГОСТ ISO 9211-1-2016 / Эквивалент: ISO 9211-1).
- Оптическая схема: Цилиндрический телескоп-коллиматор и фокусирующая Фурье-линза с полной компенсацией сферических аберраций (ГОСТ ISO 10110-1-2016 / Эквивалент: ISO 10110).

### 3.3. Тракт цифровой обработки сигналов (ЦОС)

- Регистратор: Высокоскоростная линейная КМОП-матрица (не менее 2048 пикселей) с динамическим диапазоном пикселя не менее 72 дБ и частотой считывания строк не менее 50 кГц (Эквивалент: EMVA 1288 Standard).
- Базовая ПЛИС: Семейство индустриального класса Xilinx Artix-7 или Intel Cyclone V.
- Функции прошивки ПЛИС: Аппаратная генерация фаз синхронизации и считывания данных с КМОП-матрицы. Конвейерная компенсация темнового тока (Dark Current Compensation) и неравномерности лазерного профиля («Flat-Field»). Интеграция с контроллером шины USB 3.0 (FTDI FT601 или аналог) для передачи данных на хост без потери кадров.

---

## 4. КЛИМАТИЧЕСКИЕ И МЕХАНИЧЕСКИЕ УСЛОВИЯ ЭКСПЛУАТАЦИИ

### 4.1. Климатические условия

Изделие разрабатывается в климатическом исполнении УХЛ4 по ГОСТ 15150-69 (Эквивалент: IEC 60721-3-3, Класс 3K3 / 3M1 — эксплуатация в закрытых помещениях с искусственно регулируемым климатом):

- Рабочий диапазон температур: от +15° C до +30° C (Эквивалент: ISO 554-1976).
- Предельный диапазон температур (в выключенном состоянии): от -40° C до +50° C.
- Относительная влажность воздуха: не более 80% при температуре +25° C (без конденсации влаги).
- Конструкция должна содержать активную систему термостабилизации лазерного диода и АО-ячейки на базе элементов Пельтье с точностью удержания температуры ± 0.1° C во избежание температурного дрейфа шкалы частот.

### 4.2. Механические воздействия

- Конструкция в упакованном и рабочем состоянии должна соответствовать требованиям ГОСТ 30631-99 (Эквивалент: IEC 60068-2-6 — Испытания на вибрацию, синусоидальный метод): устойчивость к вибрационным нагрузкам в диапазоне частот 10–55 Гц с амплитудой смещения до 0.15 мм.
- Элементы оптической схемы должны быть жестко смонтированы на едином фрезерованном основании из сплава Д16Т (Эквивалент материала: Aluminum 2024-T3 / ISO 209). Допуск на пространственный перекос элементов оптической оси при максимальной рабочей температуре не должен превышать 0.5 мкм.

---

## 5. ЭЛЕКТРОМАГНИТНАЯ СОВМЕСТИМОСТЬ (ЭМС)

- Помехоэмиссия: Уровень индустриальных радиопомех, создаваемых прибором, не должен превышать норм, установленных в ГОСТ CISPR 22-2012 (Эквивалент: CISPR 22 / EN 55022, Класс Б — для применения в жилых и промышленных зонах).
- Помехоустойчивость: Прибор должен сохранять работоспособность и заложенный динамический диапазон при воздействии внешних электромагнитных полей в соответствии с ГОСТ 30804.4.3-2013 (Эквивалент: IEC 61000-4-3, уровень жесткости 2 — 3 В/м).
- Конструктивное экранирование: Корпус должен быть выполнен из фрезерованного алюминия и разделен на три изолированные секции (ВЧ-блок, светоизолированный оптический блок, цифровой блок) с использованием радиочастотных электропроводящих прокладок (Эквивалент: MIL-DTL-83528 / требования по экранированию EMI).

---

## 6. ТРЕБОВАНИЯ К НАДЕЖНОСТИ И БЕЗОПАСНОСТИ

- Надежность: Среднее время наработки на отказ (T₀) должно составлять не менее 10 000 часов по ГОСТ 27.002-2015 (Эквивалент: ISO 13849-1 / IEC 61508).
- Электробезопасность: Изделие должно соответствовать требованиям безопасности по ГОСТ IEC 60950-1-2014 (Эквивалент: IEC 60950-1 / IEC 62368-1 — Оборудование информационных технологий).

---

## 7. УПАКОВКА, ТРАНСПОРТИРОВАНИЮ И КОНСЕРВАЦИЯ

### 7.1. Защита и консервация

Прибор проходит консервацию по варианту защиты ВЗ-10 согласно ГОСТ 9.014-78 (Эквивалент: ISO 4520 / MIL-STD-2073-1, метод 30 — герметичный чехол из алюминированной или трехслойной полиэтиленовой барьерной пленки). Внутрь чехла закладывается расчетное количество активированного силикагеля по ГОСТ 3956-76 (Эквивалент: ISO 11623 / MIL-D-3464E, тип V). Срок сохраняемости без переконсервации: не менее 3 лет (Эквивалент: военный стандарт NATO STANAG 4280 / Def Stan 81-41, Level A Preservation).

### 7.2. Транспортная упаковка

Прибор поставляется в индивидуальном жестком ударопрочном кейсе из армированного полипропилена (Эквивалент: STANAG 4280 / DEF STAN 81-41). Внутри кейса размещается прецизионный демпфирующий ложемент из химически нейтрального пенополиуретана высокой плотности (Эквивалент: ISO 1856). Ложемент должен ограничивать перегрузку на оптический блок уровнем не более 15g (Эквивалент испытания: MIL-STD-810G, Метод 516.6 — Shock). Маркировка тары: Выполняется по ГОСТ 14192-96 (Эквивалент: ISO 780:2015 — Манипуляционные знаки: «Хрупкое. Осторожно», «Беречь от влаги», «Верх»).

### 7.3. Транспортирование

Упакованное изделие должно выдерживать транспортную тряску по ГОСТ 23216-78 (Условия «Ж» — жесткие; Эквивалент: ASTM D4169-16 / IEC 60068-2-64): ускорение до 3g при частоте ударов от 80 до 120 в минуту в течение 3 часов, а также одиночное падение в упакованном виде с высоты 0.75 м на твердое основание (Эквивалент: MIL-STD-810G, Метод 516.6).

---

## 8. ТРЕБОВАНИЯ К ПРОГРАММНОМУ ОБЕСПЕЧЕНИЮ (HOST API)

- Низкоуровневое ПО: Кроссплатформенный драйвер (C/C++, Linux/Windows) для инициализации ПЛИС и непрерывного захвата кадров спектра по шине USB 3.0 без пропусков (Эквивалент стандартов качества ПО: ISO/IEC 25010).
- Верхний уровень: Наличие открытого программного модуля (Source block) для интеграции в экосистему GNU Radio для вывода комплексного потока панорамных данных в реальном времени.

**Важно: в тз не должно быть описание узлов прибора детальное только стандарты и требования**
