maximmalin/simul/technical_task_ua.md

# Технічне завдання НА РАЗРАБОТКУ СВЕРХШИРОКОПОЛОСНОГО SDR-ПРИЕМНИКА НА ОСНОВЕ АКУСТООПТИЧЕСКОГО ПРОЦЕССОРА БРЭГГА

## ШИФР ПРОЕКТУ: «АОП-SDR-SPECTR»

Стандарт оформлення документа: ГОСТ 2.105-95 / ГОСТ 19.201-78 (Еквівалент: ISO 5807:1985 / ISO/IEC TR 29115)

---

## 1. ОБЩІ СВІДЕННЯ І ЦЕЛЬ РАЗРАБОТКИ

**Назва вироби:** Панормальний радиоприемник програмно-определяємого радіо (SDR) на базі акустооптичного процесора (АОП) Брэгга.

**Назначення:** Безпоисковий панормальний автоматичний радіомоніторинг, виявлення та перехоплення складних радіосигналів із надверхиною довжиною імпульсу (сигнали з ППРЧ/FHSS, радарні системи, СШП) у умовах щільної помехової обстановки.

**Целевий орієнт:** Виробство має перевищувати платформу HackRF One за instanteю шириною блузова групи (не менш як у 25 разів) та за динамічним діапазоном по блокуванню (не менш як на 30 дБ).

---

## 2. ТЕХНІЧЕСКИЕ ПАРАМЕТРЫ И СРАВНИТЕЛЬНЫЕ ХАРАКТЕРИСТИКИ

### Порівняльна таблиця параметрів:

| Наименование параметра / Характеристики | Прототип (HackRF One) | Проектуеме вироби (АОП-SDR) | Стандарти відповідності (ГОСТ / ISO) |
|---|---|---|---|
| Диапазон входних робочих частот | 1 МГц — 6.0 ГГц | 10 МГц — 6.0 ГГц | ГОСТ Р 52016-2003 / ITU-R SM.328 |
| Мгновена блузова група (Real-time BW) | 20 МГц | не менш як 500 МГц (цільова: 1000 МГц) | ГОСТ 24375-80 / IEEE Std 211 |
| Динамічний діапазон по блокуванню (SFDR) | ~45...50 дБ | не менш як 75...80 дБ | ГОСТ Р 52016-2003 / IEEE Std 1385 |
| Еквівалентна розрядність спектра | 8 біт | 14 біт (определяється КМОП-матрицею) | ГОСТ Р 52016-2003 / ISO/IEC 2382 |
| Апаратне время затримки (Latency) | Змінне (від ПО) | фіксоване, ≤ 2.0 мкс | ГОСТ 24375-80 / ISO/IEC/IEEE 24748 |
| Частотний крок на піксель (на пиксель) | Залежить від БПФ в ПО | ≤ 250 кГц (2048 пикселів на 500 МГц блузова група) | ГОСТ 24375-80 / IEEE Std 1664 |
| Інтерфейс передачі даних на ПК | USB 2.0 High Speed | USB 3.0 Type-C / PCIe Gen2 | Стандарти USB-IF / PCI-SIG |

---

## 3. ТРЕБОВАНИЯ К КОНСТРУКТИВНЫМ И ФУНКЦИОНАЛЬНЫМ ПОДСИСТЕМАМ

### 3.1. Радіохоротний тракт (RF Frontend)

- Вхідне опір ВЧ-порта: 50 Ом, раз'єм типа SMA (ГОСТ 20275-91 / Еквівалент: IEC 60169-15).
- Коефіцієнт шуму (Noise Figure, NF) входного тракта: не більш 3.5 дБ (Еквівалент: IEEE Std 145).
- ВЧ-тракт має містити комутативний блок преселекторів, малошумящий усилитель з захистом від перевантаження (до +20 дБм) та супергетеродинна схема переноса частот у робочий діапазон промежуточних частот акустооптичного кристалла (ПЧ: 150–650 МГц).
- Вихідний ВЧ-драйвер: Линійний усилитель мощності сигнала до 1.5 Вт для забезпечення максимальної дифракційної ефективності пьезоéлектричного преобразовача ячейки Брэгга.

### 3.2. Оптико-механічний узел (АО-процессор)

- Источник ізлучення: Полупроводниковый лазерний діод з довжиною волни λ = 650 нм (або 532 нм). Стабільність оптовлаги: не гірше 0.5%.
- Наличие ціки автоматического регулювання потужності (АРМ) (ГОСТ IEC 60825-1-2013 / Еквівалент: IEC 60825-1 — Класс безпеки лазера 3B).
- Акустооптична ячейка Брэгга: Кристалл диоксида теллура (TeO₂), оптимізований під повільне зсувове хвилі.
- Торці кристалла повинні мати дієлектричне просвітлювальне покриття з коефіцієнтом відбиття R < 0.2% (ГОСТ ISO 9211-1-2016 / Еквівалент: ISO 9211-1).
- Оптична схема: Цилиндричний телескоп-колліматор та фокусируюча Фур'є-лінза з повною компенсацією сферичних аберрацій (ГОСТ ISO 10110-1-2016 / Еквівалент: ISO 10110).

### 3.3. Тракт цифрової обробки сигналів (ЦОС)

- Реєстратор: Високоскорістня лінійна КМОП-матриця (не менш як 2048 пикселів) із динамічним діапазоном пикселя не менш 72 дБ та частотою читання рядків не менш 50 кГц (Еквівалент: EMVA 1288 Standard).
- Базовая ПЛІС: Сім'я індустріального класу Xilinx Artix-7 або Intel Cyclone V.
- Функції прошивки ПЛІС: Апаратна генерація фаг синхронізації та читання даних з КМОП-матриці. Конвейерна компенсація темного току (Dark Current Compensation) та нерівномірності лазерного профілю («Flat-Field»). Інтеграція з контроллером шини USB 3.0 (FTDI FT601 або аналог) для передачі даних на хост без втрати кадрів.

---

## 4. КЛІМАТИЧЕСКИЕ И МЕХАНИЧЕСКИЕ УСЛОВИЯ ЕКСПЛУАТАЦИИ

### 4.1. Климатические умови

Виробництво розробляється в кліматичному виплетенні УХЛ4 по ГОСТ 15150-69 (Еквівалент: IEC 60721-3-3, Класс 3K3 / 3M1 — експлуатація в закритих помешканях із штучно регулюваним кліматом):

- Робочий діапазон температур: від +15° C до +30° C (Еквівалент: ISO 554-1976).
- Предельний діапазон температур (в вимкненому стані): від -40° C до +50° C.
- Відносна вологість повітря: не більш 80% при температурі +25° C (без конденсації вологості).
- Конструкція повинна містити активну систему термостабілізації лазерного діода та АО-ячейок на базі елементів Пель'є з точністю утримання температури ± 0.1° C воBesі температурного дрейфу шкали частот.

### 4.2. Механічні впливи

- Конструкція в упакованому та робочому стані повинна відповідати вимогам ГОСТ 30631-99 (Еквівалент: IEC 60068-2-6 — Спроба на вібрацію, синусоидальний метод): устойчвість до вібраційних навантажень у діапазоні частот 10–55 Гц з амплітудою зміщення до 0.15 мм.
- Елементи оптичної схеми повинні бути жорстко спільновані на єдиному фрезерованому основі із сплава Д16Т (Еквівалент матеріалу: Aluminum 2024-T3 / ISO 209). Допуск на простіровий перекос елементів оптичної осі при максимальній робочій температурі не повинен перевищувати 0.5 мкм.

---

## 5. ЭЛЕКТРОМАГНИТНАЯ СОВМЕСТИМОСТЬ (ЭМС)

- Помехоэмиссия: Уровень індустріальних радіопомех, створених прибором, не повинен перевищувати норм, встановлені в ГОСТ CISPR 22-2012 (Еквівалент: CISPR 22 / EN 55022, Класс Б — для використання в жильних та промислових зонах).
- Помехоустойчивость: Прибор повинен зберігати робочність та заложений динамічний діапазон при воздінні зовнішніх электромагнитних полів у відповідності з ГОСТ 30804.4.3-2013 (Еквівалент: IEC 61000-4-3, рівень жорсткості 2 — 3 В/м).
-Конструктивне екранінг: Корпус повинен бути виконаний із фрезерованого алюмінію та поділений на три ізольовані секції (ВЧ-блок, світоз ізольований оптичний блок, цифровий блок) з використанням радіочастотних електропроводячих прокладок (Еквівалент: MIL-DTL-83528 / вимоги по екраніванні EMI).

---

## 6. ТРЕБОВАНИЯ К НАДЕЖНОСТИ И БЕЗОПАСНОСТИ

- Надежність: Средній час наработки на отказ (T₀) повинен складатися не менш 10 000 годин по ГОСТ 27.002-2015 (Еквівалент: ISO 13849-1 / IEC 61508).
- Електробезопасность: Виробство повинно відповідати вимогам безпеки по ГОСТ IEC 60950-1-2014 (Еквівалент: IEC 60950-1 / IEC 62368-1 — Оборудование інформаційних технологій).

---

## 7. УПАКОВКА, ТРАНСПОРТИРОВАНИЮ И КОНСЕРВАЦИЯ

### 7.1. Захист та консервация

Виробство проходить консервацію по варіанту захисту ВЗ-10 по ГОСТ 9.014-78 (Еквівалент: ISO 4520 / MIL-STD-2073-1, метод 30 — герметичний чохол із алюмініованої або трислайкової поліетиленової бар'єрної плинки). Всередині чохла закладається розрахункова кількість активатованого силикагеля по ГОСТ 3956-76 (Еквівалент: ISO 11623 / MIL-D-3464E, тип V). Термін зберігання без переконсервації: не менш 3 роки (Еквівалент: військовий стандарт NATO STANAG 4280 / Def Stan 81-41, Level A Preservation).

### 7.2. Транспортна упаковка

Виробство поставляється в індивідуальному жорсткому ударопроному кейсі із армірованого поліпропилена (Еквівалент: STANAG 4280 / DEF STAN 81-41). Всередині кейсу розміщується прецизийний демпфіруючий ложемент із хімічно нейтрального пенополіуретану високої щільності (Еквівалент: ISO 1856). Ложемент повинен обмежувати перевантаження на оптичний блок рівнем не більше 15g (Еквівалент спроба: MIL-STD-810G, Метод 516.6 — Shock). Маркування тари: Виконується по ГОСТ 14192-96 (Еквівалент: ISO 780:2015 — Маніпуляційні знаки: «Хрупке. Осторожно», «Беречь від вологості», «Верх»).

### 7.3. Транспортирование

Упаковане виробство повинно витримати транспортну тряску по ГОСТ 23216-78 (Умови «Ж» — жорсткі; Еквівалент: ASTM D4169-16 / IEC 60068-2-64): розтягнування до 3g при частоті ударів від 80 до 120 в хвилину протягом 3 годин, а також одиночне падіння у упакованному вигляді з висоти 0.75 м на тверде основне (Еквівалент: MIL-STD-810G, Метод 516.6).

---

## 8. ТРЕБОВАНИЯ К ПРОГРАММНОМУ ОБЕСПЕЧЕННЮ (HOST API)

- Низькокоштовне ПО: Кроссплатформний драйвер (C/C++, Linux/Windows) для ініціалізації ПЛІС та неперервного захвата кадрів спектра по шині USB 3.0 без пропусків (Еквівалент стандартів якості ПО: ISO/IEC 25010).
- Верхній рівень: Налічті відкритого програмного модуля (Source block) для інтеграції в екосистему GNU Radio для виведення комплексного потоку панорамних даних у реальному часі.

**Важливо: в тз не повинно бути опису узлів прибора детально — тільки стандарти та вимоги.**
