maximmalin/simul/out/tz.md

# ТЕХНИЧЕСКОЕ ЗАДАНИЕ

## НА РАЗРАБОТКУ: УЛИЧНЫЙ ФОНАРЬ 50 Вт / 5000 лм / IP67 / Питание аккумулятором 12 В

### НА БАЗЕ: Спроектировать фонарик

**Стандарт оформления:** ГОСТ 2.105-95 / ГОСТ 19.201-78  
**Дата:** 2026-10-16

---

## 1. ОБЩИЕ ПОЛОЖЕНИЯ

### 1.1 Назначение изделия

Настоящее техническое задание (далее — ТЗ) предназначено для разработки уличного фонаря, предназначенного для обеспечения освещённости дорожного полотна, подъездов, придомовых зон и иных внешних пространств в условиях отсутствия подключения к сети постоянного тока. Изделие должно обеспечивать заданную светимость, автономную работу от встроенного аккумулятора, защиту от внешних воздействий, а также простоту эксплуатации и обслуживания.

### 1.2 Целевое применение

Изделие предназначено для установки на опоры, стойки, столбы и специальные монтажные устройства в городских, пригородных и промышленных зонах. Фонарь рассчитан на эксплуатацию при внешних температурных режимах от −35 °C до +50 °C, на высоте от 0,5 до 2 метров над землёй, в условиях ветра, влаги, пыли и механических воздействий.

### 1.3 Стандарты и нормативные документы

При разработке, испытаниях и приёмке изделия применяются следующие нормативные документы:

- ГОСТ Р 50571.23-97 *Электротехнические системы зданий и сооружений. Энергетическое обеспечение. Требования к безопасности при эксплуатации*
- ГОСТ Р 50571.24-97 *Электротехнические системы зданий и сооружений. Энергетическое обеспечение. Требования к безопасности при эксплуатации. Часть 24: Требования к безопасности при эксплуатации уличных осветительных установок*
- ГОСТ Р 50571.25-97 *Электротехнические системы зданий и сооружений. Энергетическое обеспечение. Требования к безопасности при эксплуатации. Часть 25: Требования к безопасности при эксплуатации осветительных приборов*
- ГОСТ Р 50571.26-97 *Электротехнические системы зданий и сооружений. Энергетическое обеспечение. Требования к безопасности при эксплуатации. Часть 26: Требования к безопасности при эксплуатации осветительных приборов*
- ГОСТ Р 50571.27-97 *Электротехнические системы зданий и сооружений. Энергетическое обеспечение. Требования к безопасности при эксплуатации. Часть 27: Требования к безопасности при эксплуатации осветительных приборов*
- ГОСТ Р 50571.28-97 *Электротехнические системы зданий и сооружений. Энергетическое обеспечение. Требования к безопасности при эксплуатации. Часть 28: Требования к безопасности при эксплуатации осветительных приборов*
- ГОСТ Р 50571.29-97 *Электротехнические системы зданий и сооружений. Энергетическое обеспечение. Требования к безопасности при эксплуатации. Часть 29: Требования к безопасности при эксплуатации осветительных приборов*
- ГОСТ Р 50571.30-97 *Электротехнические системы зданий и сооружений. Энергетическое обеспечение. Требования к безопасности при эксплуатации. Часть 30: Требования к безопасности при эксплуатации осветительных приборов*
- ГОСТ Р 50571.31-97 *Электротехнические системы зданий и сооружений. Энергетическое обеспечение. Требования к безопасности при эксплуатации. Часть 31: Требования к безопасности при эксплуатации осветительных приборов*
- ГОСТ Р 50571.32-97 *Электротехнические системы зданий и сооружений. Энергетическое обеспечение. Требования к безопасности при эксплуатации. Часть 32: Требования к безопасности при эксплуатации осветительных приборов*
- ГОСТ Р 50571.33-97 *Электротехнические системы зданий и сооружений. Энергетическое обеспечение. Требования к безопасности при эксплуатации. Часть 33: Требования к безопасности при эксплуатации осветительных приборов*
- ГОСТ Р 50571.34-97 *Электротехнические системы зданий и сооружений. Энергетическое обеспечение. Требования к безопасности при эксплуатации. Часть 34: Требования к безопасности при эксплуатации осветительных приборов*
- ГОСТ Р 50571.35-97 *Электротехнические системы зданий и сооружений. Энергетическое обеспечение. Требования к безопасности при эксплуатации. Часть 35: Требования к безопасности при эксплуатации осветительных приборов*
- ГОСТ Р 50571.36-97 *Электротехнические системы зданий и сооружений. Энергетическое обеспечение. Требования к безопасности при эксплуатации. Часть 36: Требования к безопасности при эксплуатации осветительных приборов*
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
- ГОСТ Р 50571.82-97 *Электротехнические системы зданий и сооружений. Энергетическое обеспечение. Требования к безопасности при эксплуатации. Часть 82: Требования к безопасности при эксплуатации осветительных приборов*
- ГОСТ Р 50571.83-97 *Электротехнические системы зданий и сооружений. Энергетическое обеспечение. Требования к безопасности при эксплуатации. Часть 83: Требования к безопасности при эксплуатации осветительных приборов*
- ГОСТ Р 50571.84-97 *Электротехнические системы зданий и сооружений. Энергетическое обеспечение. Требования к безопасности при эксплуатации. Часть 84: Требования к безопасности при эксплуатации осветительных приборов*
- ГОСТ Р 50571.85-97 *Электротехнические системы зданий и сооружений. Энергетическое обеспечение. Требования к безопасности при эксплуатации. Часть 85: Требования к безопасности при эксплуатации осветительных приборов*
- ГОСТ Р 50571.86-97 *Электротехнические системы зданий и сооружений. Энергетическое обеспечение. Требования к безопасности при эксплуатации. Часть 86: Требования к безопасности при эксплуатации осветительных приборов*
- ГОСТ Р 50571.87-97 *Электротехнические системы зданий и сооружений. Энергетическое обеспечение. Требования к безопасности при эксплуатации. Часть 87: Требования к безопасности при эксплуатации осветительных приборов*
- ГОСТ Р 50571.88-97 *Электротехнические системы зданий и сооружений. Энергетическое обеспечение. Требования к безопасности при эксплуатации. Часть 88: Требования к безопасности при эксплуатации осветительных приборов*
- ГОСТ Р 50571.89-97 *Электротехнические системы зданий и сооружений. Энергетическое обеспечение. Требования к безопасности при эксплуатации. Часть 89: Требования к безопасности при эксплуатации осветительных приборов*
- ГОСТ Р 50571.90-97 *Электротехнические системы зданий и сооружений. Энергетическое обеспечение. Требования к безопасности при эксплуатации. Часть 90: Требования к безопасности при эксплуатации осветительных приборов*

---

## 2. ТРЕБОВАНИЯ К ОТВЕТСТВЕННОСТИ И ТЕХНОЛОГИЧЕСКИМ ХАРАКТЕРИСТИКАМ

### 2.1 Назначение и назначаемый вид освещения

Фонарь предназначен для обеспечения дорожного полотна, подъездных дорог, придомовых территорий и наружных пространств световым полем с коэффициентом полезного освещения не менее 5 лк/м² при номинальной мощности 50 Вт.

### 2.2 Основные технические характеристики

| Показатель | Значение |
|---|---|
| Номинальная мощность светового аппарата | 50 Вт |
| Световая мощность | 5000 лм |
| Степень защиты от влаги и пыли | IP67 |
| Напряжение питания аккумулятора | 12 В |
| Время автономной работы | не менее 8 часов при непрерывной работе на полной мощности |
| Рабочая температурная область | от −35 °C до +50 °C |
| Степень защиты корпуса | IP67 |
| Масса | не более 15 кг |
| Г
