maximmalin/simul/docs/reference/gost_structural_scheme.md

# Нормативная база структурной схемы Э1 (источник цитат)

Методичка агентам `backend/agents/knowledge/structural_scheme.md` опирается
на эти стандарты. Здесь — что именно взято и откуда, чтобы правку методички
можно было проверить по первоисточнику, а не по памяти.

## ГОСТ 2.701-2008 — виды и типы схем

Определение типа 1 (структурная): «Документ, определяющий основные
функциональные части изделия, их назначение и взаимосвязи». Отсюда — код
типа `1` в обозначении `Э1` на поле чертежа (основная надпись по
ГОСТ 2.104).

- allgosts.ru/01/100/gost_2.701-2008
- docs.cntd.ru/document/1200001986

## ГОСТ 2.702-2013, п. 5.1 — правила выполнения структурных схем

Цитаты, на которых стоит методичка:

- **5.1.1** «На структурной схеме изображают все основные функциональные
  части изделия (элементы, устройства и функциональные группы) и основные
  взаимосвязи между ними».
- **5.1.2** «Функциональные части на схеме изображают в виде
  прямоугольников или УГО».
- **5.1.3** «Графическое построение схемы должно обеспечивать наилучшее
  представление о последовательности взаимодействия функциональных частей
  в изделии. На линиях взаимосвязей рекомендуется стрелками обозначать
  направление хода процессов, происходящих в изделии».
- **5.1.4** «На схеме должны быть указаны наименования каждой
  функциональной части изделия, если для ее обозначения применен
  прямоугольник».
- **5.1.5** «При большом количестве функциональных частей допускается
  взамен наименований, типов и обозначений проставлять порядковые номера
  справа от изображения или над ним, как правило, сверху вниз в направлении
  слева направо. В этом случае наименования, типы и обозначения указывают
  в таблице, помещаемой на поле схемы».
- **4.5** «Допускается помещать на схеме поясняющие надписи, диаграммы
  или таблицы…» — основание для подписи линии назначением сигнала.

Источники: ruscable.ru/info/snip/Data1/11/11511 (ГОСТ 2.702-75, ранняя
редакция, текст совпадает по смыслу), studfile.net/preview/21956200/
(раздел 5 целиком), scribd.com/document/928742939, dnaop.com (ДСТУ
ГОСТ 2.702-2013), bsuir.by/m/12_100229_1_126901.pdf (официальная публикация
ГОСТ 2.702-2011).

**Почему на Э1 нет позиционных обозначений деталей.** Их присваивают на
принципиальной (Э3) — п. 5.3.7: «Каждый элемент и (или) устройство,
имеющее самостоятельную принципиальную схему… должны иметь обозначение
(позиционное обозначение) в соответствии с ГОСТ 2.710»; на функциональной
(Э2) — п. 5.2.15. В п. 5.1 (структурная) такого требования нет, и
наименование функциональной части даётся текстом (5.1.4). Позиционные
обозначения функциональных групп на схемах, где они нужны, присваиваются
по ГОСТ 2.710 — отсюда буквенные коды в наименовании блока.

## ГОСТ 2.709-90 — обозначения цепей

Имена цепей (`VREG`, `LED_KAT`, `+3V3`) — предмет этого стандарта, и он
относится к схемам с видимыми выводами и разработанными цепями. В п. 5.1
(структурная) требования обозначать цепи нет, зато есть 4.5 (поясняющие
надписи). Поэтому линия Э1 подписывается **назначением сигнала**, а не
именем цепи: имя цепи — материал принципиальной схемы.

## ГОСТ 2.710-81 — буквенно-цифровые обозначения

Таблица 1 (буквенные коды групп видов элементов), использованная в
методичке для выбора кода функциональной части:

| Код | Группа | Примеры из стандарта |
|---|---|---|
| A | Устройства | усилители, приборы телеуправления, лазеры, мазеры |
| B | Преобразователи неэлектрических величин в электрические и наоборот | микрофоны, громкоговорители, датчики, детекторы излучений |
| D | Схемы интегральные, микросборки | аналоговые и цифровые ИС, логические элементы, устройства памяти |
| F | Разрядники, предохранители, устройства защитные | FA, FP, FU, FV |
| G | Генераторы, источники питания | батареи (GB), кварцевые осцилляторы |
| H | Устройства индикационные и сигнальные | HL (световая сигнализация), HG (символьный индикатор), HA (звуковая) |
| K | Реле, контакторы, пускатели | KA, KH, KK, KM, KT, KV |
| L | Катушки индуктивности, дроссели | |
| M | Двигатели | |
| P | Приборы, измерительное оборудование | PV (вольтметр), PA (амперметр), PG (осциллограф), PT (часы) |
| Q | Выключатели и разъединители в силовых цепях | QF, QK, QS |
| S | Устройства коммутационные в цепях управления, сигнализации и измерительных | SA (выключатель), SB (кнопка), SC (коммутатор), SF (автоматический) |
| T | Трансформаторы, автотрансформаторы | TA (тока), TS (стабилизатор) |
| U | Преобразователи электрических величин в электрические, устройства связи | UB (модулятор), UR (демодулятор), UI (дискриминатор), UZ (преобразователь частотный/инвертор/выпрямитель) |
| V | Приборы электровакуумные, полупроводниковые | VD (диод), VT (транзистор), VS (тиристор) |
| W | Линии и элементы СВЧ, антенны | WA (антенна), WE (ответвитель), WU (аттенюатор) |
| X | Соединения контактные | XP (штырь), XS (гнездо), XT (разборное соединение) |
| Y | Устройства механические с электромагнитным приводом | YA (электромагнит), YB (тормоз) |
| Z | Устройства оконечные, фильтры, ограничители | ZL (ограничитель), ZQ (кварцевый фильтр), ZA/ZF/ZV (фильтры тока/частоты/напряжения) |

Таблица 2 (двухбуквенные коды) используется в конвейере на Э3, где
присваиваются позиционные обозначения деталям.

Источники: elektroshema.ru/2009-02-05-22-57-45/ugo-2/58-oboznbukv.html
(обе таблицы целиком), pntd.ru/2.710.htm, topeng.ru/state_standard-2-710-81-3-1.html.

## ГОСТ 2.728-74 и серия ГОСТ 2.7xx (УГО конкретных элементов)

Серия стандартов 2.728–2.755 задаёт условные графические
обозначения отдельных элементов: 2.728-74 (резисторы, конденсаторы),
2.729-74 (обозначения общего применения), 2.736-…, 2.743-91 (логические
элементы) и т.д. («2.728-2014» как единого документа не существует —
номера этой серии навешиваются разные на старые и новые документы). На
Э1 эта серия не нужна: по 5.1.2 функциональная часть изображается
**прямоугольником**, а не УГО конкретной детали.

## Украина: национальная редакция ЕСКД

В Украине действует та же ЕСКД под национальными номерами —
ДСТУ ГОСТ 2.xxx:2xxx, принятые на основании соответствующих ГОСТ без
изменений текста (метод параллельного применения):

- ДСТУ ГОСТ 2.701-2013 (ЭСКД. Виды и типы схем …) ≡ ГОСТ 2.701-2008;
- ДСТУ ГОСТ 2.702-2013 (ЭСКД. Правила выполнения электрических схем) ≡
  ГОСТ 2.702-2011/2013;
- ДСТУ ГОСТ 2.710-2012 (буквенно-цифровые обозначения) ≡ ГОСТ 2.710-81;
- ДСТУ ГОСТ 2.709, ДСТУ ГОСТ 2.739 и др.

Пункт 5.1 и матрица букв совпадают слово-в-слово, поэтому методичка
действует для заказов как российских, так и украинских конструкторских
служб. Различаются только оформление основной надписи (ГОСТ 2.104 /
ДСТУ 2.104) и ссылки на документы в таблицах — принципы (прямоугольники,
наименования, поток сигналов, отсутствие ref/номиналов на Э1) те же.

ДСТУ ГОСТ 2.702-2013 лежит в свободном доступе на dnaop.com и scribd.

## Практика, не покрытая стандартом

- Подпись линии назначением сигнала — разрешение 4.5, не предписание.
  Формально допустимо и не подписывать линии вовсе.
- Порядок блоков по потоку сигнала — из 5.1.3 (наглядность
  последовательности), конкретное «слева направо» — наше соглашение,
  чтобы рендер был детерминированным.
- Раскладка по классам изделий (таблица в разделе 3 методички) — не
  стандарт, а ориентир для агента: состав блоков выводится из заказа.
