maximmalin/simul/work/tz-b/block1_rf_frontend.md

***[ГОСТ 34.602-89]***
**ПЕРЕДАЧА ТЕХНИЧЕСКОГО ЗАДАНИЯ**
На разработку изделия: **СВЧ-тракт, конвертер и селекция** для приёмника Brig Receiver

Шифр темы: **B1_RFfrontend**

> Документ составлен по примеру РГР «Перетворювач з 5 на 9В» // Національний технічний університет «Київський політехнічний інститут», 2024 + ГОСТ 34.602-89, ГОСТ 2.114-2016 (ЕСКД).

---
## 1. ОБЩИЕ СВЕДЕНИЯ

### 1.1. Наименование изделия
**СВЧ-коммутаторно-конверторный блок (отсек 1)** — узел 1.x структурной схемы `structural.drawio`.

### 1.2. Область применения
Приём, селекция и нисходящее преобразование радиосигналов в диапазоне 0–7 ГГц с последующей выдачей на фиксированную ПЧ 38 МГц. Встраивается в моноблочныйSDR-приёмник Brig Receiver (4 отсека).

### 1.3. Исполнение
Алюминиевый экранированный отсек (стенка Д16Т 1.5 мм). СВЧ-коммутация, смешение, селекция каналов, буферизация ПЧ.

---
## 2. НАЗНАЧЕНИЕ И ЦЕЛИ СОЗДАНИЯ

### 2.1. Назначение
Коммутация трёх антенных каналов (А: 0–900 МГц, Б: 1.2–3.0 ГГц, В: 4.0–7.0 ГГц), нисходящее смешение в каждом диапазоне, селекция каналов на варакторном фильтре, выдача на фиксированную ПЧ 38 МГц.

### 2.2. Цель создания
Достижение динамического диапазона ≥ 115 дБ за счёт защитной вилки (КД522/1N4148), балансных диодных мостов (3А112А) и аппаратной фильтрации на входе ПЧ.

---
## 3. ТЕХНИЧЕСКИЕ ТРЕБОВАНИЯ К ИЗДЕЛИЮ

### 3.1. Требования к структуре (поузловой состав)

Отсек 1 должен содержать 4 изолированных узла:

#### Узел 1.1 — СВЧ PIN-ключи
- Компоненты: диоды КА507 (бескорпусные PIN-диоды)
- Функция: мгновенное запирание выбранного входа, глушение во время Wi-Fi burst (ESP32, узел 4.4)
- Входы: 3 (канал А, Б, В) → выход: 1 (на ТВ-тунер)
- Копланарный волновод GCPW 50 Ом: ширина 1.2 мм, зазор 0.2 мм

#### Узел 1.2 — Микшер 1 (1.2–3 ГГц)
- Компоненты: балансный диодный мост на GaAs Шоттки-диодах 3А112А
- Опорный гетеродин: 2.0 ГГц (фиксированный)
- Диапазон: 1.2–3.0 ГГц → выходная ПЧ 38 МГц (разностная частота f_вх − 2.0 ГГц)
- Требование: IMD3 ≤ −40 дБ

#### Узел 1.3 — Микшер 2 (4.0–7 ГГц)
- Компоненты: балансный диодный мост на 3А112А
- Опорный гетеродин: 5.15 ГГц (LNB-стабилизация)
- Диапазон: 4.0–7.0 ГГц → выходная ПЧ 38 МГц (разностная частота f_вх − 5.15 ГГц)

#### Узел 1.4 — ТВ-селектор каналов (KS-H-132)
- Варакторная фильтрация
- Noise Figure (NF): ≤ 4 дБ
- Выходная ПЧ: 38 МГц (фиксированная)
- Каналы: ПЧ-селекция после микшеров

#### Узел 1.5 — Буферный УПЧ КТ368А
- Преобразователь: КТ368А (СВЧ-транзистор, Класс А)
- Ток коллектора: 5 мА
- Сопротивление эмиттера: R_e = 100 Ом
- Согласование: S11 ≤ −18 дБ
- Защита: встречно-параллельная пара КД522/1N4148, U_пп ≤ 0.63 В

### 3.2. Требования к электромагнитной совместимости и фильтрации питания

- Питание от стерильного LDO (LM7805, узел 5.3)
- На границе отсека 1 в цепь питания: СВЧ-дроссель BLM18 + керамика 10 нФ + 33 пФ на частотах 2.4 ГГц
- Экранирование отсека: алюминиевая стенка 1.5 мм (Д16Т), изоляция помех ≥ 80 дБ

---
## 4. ОСНОВНЫЕ ПАРАМЕТРЫ И ЭКСТРЕМАЛЬНЫЕ ДИАПАЗОНЫ СИГНАЛОВ

| Параметр | Значение | Ед. |
|---|---|-----|
| Входной диапазон частот | 0–900 МГц (канал А), 1.2–3.0 ГГц (канал Б), 4.0–7.0 ГГц (канал В) | Гц |
| Входная РЧ-мощность (порог обнаружения) | −100 дБм | дБм |
| Входная РЧ-мощность (предел компрессии) | 0 дБм (зажатый защитными диодами) | дБм |
| Частота волновой решётки (ПЧ) | 38 МГц (фиксированная) | Гц |
| Защитная вилка: U_пп | ≤ 0.63 В | В |
| S11 (КТ368А) | ≤ −18 дБ | дБ |
| Ток коллектора КТ368А | 5 мА | мА |
| ПЧ выходной сигнал | 38 МГц | Гц |

---
## 5. ТРЕБОВАНИЯ К ПРОГРАММНОМУ ОБЕСПЕЧЕНИЮ ВЕРИФИКАЦИИ (DevOps)

- Среда разработки аппаратной части: atopile (.ato) для автогенерации нетлистов + KiCad 9
- Математическая верификация: FMU-блок симуляции Octave/MATLAB (`photonic_sdr_fmu.m`) в репозиторий Forgejo, проверка стабильности геометрических и токовых параметров при каждом git push
- Verilog-аппаратная часть микшеров: не требуется (аналоговая схема)

---
## ДОДАТОК А. Схема электрическая принципиальная

- Блок-схема: PIN-ключи → микшер 1 / микшер 2 → ТВ-селектор → КТ368А → ПЧ 38 МГц
- Напряжение питания: LDO 5В (стерile), SВЧ-дроссель BLM18 + керамика
- Защитная вилка: КД522 + 1N4148 (встречно-параллельная), U_пп ≤ 0.63 В
- Кварцевый резонатор 38 МГц: вскрытый, эпоксидный компаунд, HC-49/U

---
## ДОДАТОК Б. Перечень элементов

| Узел | Компонент | Количество | Remark |
|---|---|---|---|
| 1.1 | PIN-диод КА507 | 3 (1 на вход, но по факту 3 входа) | бескорпусный |
| 1.2 | GaAs Шоттки-диод 3А112А | 4 (мост) | балансный |
| 1.3 | GaAs Шоттки-диод 3А112А | 4 (мост) | балансный |
| 1.4 | Варактор (переменный конденсатор) | 1+ | KS-H-132 |
| 1.5 | СВЧ-транзистор КТ368А | 1 | Класс А, 5 мА |
| 1.6 | Защитный диод КД522 | 2 | встречно-параллельно |
| 1.6 | Защитный диод 1N4148 | 2 | встречно-параллельно |
| Питание | LDO LM7805 | 1 | чистое 5В |

---
## ДОДАТОК В. Кресление друкованной платы

- СВЧ-текстолит FR-4, толщина 0.8 мм (антенный модуль) — см. антенный отсек
- Для отсека 1: алюминиевый токопроводящий слой (экран), GCPW 50 Ом
- Ширина проводника GCPW: 1.2 мм, зазор: 0.2 мм
- Разводка по звезде: отдельная звезда для каждого микшера

---
## ДОДАТОК Г. Кресление электронного модуля

- СВЧ-контур: сверхминиатюрный, в отсеке алюминиевого корпуса
- Защита от перегрева: алюминиевая стенка 1.5 мм (Д16Т), изоляция ≥ 80 дБ

---
## ДОДАТОК Д. Спецификация на электронный модуль

- Узел 1.x — 4 подузла: PIN-ключи, микшер 1, микшер 2, ТВ-селектор + буфер УПЧ
- Кварцевый резонатор 38 МГц вскрытый, приклеенный эпоксидным компаундом
- Питание: стерильный LDO, защита от СВЧ-наводок
- Динамический диапазон: ≥ 115 дБ (с фильтрацией помех)
