maximmalin/simul/hardware/kicad/bom/bom_grouped.csv

Refs | Value | Footprint | Qty
C8,C9 | 10p | Capacitor_SMD:C_0603_1608Metric | 2
C7 | 33p | Capacitor_SMD:C_0603_1608Metric | 1
C3,C14 | 10n | Capacitor_SMD:C_0603_1608Metric | 2
C4 | 22n | Capacitor_SMD:C_0603_1608Metric | 1
C6,C10,C11,C13 | 100n | Capacitor_SMD:C_0603_1608Metric | 4
C15 | 1u | Capacitor_SMD:C_0603_1608Metric | 1
L1 | 18u | Inductor_SMD:L_12x12mm_H6mm | 1
C1 | 220u | Capacitor_SMD:CP_Elec_6.3x7.7 | 1
C2,C5 | 470u | Capacitor_SMD:CP_Elec_6.3x7.7 | 2
C12 | 1000u | Capacitor_SMD:CP_Elec_6.3x7.7 | 1
F1 | 2A | Fuse:Fuse_1812_4532Metric | 1
X2 | 2GHz | Crystal:Crystal_AT310_D3.0mm_L10.0mm_Horizontal | 1
R2 | 2.2 | Resistor_SMD:R_2512_6332Metric | 1
J1 | 7.4V | Battery:BatteryHolder_Keystone_1042_1x18650 | 1
R13 | 680 | Resistor_SMD:R_0603_1608Metric | 1
R1 | 1k | Resistor_SMD:R_0603_1608Metric | 1
R6-R12 | 10k | Resistor_SMD:R_0603_1608Metric | 7
R5 | 50k | Resistor_SMD:R_0603_1608Metric | 1
X1 | 38MHz | Crystal:Crystal_AT310_D3.0mm_L10.0mm_Horizontal | 1
D5 | 1N4148 | Diode_SMD:D_SOD-323 | 1
TP8 | ADC_IN | TestPoint:TestPoint_Pad_D1.0mm | 1
A1 | ANT_CHA | RF_Antenna:Johanson_2450AT43F0100 | 1
A2 | ANT_CHB | RF_Antenna:Johanson_2450AT43F0100 | 1
A3 | ANT_CHC | RF_Antenna:Johanson_2450AT43F0100 | 1
FB1 | BLM18 | Inductor_SMD:L_0603_1608Metric | 1
PD1-PD4 | BPW34 | Package_TO_SOT_SMD:SOT-23 | 4
B1 | BRAGG | Crystal:Crystal_AT310_D3.0mm_L10.0mm_Horizontal | 1
U8 | ESP32-WROOM-32 | RF_Module:ESP32-WROOM-32 | 1
TP1 | IF_2G | TestPoint:TestPoint_Pad_D1.0mm | 1
ANT2 | IFA_2G4 | RF_Antenna:Johanson_2450AT43F0100 | 1
D1-D3 | KA507 | Package_TO_SOT_SMD:SOT-23 | 3
D4 | KD522 | Package_TO_SOT_SMD:SOT-23 | 1
Q1 | KT368 | Package_TO_SOT_SMD:SOT-23 | 1
T1 | KV-38 | Crystal:Crystal_AT310_D3.0mm_L10.0mm_Horizontal | 1
LS1 | LD-14 | LED_SMD:LED_0603_1608Metric | 1
U2 | LM78L05 | Package_TO_SOT_SMD:SOT-223-3_TabPin2 | 1
U1 | MP2303 | Package_SO:SOIC-8_3.9x4.9mm_P1.27mm | 1
TP2 | PDT_I | TestPoint:TestPoint_Pad_D1.0mm | 1
TP3 | PDT_II | TestPoint:TestPoint_Pad_D1.0mm | 1
TP4 | PDT_III | TestPoint:TestPoint_Pad_D1.0mm | 1
TP5 | PDT_IV | TestPoint:TestPoint_Pad_D1.0mm | 1
TP9 | RF_OUT | TestPoint:TestPoint_Pad_D1.0mm | 1
J4 | SPI Slave 18 МГц | Connector_PinHeader_2.54mm:PinHeader_1x06_P2.54mm_Vertical | 1
J3 | SPI → ESP32 | Connector_PinHeader_2.54mm:PinHeader_1x06_P2.54mm_Vertical | 1
U7 | STM32F103C8Tx | Package_QFP:LQFP-48_7x7mm_P0.5mm | 1
TP7 | TIA_OUT | TestPoint:TestPoint_Pad_D1.0mm | 1
U4,U5 | TL061 | Package_DIP:DIP-8_W7.62mm | 2
U6 | TL082 | Package_DIP:DIP-8_W7.62mm | 1
TP6 | UBIAS | TestPoint:TestPoint_Pad_D1.0mm | 1
LED1 | WIFI_LED | LED_SMD:LED_0603_1608Metric | 1
J2 | Внешнее питание 8…12 В | Connector:JWT_A3963_1x02_P3.96mm_Vertical | 1
M1B? | Нож Фуко М3×0.25 | Connector:JWT_A3963_1x02_P3.96mm_Vertical | 1
M1 | Смеситель 1 (2А112А-6) | Connector:NS-Tech_Grove_1x04_P2mm_Vertical | 1
M2 | Смеситель 2 (2А112А-6) | Connector:NS-Tech_Grove_1x04_P2mm_Vertical | 1
U1B? | ТВ-селектор KS-H-132 | Connector_PinHeader_2.54mm:PinHeader_1x08_P2.54mm_Vertical | 1
