maximmalin/simul/hardware/antenna/geometry/band_a.step

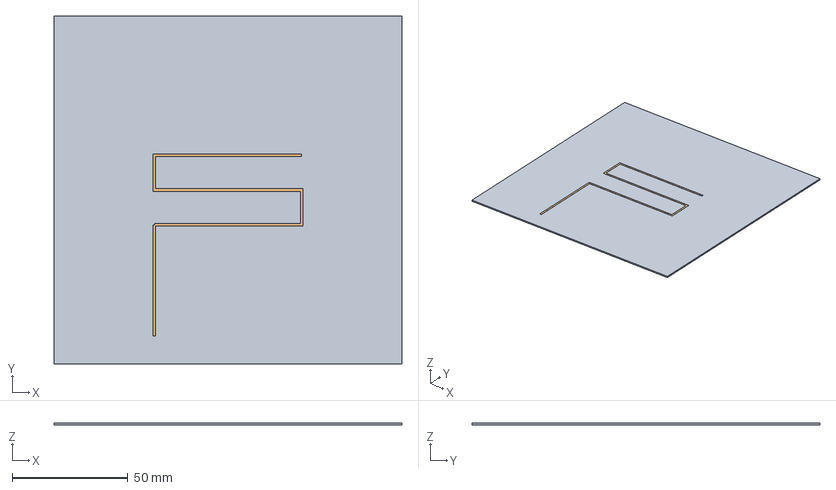
[picture p1: CAD file, 2026-10-15]
hardware/antenna/geometry/band_a.step
150.0 x 150.0 x 0.87 mm
band_a_fr4
band_a_gnd
band_a_copper
