maximmalin/simul/hardware/enclosure/krystal-case.stl

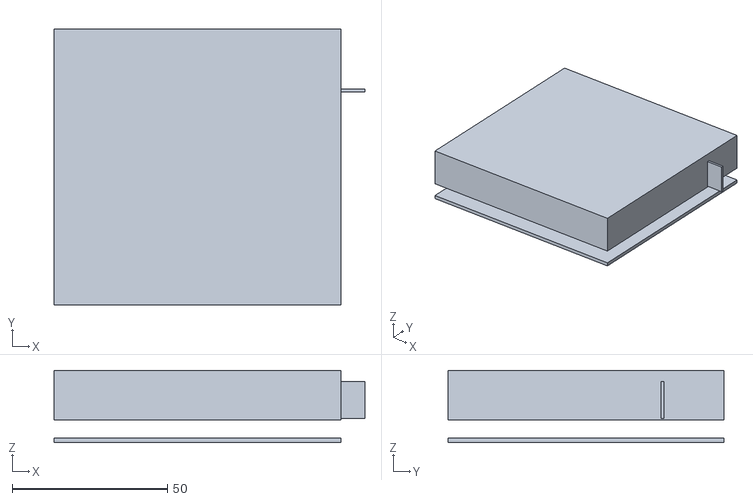
[picture p2: CAD file, 2026-10-15]
hardware/enclosure/krystal-case.stl
100.3 x 89.1 x 23.2
