maximmalin/simul/out/board.step

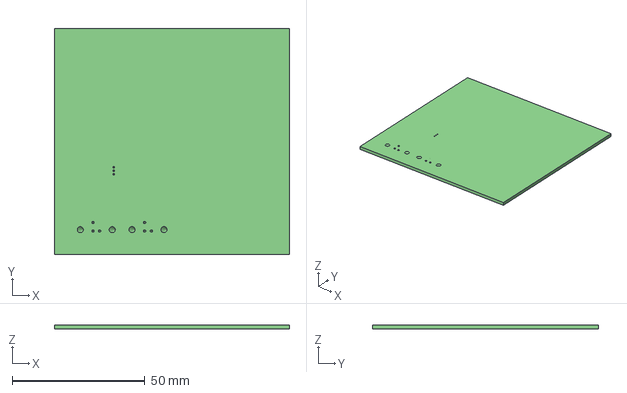
[picture p3: CAD file, 2026-10-15]
out/board.step
88.6 x 85.1 x 1.60 mm
