maximmalin/simul/hardware/antenna/geometry/band_b.step

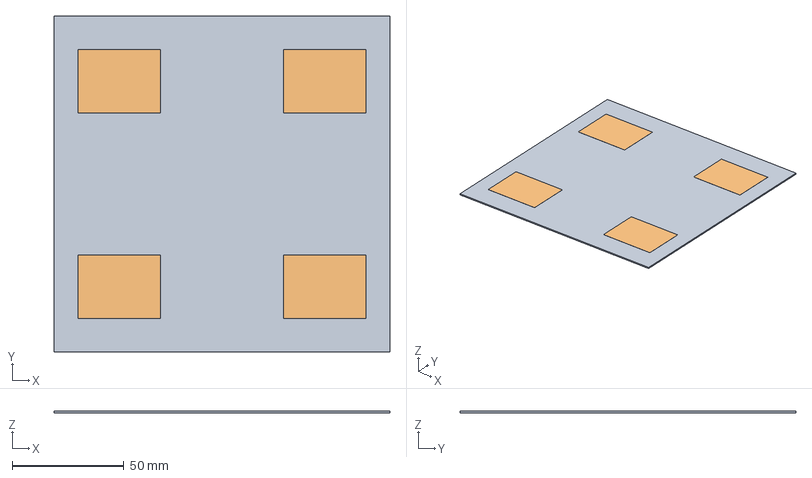
[picture p4: CAD file, 2026-10-15]
hardware/antenna/geometry/band_b.step
150.0 x 150.0 x 0.87 mm
band_b_fr4
band_b_gnd
band_b_copper
