maximmalin/simul/hardware/antenna/geometry/band_c.step

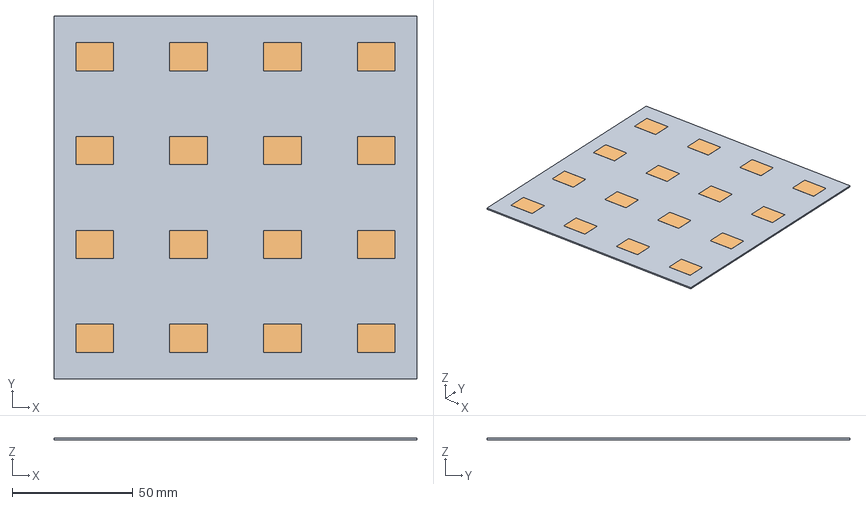
[picture p6: CAD file, 2026-10-15]
hardware/antenna/geometry/band_c.step
150.0 x 150.0 x 0.87 mm
band_c_fr4
band_c_gnd
band_c_copper
