maximmalin/simul/sim/cad/figures/band_b_projections.dxf

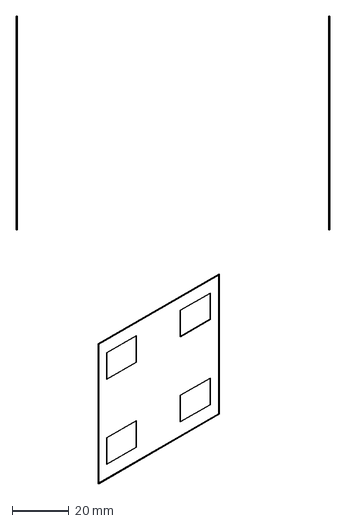
[picture p7: CAD file, 2026-10-13]
sim/cad/figures/band_b_projections.dxf
110.4 x 164.3 mm
