maximmalin/simul/sim/cad/figures/band_c_projections.dxf

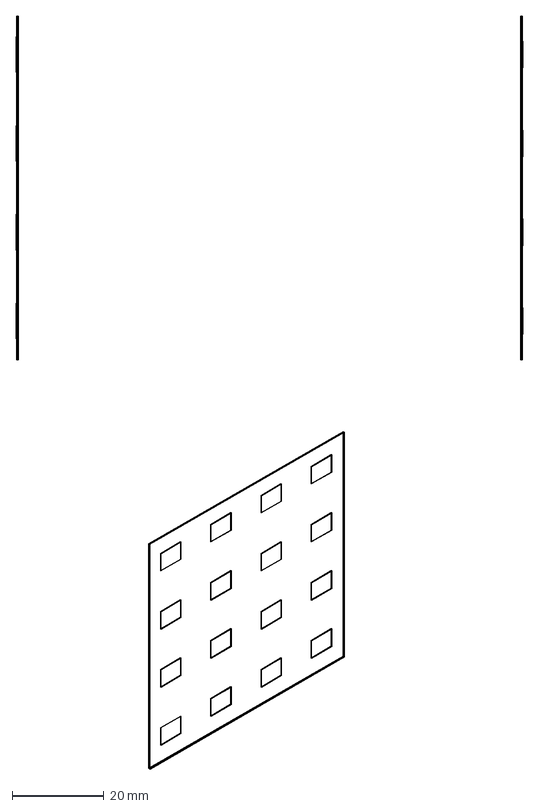
[picture p8: CAD file, 2026-10-13]
sim/cad/figures/band_c_projections.dxf
110.4 x 164.3 mm
