maximmalin/simul/(list of files, cad)

Other CAD files:
sim/cad/figures/band_c_GOST.dxf
hardware/antenna/geometry/band_a.stl
hardware/antenna/geometry/band_b.stl
hardware/antenna/geometry/band_c.stl
out/board.dxf
