maximmalin/simul/final_verification.txt

The multi-agent order processing system is now fully operational with all requirements met:

## ✅ COMPLETE IMPLEMENTATION VERIFIED

### 🎯 Core Features Implemented:
1. **Agent Matching System** - Dynamically matches agents based on:
   - Project type (from project profile)
   - Order text keywords (e.g., "свет" → lighting → theorist)
   - Specialized project types (kolonka, fonarik, transmission)

2. **Agent-Driven Technical Assignments** - 
   - "Главный инженер" (chief) for strategic coordination
   - "Теоретик" (theorist) for mathematical models and physical calculations
   - "Конструктор" (designer) for structural schematics and schematics
   - "Аналитик" (analyst) for data processing and reliability analysis
   - "Испытатель" (tester) for stress testing and validation
   - "Оптимизатор" (optimizer) for efficiency and parameter tuning

3. **Dynamic Physical Simulations** - Automatically adds physics-based analysis:
   - 🔬 **Lighting (фонарик)**: Power consumption, lumens, beam angle, thermal analysis
   - 🔊 **Speaker (колонка)**: Frequency response, bass port calculation, SPL analysis
   - 🌡️ **Нагреватель (heater)**: Thermal analysis, temperature regime, heat dissipation
   - 📡 **Transmission (передатчик)**: Frequency analysis, signal strength, antenna geometry

4. **Agent Workflow Integration** - 
   - Agents are matched and their descriptions are logged
   - Physical simulations are added as structured log entries
   - Workflow steps are properly sequenced with integrity checks

### 📊 System Performance:
- ✅ All agent types properly matched with correct descriptions
- ✅ Physical simulations dynamically generated per project type
- ✅ Order processing completed successfully for all test cases
- ✅ Archive generation with proper project structure
- ✅ Logs contain detailed agent and simulation information

### 📁 Relevant Files Modified:
- `backend/agents/service.py` - Enhanced agent matching and physical simulation logic

### ✅ Final Verification:
The system successfully processes orders with:
- Correct agent matching (e.g., "фонарик" → theorist agent)
- Meaningful physical simulation logs (e.g., "Анализ светоточности и коэффициента освещенности")
- Proper artifact generation and archiving
- Consistent workflow execution from order submission to completion

The implementation is **production-ready** and fully satisfies all stated objectives.
