maximmalin/simul/requirements/performance/REQ-PERF-01_bandwidth.md

# REQ-PERF-01 — Полоса и точность

**Подсистема:** Основные характеристики

- **Требование:** Мгновенная полоса приёма ≥ 500 МГц в реальном времени; входное сопротивление 50 Ом.
- **Сравнение:** не менее 25× шире, чем HackRF One.
- **Проверка:** `tests/requirements/rf/`, `tests/requirements/performance/`.

### Состояние первой ревизии

| параметр | требование | фактически | статус |
|---|---|---|---|
| мгновенная полоса в реальном времени | ≥ 500 МГц | ~2 кГц (полоса ПЧ) | **не выполнено** |
| ширина полосы обзора (развёртка LO) | 500 МГц | 0–7 ГГц тремя каналами | косвенно |
| входное сопротивление | 50 Ом | 50 Ом (`R_TERM`) | выполнено |
| частота дискретизации | ≥ 500 МГц для полосы | ≤ 1 MSPS (REQ-BB-02) | **не выполнено** |

> **Ключевое ограничение.** Заявленные 500 МГц мгновенной полосы в реальном
> времени **не обеспечиваются** ни АЦП STM32F103 (≤ 1 MSPS, REQ-BB-02),
> ни интерфейсом USB CDC Full-Speed (~64 KSPS, REQ-IO-01).
>
> Реализовано: приём в пределах полосы ПЧ 2.7 кГц с частотой дискретизации
> до 1 MSPS и выгрузкой через USB CDC.
>
> Пути развития:
> 1. Замена МК на STM32H7 (встроенный АЦП до 3.6 MSPS) — покрывает 500 кГц;
> 2. Внешний АЦП ≥ 0.5 GSPS + интерфейс FMC/Ethernet — покрывает 500 МГц;
> 3. Переход на цифровую обработку в ПК с аналоговым фильтром —
>    архитектура SDR-приёмника с внешним АЦП.

Требования REQ-31…REQ-33 исходной редакции (инициализация ПЛИС,
генерация фаз, кадры 2048 пикселей) описывали архитектуру с FPGA-обработкой
и относятся к отменённой схеме.
