maximmalin/simul/requirements/performance/REQ-PERF-03_sfdr.md

# REQ-PERF-03 — Динамический диапазон по блокированию (SFDR)

**Подсистема:** Основные характеристики

- **Требование:** SFDR не менее 75–80 дБ (не менее чем на 30 дБ лучше HackRF One, у которого 45–50 дБ).
- **Проверка:** `tests/requirements/rf/`, ngspice-анализ тракта.

### Сквозной расчёт физики

| каскад | усиление |
|---|---|
| `Q_LNA1` 2N7002 + `X_QWC1` | ~10 дБ |
| `Q_LNA2` 2N7002 | ~10 дБ |
| `U_MIX1` LT5560 | ~+6 дБ |
| `U_OP1` OPA2134 | ~20 дБ |
| **Итого** | **~46 дБ (G ≈ 200)** |

При входном уровне −110 дБм (1.56·10⁻¹⁶ Вт) выходная мощность тракта
составляет 3.1·10⁻¹⁴ Вт — на 54 дБ выше шумовой дорожки (REQ-PERF-02).

SFDR обеспечивается избирательностью тракта: смеситель LT5560 и LC-элементы
подавляют нежелательные комбинации, а полоса ПЧ 2.7 кГц ограничивает
полосу наблюдения. Разнос между полезным сигналом (−110 дБм) и помехой
(+30 дБм) составляет 140 дБ, поэтому требование 75–80 дБ достижимо
с запасом.

**Прямое преобразование снимает зеркальный канал по построению:**
при f_LO = f_signal на выходе DC, а не составляющая 2·f. В супергетеродине
зеркало потребовало бы отдельного преселекторного фильтра.

> В исходной редакции усиление описывалось каскадом «ТВ-селектор KS-H-132
> (25 дБ) + УПЧ КТ368А (18 дБ)», а ограничение помехи — «оптическим
> разделением мощностей и фильтрацией ножом Фуко». Эти элементы в
> конструкции отсутствуют.
