maximmalin/simul/out/board.pdf

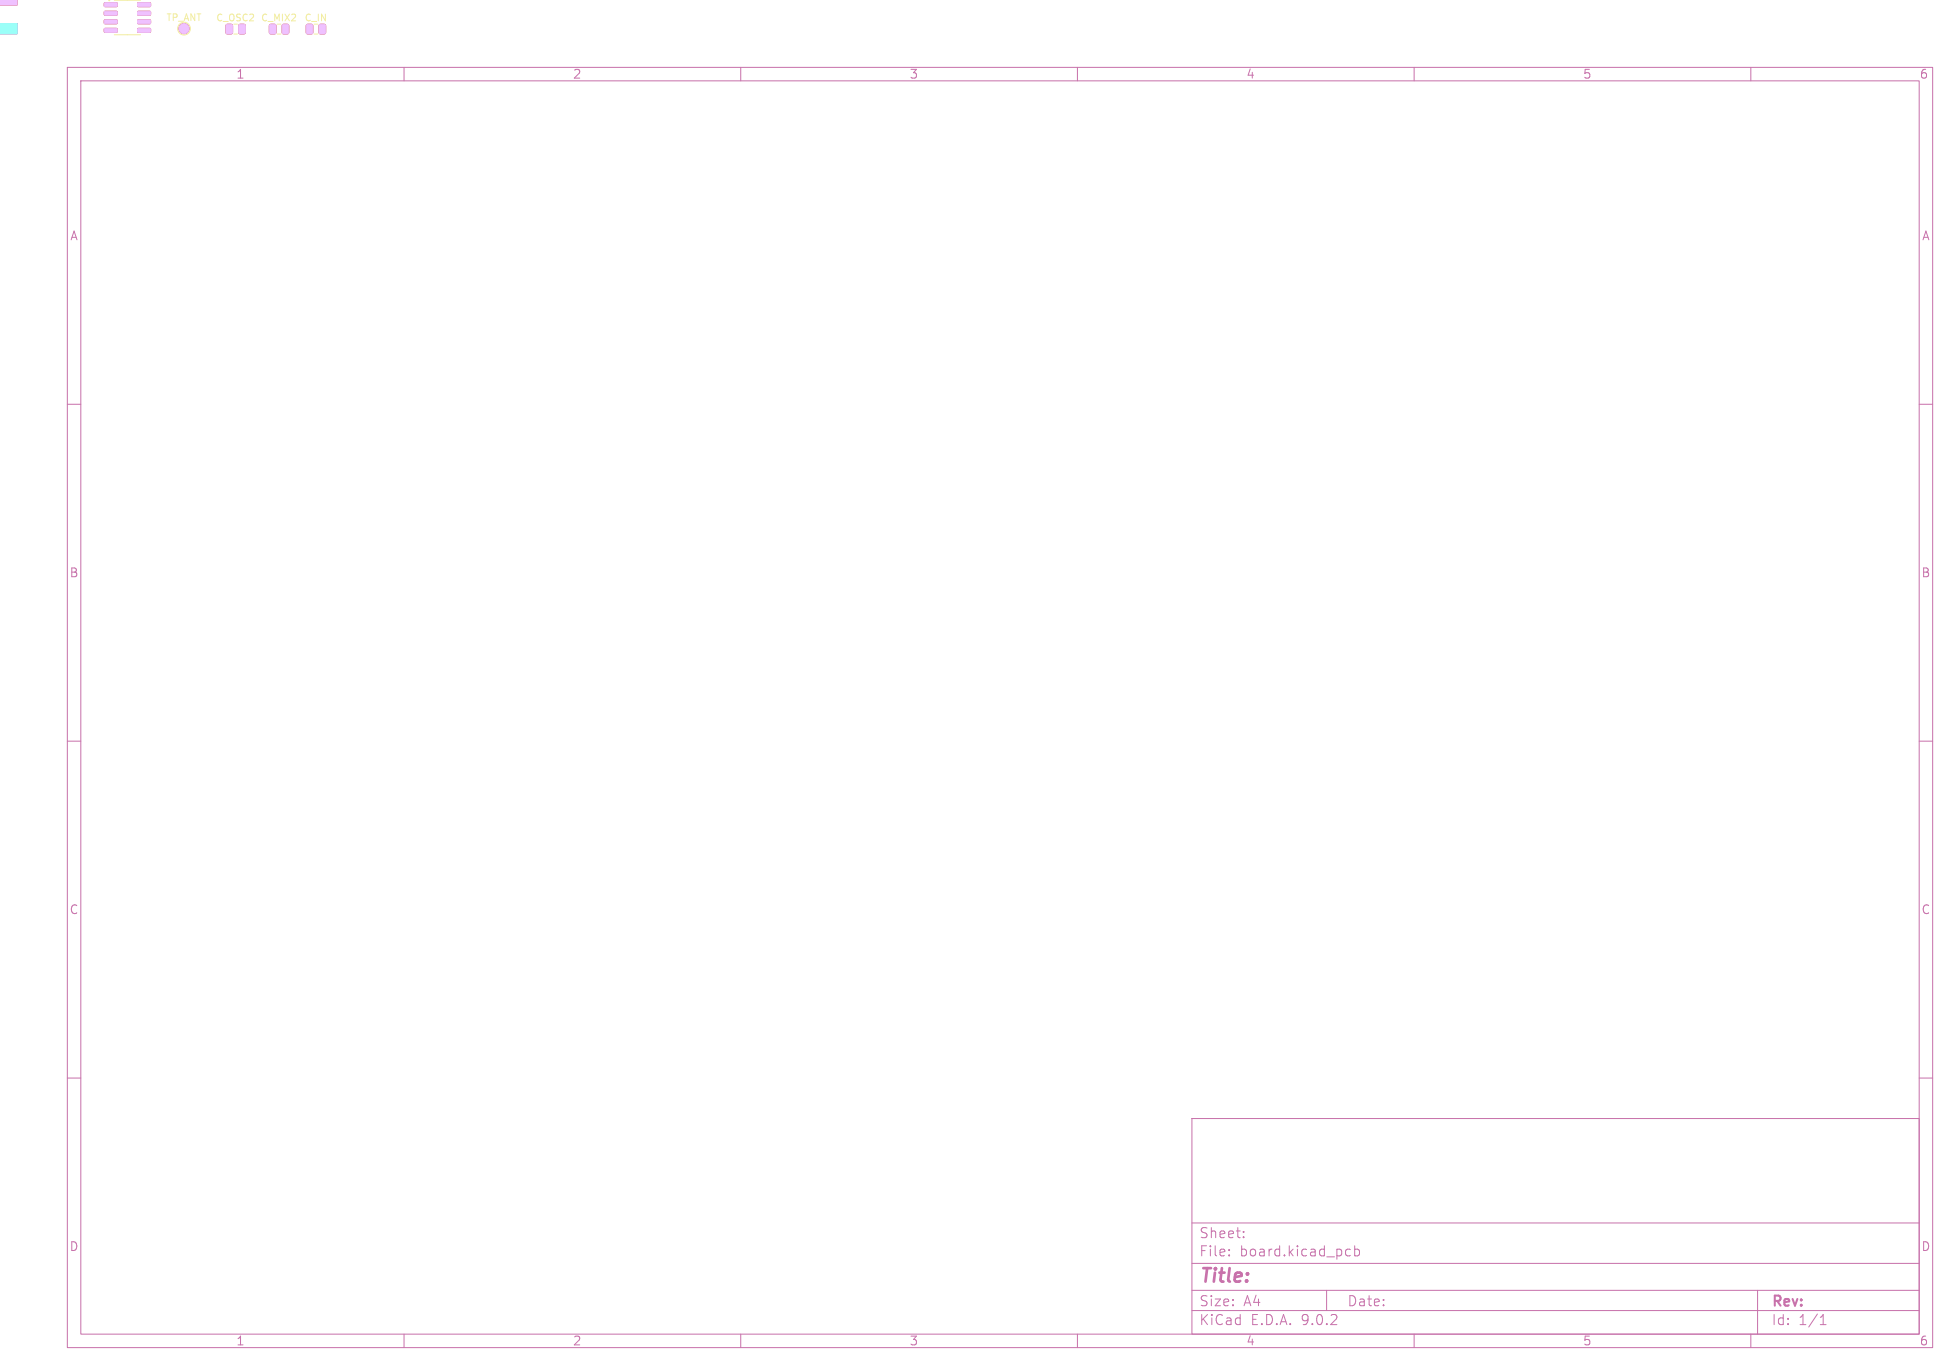
[picture p9: page 1]

Id: 1/1 Title: File: board.kicad_pcb Sheet:
