maximmalin/simul/sim/cad/figures/band_a_GOST.pdf

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

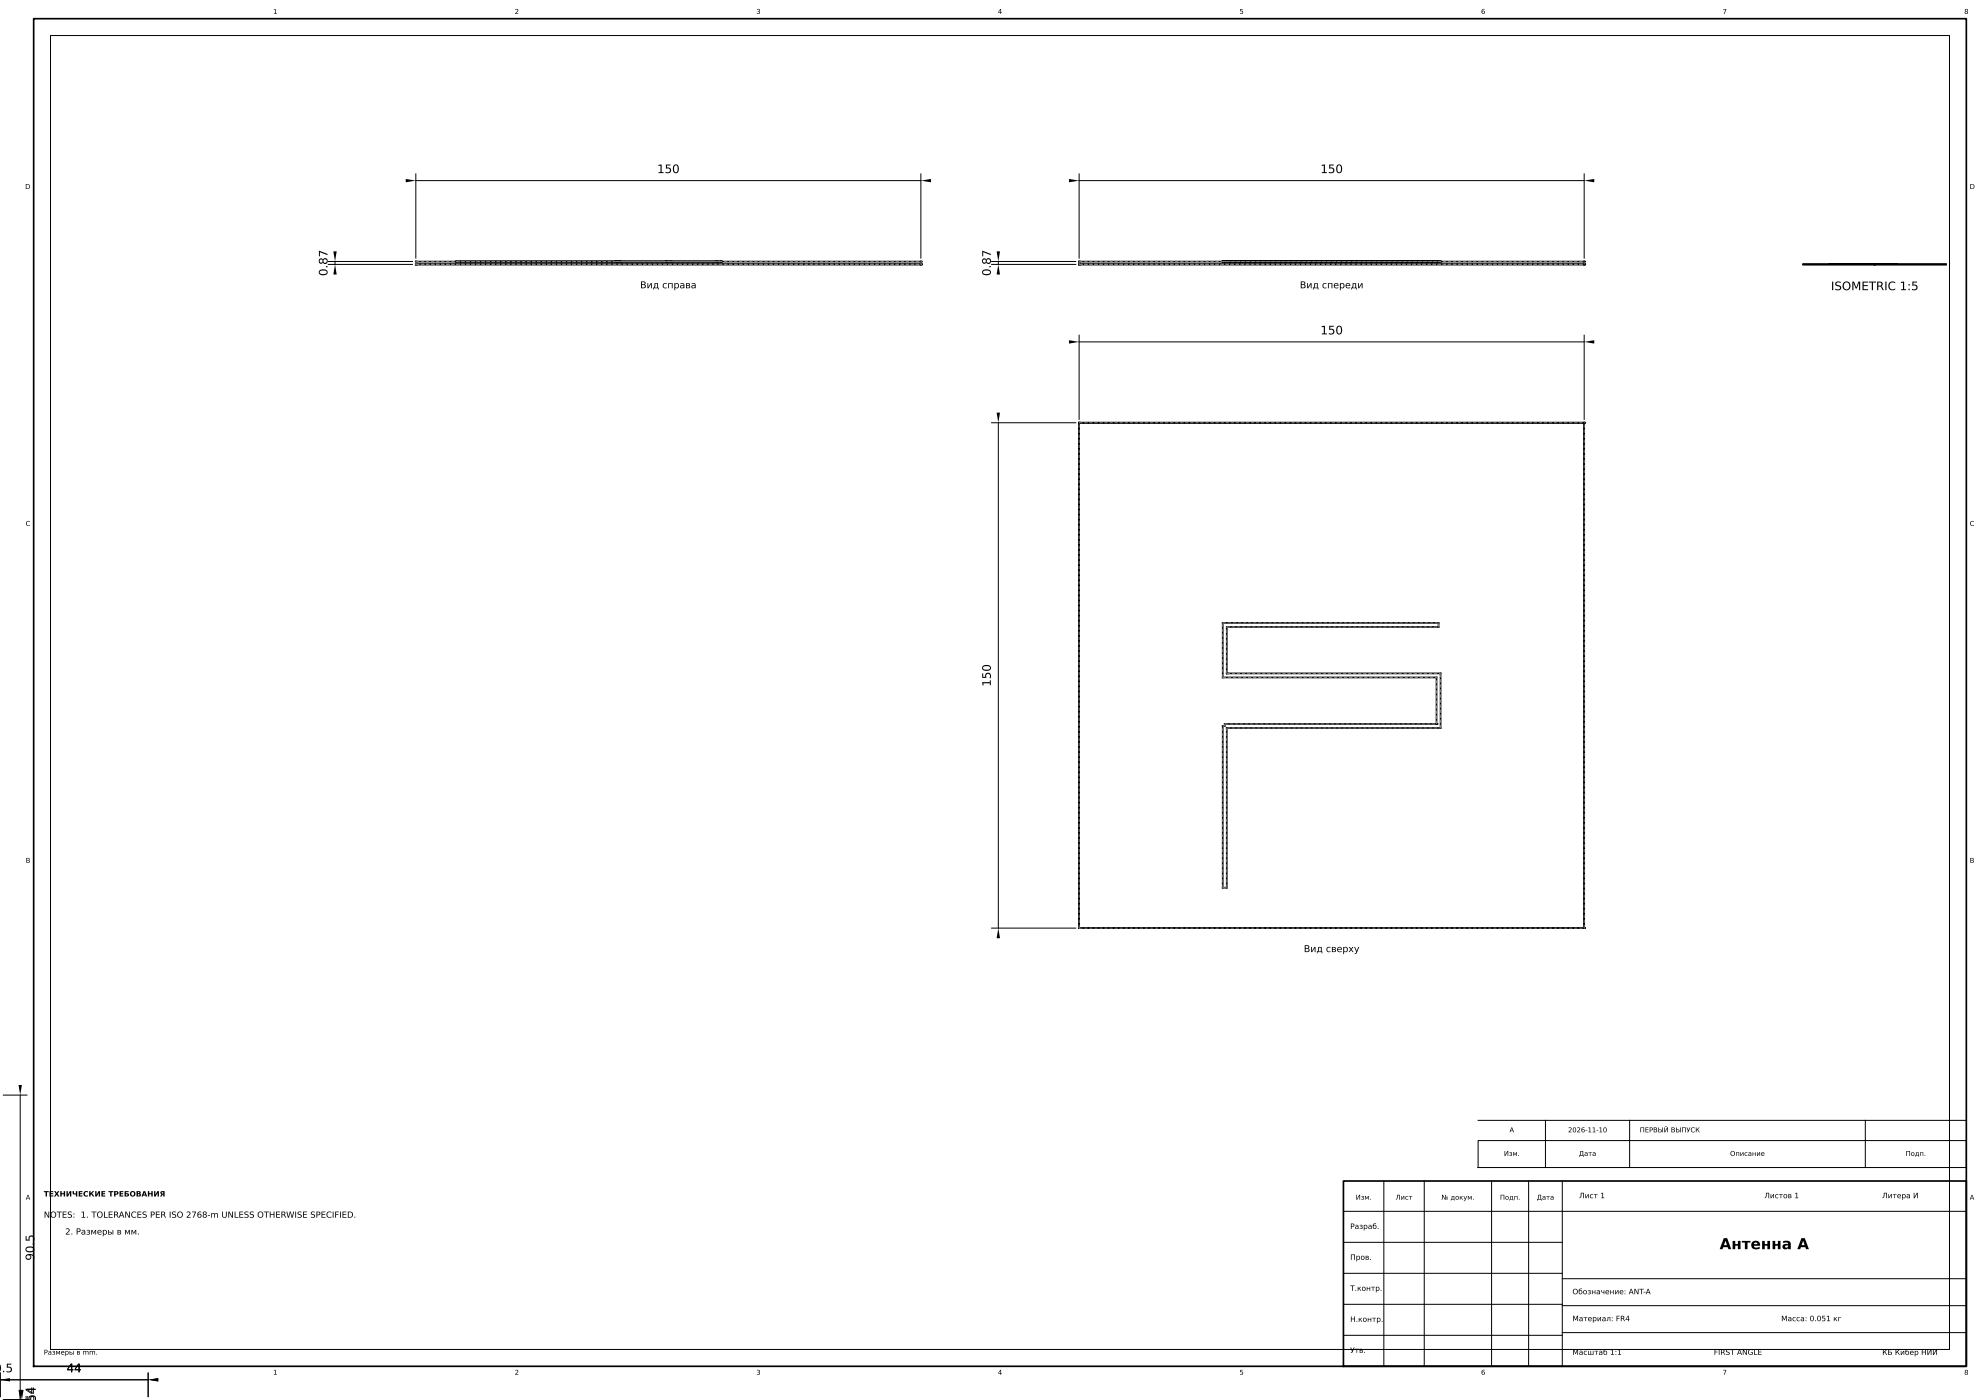
[picture p10: page 1]
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
