maximmalin/simul/work/ngspice/system/brig_receiver.cir

.title KiCad schematic
R1 /GATE_BIAS /_NO_NET_ 1k
PD3 __PD3
TP2 __TP2
PD4 __PD4
C6 +5V_ANA GND 100n
C7 +5V_ANA GND 33p
R10 /BOOT0 +3V3_DIG 10k
R11 /BOOT0 GND 10k
C11 VBIAS GND 100n
TP9 __TP9
C5 /V5_PRE GND 470u
TP8 __TP8
U1B __U1B
Q1 __Q1
C8 /MIX1_IF /IF_38M 10p
TP1 __TP1
X1 __X1
X2 __X2
U2 __U2
J4 __J4
U7 __U7
J3 __J3
TP3 __TP3
TP4 __TP4
FB1 __FB1
TP7 __TP7
TP6 __TP6
TP5 __TP5
D5 __D5
D4 __D4
A1 __A1
R2 /LD_DRIVE /LASER_A 2.2
LS1 GND /LASER_A LD-14
U4 __U4
A2 __A2
A3 __A3
U5 __U5
C12 +3V3_DIG GND 1000u
R5 /TIA_OUT /PDT_I 50k
U8 __U8
J1 __J1
J2 __J2
F1 __F1
C13 +3V3_DIG GND 100n
D3 __D3
R6 /TIA_OUT /SUB_IN 10k
R7 /ADC_IN /SUB_IN 10k
D2 __D2
D1 __D1
M1B __M1B
B1 __B1
T1 __T1
U6 __U6
M2 __M2
PD2 __PD2
M1 __M1
PD1 __PD1
C10 /ADC_IN GND 100n
R9 VBIAS GND 10k
LED1 GND /_NO_NET_ WIFI_LED
C4 /U1_COMP GND 22n
R13 /LED_AN GND 680
C3 /U1_SS GND 10n
R12 /BOOT GND 10k
C2 +3V3_DIG GND 470u
R8 +5V_ANA VBIAS 10k
C9 /TIA_OUT GND 10p
ANT2 __ANT2
U1 __U1
L1 /SW_BUCK +3V3_DIG 18u
C1 /VIN_PROT GND 220u
C14 +3V3_DIG GND 10n
C15 /EN_RC GND 1u
.end
