maximmalin/simul/out/board.kicad_pcb

## KiCad design out/board.kicad_pcb (2026-10-13)

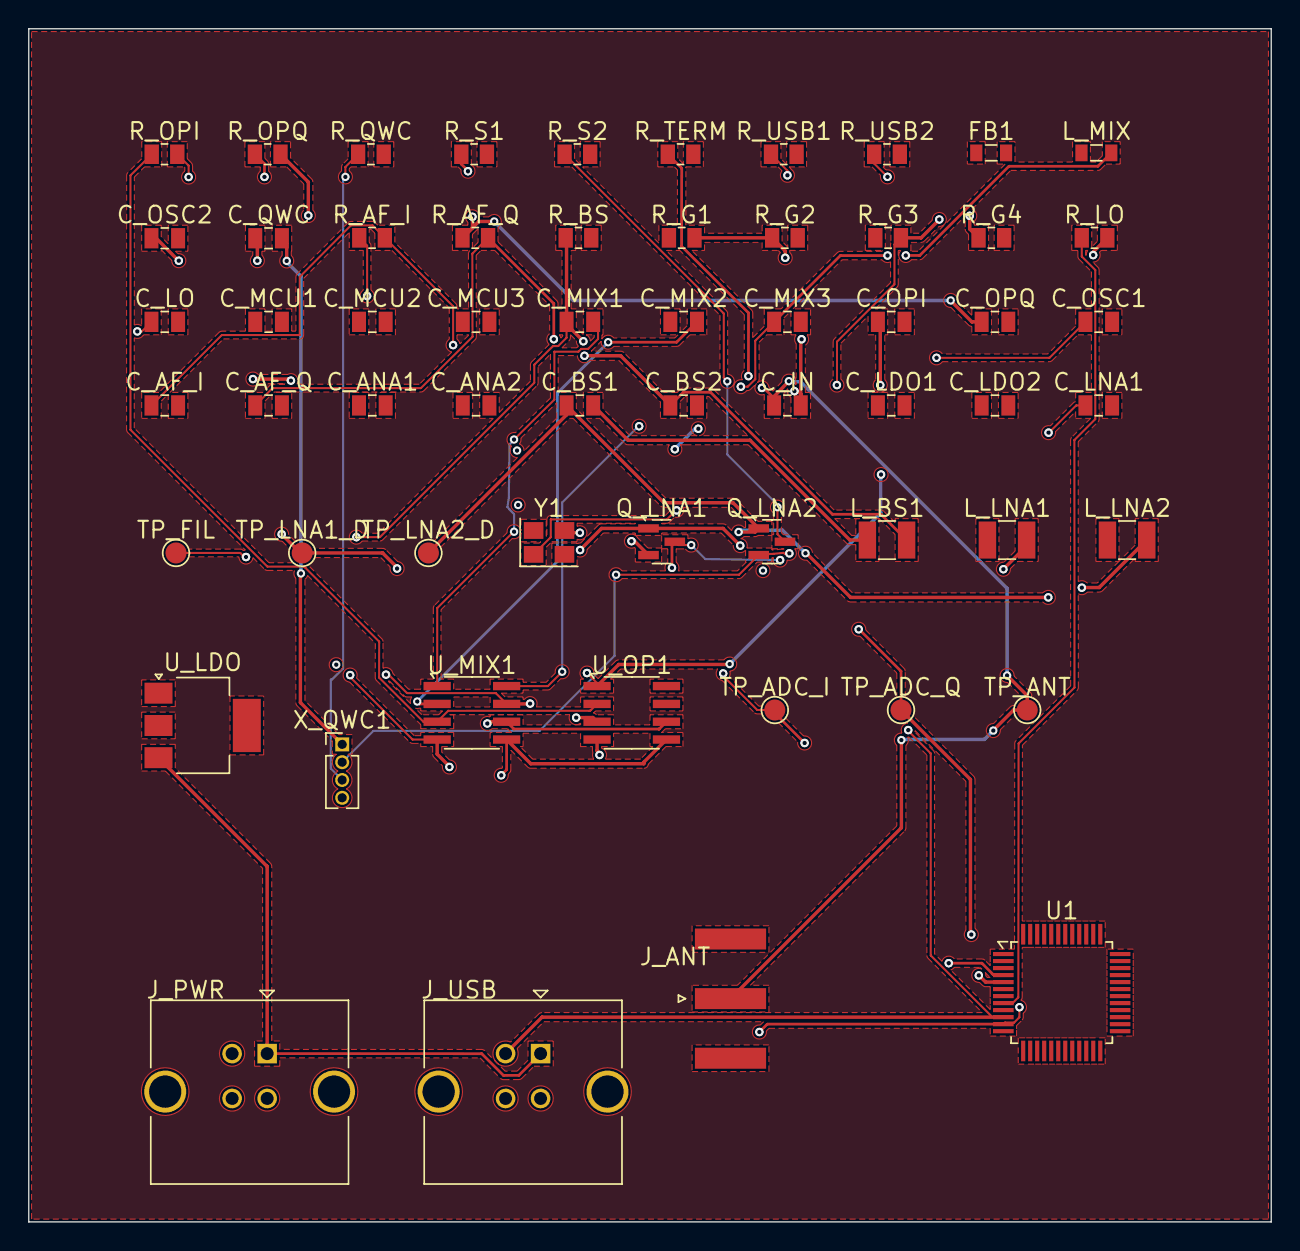
[picture p13: board board.kicad_pcb from above]

Board: 4 copper layers, 88.6 x 85.1 mm, 60 parts (0 on the bottom side), 29 nets.

Parts:
C_AF_I: 100p
C_AF_Q: 100p
C_ANA1: 10u
C_ANA2: 100n
C_BS1: 100p
C_BS2: 10p
C_IN: 100p
C_LDO1: 100u
C_LDO2: 100n
C_LNA1: 100p
C_LO: 100p
C_MCU1, C_MCU2: 100n
C_MCU3: 4u7
C_MIX1, C_MIX2: 100p
C_MIX3: 100n
C_OPI: 100p
C_OPQ: 100p
C_OSC1, C_OSC2: 22p
C_QWC: 100p
FB1: 600R@100MHz; 600R_100MHz
J_ANT: SMA_EDGE
J_PWR: 5V_IN
J_USB: USB_CDC
L_BS1: 100u
L_LNA1, L_LNA2: 18u
L_MIX: 600R@100MHz; 600R_100MHz
Q_LNA1, Q_LNA2: 2N7002
R_AF_I: 10k
R_AF_Q: 10k
R_BS: 1k
R_G1, R_G2: 10k
R_G3: 4k7
R_G4: 2k2
R_LO: 50
R_OPI: 10k
R_OPQ: 10k
R_QWC: 1k
R_S1, R_S2: 1k
R_TERM: 50
R_USB1, R_USB2: 22
TP_ADC_I: TESTPOINT
TP_ADC_Q: TESTPOINT
TP_ANT: TESTPOINT
TP_FIL: TESTPOINT
TP_LNA1_D, TP_LNA2_D: TESTPOINT
U1: STM32F103C8T6
U_LDO: AMS1117-3.3; AMS1117-3_3
U_MIX1: LT5560
U_OP1: OPA2134
X_QWC1: LPJ-1
Y1: 8MHz

Connections:
ADC_I: C_OPI.1, R_AF_I.1, U_OP1.1
ADC_I_F: C_AF_I.1, R_AF_I.2, TP_ADC_I.1, U1.4
ADC_Q: C_OPQ.1, R_AF_Q.1, U_OP1.4
ADC_Q_F: C_AF_Q.1, R_AF_Q.2, TP_ADC_Q.1, U1.5
FIL_IN: C_BS1.2, L_BS1.1
FIL_OUT: C_BS2.1, C_MIX1.1, L_BS1.2, R_BS.1, TP_FIL.1
LNA1_D: C_QWC.1, L_LNA1.2, Q_LNA1.1, TP_LNA1_D.1
LNA1_G: C_IN.2, Q_LNA1.2, R_G1.2, R_G2.1
LNA1_S: C_LNA1.1, Q_LNA1.3, R_S1.1
LNA2_D: C_BS1.1, L_LNA2.2, Q_LNA2.1, TP_LNA2_D.1
LNA2_G: Q_LNA2.2, R_G3.2, R_G4.1, X_QWC1.2
LNA2_S: Q_LNA2.3, R_S2.1
LO: C_LO.1, R_LO.2, U_MIX1.7
LO_SRC: R_LO.1, U1.8
MIX_I1: R_OPI.1, U_MIX1.3, U_OP1.2
MIX_I2: R_OPI.2, U_MIX1.4, U_OP1.3
MIX_IN_N: C_MIX2.2, U_MIX1.2
MIX_IN_P: C_MIX1.2, U_MIX1.1
MIX_Q1: R_OPQ.1, U_MIX1.5, U_OP1.5
MIX_Q2: R_OPQ.2, U_MIX1.6, U_OP1.6
OSC_IN: C_OSC1.1, Y1.1
OSC_OUT: C_OSC2.1, Y1.3
QWC_CP: R_QWC.1, X_QWC1.3
QWC_IN: C_QWC.2, X_QWC1.1
RF_IN: C_IN.1, J_ANT.1, R_TERM.1, TP_ANT.1
USB_DP: J_USB.2, R_USB1.1, U1.10
USB_D_: J_USB.3, R_USB2.1, U1.11
VCC_MIX: C_MIX3.1, L_MIX.2, U_MIX1.8
VIN_5V: J_PWR.1, J_USB.1, U_LDO.3
