maximmalin/simul/(commit log)

2026-10-08 Restored deleted pipeline files: spec.py, kicad_lib.py, pipeline.py, make_viewer.py
2026-10-08 Complete SDR receiver project: restored all pipeline files and generated outputs
    [bom.csv, pnp.csv]
2026-10-09 Add working ngspice co-sim scaffolding; drop node_modules and placeholder artifacts
    Real, tested:
    - src/picsimlab_fmu/ - PicSimLab <-> ngspice co-sim bridge (copied from
    brig-receiver, unmodified; its 6-test suite passes)
    - sim/netlists/{sdr_simplified,sdr_receiver}.cir - ngspice netlists, both
    verified to parse and run; VMGN shorted-source bug fixed
    - sim/scripts/test_ngspice_nets.py - smoke test, both netlists pass
    (t_stop=1e-5s, 2/3 nodes carrying signal)
    - sim/scripts/sdr_picsimlab_cosim.py - lockstep cosim driver; netlist path bug fixed
    - sim/scripts/{export_ngspice,antenna_sim-derived}.py - FDTD -> Touchstone -> ngspice
    xfer pipeline for reusable antenna models
    - firmware/ - ST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
    [bom.csv]
2026-10-09 Antenna FDTD framework + SKiDL netlist + impedance-matched ngspice bridges
    Mesh sizing (sim/scripts/mesh.py, 7 self-tests pass)
    Sizing the mesh from the thinnest feature made a 7 MHz dipole try to
    allocate 27 GB (0.2 mm cells in a 60 mm box). Two rules replace it:
    cell = min(2*air/cells_across_box, lambda/max_cells_per_lambda)
    air = max(air_mm, structure_half_extent + clearance, lambda/10)
    The second was missing entirely: a 20 m dipole in an 8 m box is silently
    truncated. A cell-count budget check now refuses over-large models before
    allocation instead of OOM-killing the machine.
    Antenna models (sim/scripts/antenna_fdtd.py + sim/inputs/*.yaml)
    YAML-driven: adding an ant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
    [antenna_dipole_7mhz.yaml, antenna_fdtd.py, antenna_meander_200mhz.yaml, antenna_patch_2450mhz.yaml, export_antenna_ngspice.py, export_ngspice.py, mesh.py, sdr_skidl_circuit.py]
2026-10-09 Firmware builds; FMU instantiates; patch FDTD completes
    Firmware (firmware/src/firmware.ino) -- now actually compiles
    `platformio run` produced firmware.bin (23 KB) and firmware.elf (54 KB).
    The blocker was not permissions after all: the ARM toolchain was already
    installed but its .piopm metadata file had been truncated to 0 bytes during
    an earlier cleanup, so PlatformIO could not read it. Deleting it let
    PlatformIO re-register the toolchain and pull the STM32 framework.
    Firmware rewritten against the F103 (the previous version was F4-shaped and
    had never compiled): ADC1 not ADC, shared DMA_CCR_* macros rather than
    DMA_CCR1_*, and PA6 configured as AF push-pull by writing CR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
2026-10-09 Fix Prad efficiency; wire impedance-matched bridges; make chain complete
    Prad / radiation efficiency (the number reported as 0.997)
    Was dividing peak(p_acc) by peak(p_acc) -- Prad was never computed, so the
    ratio was 1.0 by construction. Now takes both quantities from openEMS so they
    share a normalisation: port.P_acc for accepted power, and
    nf2ff.CalcNF2FF(...).Prad[0] for radiated power. Falls back to the configured
    value and labels the source "unavailable_fell_back_to_1.0" if NF2FF fails,
    rather than silently reporting unity.
    Added `--repost`, which rebuilds the geometry and re-runs only CalcPort /
    CalcNF2FF against existing sim/work data. A post-processing fix otherwise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
    [antenna_fdtd.py, export_ngspice.py, sdr_skidl_circuit.py, test_sdr_netlist.py]
2026-10-10 Host-drivable pin boundary; firmware hex; patch geometry derived not guessed
    Co-simulation boundary: dac_bridge cannot be used for digital -> analog
    I had wired the netlist with ngspice's dac_bridge on the MCU outputs. That is
    wrong for a host-driven co-simulation: its input is an event-driven digital
    node, and the host cannot write it -- `alter LO_SRC = 3.3` fails with "no such
    device or model name lo_src". Verified directly rather than assumed.
    The boundary is now split by what each direction actually needs:
    analog -> digital : adc_bridge, which does thresholding properly and whose
    digital output the host reads
    digital -> analog : an explicit pin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
    [antenna_patch_2450mhz.yaml, export_ngspice.py, firmware.ino, sdr_picsimlab_cosim.py, test_sdr_netlist.py]
2026-10-10 Record verified STM32 execution and the rcontrol blocker
    Investigated whether PicSimLab and ngspice can be run simultaneously here.
    The MCU half turns out to work; the remote-control half does not.
    STM32 firmware really does execute
    PicSimLab 0.9.2 is installed and was verified running the Blue Pill. Its log
    shows qemu-stm32 executing the firmware: register dump, PC = 0x08004068,
    "reset is called!". So the STM32 side is a live simulation, not a stub.
    rcontrol does not respond, and it is not our protocol
    The socket accepts connections but the server sends nothing: confirmed with
    \n, \r\n and a bare command, over both nc and raw sockets, with a 12 s read
    timeout -- zero bytes bac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
2026-10-10 Record rcontrol root cause: worker thread never drains its queue
    The socket state is the decisive evidence, not the missing reply:
    CLOSE-WAIT with Recv-Q 120 means the server received the command and never
    processed it. The listen backlog also fills to 6 within 40s of a fresh start
    and stays there, so the rcontrol worker thread is not draining its queue. Since
    v0.8.8 upstream runs rcontrol in a separate thread, that thread is not running
    in this build.
    Also corrects an earlier misreading: one test did return Ok for version, before
    repeated probing filled the backlog. Sending 'quit' permanently exits the
    rcontrol interface, so raw-socket probing can kill the responder -- use
    PicSimLabFMU ins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
2026-10-10 Make the receiver actually convert, and model the STM32 pin from datasheet
    The analog chain simulated without converting anything. Five defects, each
    concealed by a check that passed anyway:
    1. The Q channel was wired to zero. B_U_MIX1_Q ended in "* 0", so the
    quadrature output was identically 0 V while still converging and still
    parsing. The LT5560's internal 90 deg phase shifter is now a real all-pass,
    H = 1 - 2/(1+sRC), with RC = 1/(2*pi*f_LO).
    2. There was no LO. V_MCU_LO was a DC source, so the mixer multiplied the RF by
    a constant -- that is not mixing. PA6 is a TIM3_CH1 output and now carries a
    real square wave with finite edges, gated by the host-alterable pin state.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
2026-10-10 Fix patch bandwidth reporting and show the real impedance
    The 2.45 GHz FDTD finished, so the numbers are real now:
    f_res 2442.5 MHz, eta_rad 30.8% from Prad/Pacc, S11 -3.56 dB.
    Three reporting defects, each of which made the result read as something it
    was not:
    1. Bandwidth was computed against a hardcoded -10 dB threshold. The patch
    peaked at -3.56 dB, so it never qualified and BW came out exactly 0.0 Hz --
    a statement about the threshold, not the antenna. Now -3 dB relative to the
    minimum actually achieved, which is the conventional definition, with the
    threshold configurable. Real result: 171 MHz, not truncated by the sweep.
    Added a BW_truncated flag, because a band that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
    [antenna_fdtd.py]
2026-10-10 Find a working NOGUI PicSimLab; the real blocker is rcontrol vs qemu
    The copies on this machine named PICSimLab_NOGUI were 0 bytes. Real builds are
    on GitHub, so I fetched 0.9.3 and 0.9.2 (16.6 MB / 21.8 MB) to
    /mnt/ext4data/downloads.
    You were right that the binary was the wrong path, and in two separate ways.
    NOGUI fixes rcontrol outright. The GUI listens but its responder never services
    anything; NOGUI answers immediately, with the responder's own Ok and prompt:
    version -> '... Version: 0.9.3 ... NOGUI Appimage\r\nOk\r\n>'
    It also listens with an empty accept backlog where the GUI's fills to 6-9 and
    sits there. So the earlier diagnosis in this file -- a worker thread that never
    dr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
    [sdr_picsimlab_cosim.py, start_picsimlab.py]
2026-10-10 Pin the co-simulation blocker precisely: rcontrol never binds under qemu
    Checked brig-receiver, as suggested, and it does not contain a working path --
    but it is worth recording why, because it looks like one.
    PICSIMLAB_MCU_INTERFACE.md and picsimlab_rt_wrapper.py describe rcontrol over a
    virtual serial port (/dev/tnt2, 921600 baud) with a different protocol:
    "M <pin> OUTPUT", "D <pin>", "A <pin>", answered "DS:<pin> <state>" and
    "AD:<pin> <value>".
    That protocol does not exist in PicSimLab. Against both binaries: "DS:" has no
    hits beyond substrings of simavr's "CMDS:", "AD:" has none, "921600" has none.
    The real interface is the text protocol -- version, pinsl, sim, loadhex -- and
    it is T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
2026-10-10 Correct two wrong conclusions: the port, and the NOGUI bridge attempt
    Two things I got wrong, both worth correcting because they change the advice.
    The port. The local config uses picsimlab_remotecp = 5002, not the upstream
    default 5000. Most of the probing this session was against 5000, so "the
    listener never opens" was often just the wrong door -- the interface was up and
    answering on 5002 the whole time. sim/scripts/rcontrol.py now reads the port from
    the config instead of assuming it.
    The 0.9.3 + borrowed-library idea. Checked rather than assumed: the 0.9.2
    libqemu-stm32.so needs 293 symbols the 0.9.3 binary does not provide, of which
    260 are glib, 21 pixman and 12 zlib. All three exis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
    [rcontrol.py, rcontrol_session.py]
2026-10-10 Working FMU co-simulation with ngspice, without PicSimLab
    The FMU path is the one that does not depend on the broken rcontrol, so this
    makes the co-simulation real rather than waiting on upstream.
    build_fmu.py regenerates the netlist from SKiDL and splices it into the FMU
    source before building, so sim/fmu/SdrNgspiceFMU.fmu and
    sim/netlists/sdr_skidl_ngspice.cir are the same circuit by construction. The FMU
    used to carry a hand-written deck that had drifted: it still had the Q channel
    scaled by 0.7 instead of shifted in phase, a static LO phasor instead of a timer
    waveform, and no mid-rail bias on the ADC input -- every defect fixed in
    export_ngspice.py. Anything embedded by hand drifts aga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
    [build_fmu.py, cosim_fmu_stm32.py, sdr_ngspice_fmu.py, test_fmu_cosim.py]
2026-10-10 Fix: the I channel was never broken, the test was reading the wrong field
    simulate_fmu returns a structured array with named fields -- time, adc_i,
    adc_q, model_status -- and the test was indexing it positionally:
    vals = [float(sig[1]) for sig in res]
    sig[1] on a numpy.void is adc_i for the first row and nothing meaningful after
    that, so "adc_i = 0.0" was the time column and "adc_q = 3.2352" was adc_i. The
    FMU was correct throughout; the test was reporting time as a dead channel.
    Read by name instead, and take the peak over every sample:
    res["adc_i"].max(), res["adc_q"].max()
    With that fixed, both channels are present and correct:
    PA6 low -> I 1.6500 V, Q 1.6500 V (mid-r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
    [cosim_fmu_stm32.py, test_fmu_cosim.py]
2026-10-10 Make the co-simulation actually run, with real pulses across the boundary
    The FMI 2.0 slave path was never broken. fmpy's FMU2Slave.doStep() returns None
    on success and raises on a bad status, so `ok = slave.doStep(...)` was None and
    the `if not ok` treated every successful step as a failure. Dropping the
    truthiness test is what made this work.
    Also fixed the clock mismatch that made the exchange look static. The FMU
    re-simulated a fixed 20 us window on every doStep regardless of the master's
    communication step, so the analog side advanced 20 us while the MCU advanced
    whatever the master asked for. The window now follows the step size, clamped to
    50 us. With a 20 us step and a 7.2 MHz LO, 2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
    [cosim_fmu_stm32.py, sdr_ngspice_fmu.py]
2026-10-10 Run the real firmware on qemu-system-arm; fix two setup() blockers
    Installed qemu-system-arm and gdb-multiarch. netduinoplus2 is an STM32F103 with
    the Blue Pill's memory map, so firmware.elf loads unmodified -- verified by the
    vector table (SP 0x20005000, reset vector 0x0800503d in flash) and by a .bss word
    changing between samples.
    Memory is exchanged over qemu's GDB stub through sim/scripts/gdb_remote.py, the
    remote serial protocol implemented directly so no gdb binary is needed at run
    time. The human monitor cannot do this: HMP reads memory with xp but has no
    write command, and wp answers "unknown command: 'wp'". Two framing details cost
    time and are now handled: QEMU prefixes every repl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
    [build_cosim_firmware.py, build_fmu.py, cosim.h, cosim_real_stm32.py, diag_mailbox.py, diag_pc.py, firmware.ino, gdb_remote.py]
2026-10-10 Bypass the Arduino pin layer under co-simulation; add PC diagnostics
    The firmware's setup() faults into the core's Infinite_Loop under
    qemu-system-arm. The stack at the fault names the caller, so this is diagnosed
    rather than guessed:
    PC = 0x08000fe0 -> Infinite_Loop (Default_Handler, all IRQ weak aliases)
    [SP+0x18] 0x08000dfa setup
    [SP+0x14] 0x08000f8f main
    The only remaining calls into the core from setup() were pinMode() and
    digitalWrite(), which route through pin_function(). Under COSIM_MODE those are
    now direct register writes on GPIOA->CRL/BRR, matching what lo_init(),
    adc_configure() and adc_start_dma() already did. The co-simulation image drops
    from 30.5 KB to 23.4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
2026-10-10 fix: STM32F103C8T6 SDR receiver co-simulation working - PICSimLab NOGUI 0.9.2 + analog rcontrol + verified FMU co-simulation
    [cosim_real_stm32.py, diag_infinite.py, diag_literal.py, diag_regs.py, diag_watch.py, firmware.ino, rcontrol_analog.py]
2026-10-13 docs: verify README; add project docs, tooling, and assets
    README:
    - correct firmware artifact size (cosim ELF ~23 KB, bin ~4.6 KB)
    - correct venv package list (flask/pytest are not in .venv)
    - state antenna provenance: dipole/meander are analytic estimates,
    only the patch is a real FDTD result
    - correct requirement count (35 + header) and sim/cad description
    Also track the remaining project material that existed only in the
    working tree: AGENT_MAP and manifest, requirements/plan/TZ, tests and CI
    workflows, the FEM/antenna/hardware toolchain, Bragg toolbox, and the
    web GUI. Fix the PicSimLab example's rcontrol port (5000 -> 5002).
2026-10-13 antennas: run all three in real openEMS FDTD; document + transfer
    Make dipole and meander real FDTD (the patch already was) and report the
    honest full-wave results instead of optimistic analytic estimates.
    antenna_fdtd.py:
    - rewrite build_meander to the actual Channel-A panel: 150x150 mm FR-4
    (0.8 mm) over a full bottom ground, three arms of 63.5 mm at 15 mm pitch,
    fed at the bottom edge - matches hardware/antenna/geometry/build_brig_antennas_fc.py
    - fix dipole unit bug (hw/z/gap/feed_pos were scaled by 1e-3, already in metres)
    - report eta=0% (unavailable_no_radiated_power) instead of a misleading 1.0
    when the NF2FF box yields no net radiated power
    sim/inputs:
    - dipole_7mhz.yaml: fd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
2026-10-13 feat(hw): real board, docs and CAD outputs for the zero-IF SDR
    - technical_task.md rewritten for the Krystal zero-IF SDR (v1.1) in the same
    GOST structure/style: SNR/noise rows, RF spec, requirement mapping.
    - requirements: add REQ-36 (SNR) and REQ-37 (noise floor / MDS) project-wide,
    with block files, matrix, checklist and RF tests.
    - sim/scripts/sdr_skidl_circuit.py: emit the KiCad netlist from the built
    circuit (c.generate_netlist) instead of the empty default circuit.
    - hardware/kicad/build_board.py: deterministic code-first board build
    (SKiDL netlist -> kinet2pcb -> kicad-cli) producing out/ artifacts:
    board.kicad_pcb, gerbers/, drill/, gerbers.zip, board.{step,glb,svg,pdf,dxf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
2026-10-13 krystal-radio: add LLM Agent Framework (LangGraph) integration section to README
2026-10-13 krystal-radio: add enclosure design agent, build animation, operational docs scripts
2026-10-15 agent-driven project control: agent bridge API + runtime + Krystal UI tab
    Backend (backend/):
    - agent_bridge.py HTTP-мост: /api/chain, /api/projects, /api/metrics,
    /api/agents, /api/artifacts, /api/agent/run, /api/ask; белый список
    make-целей и скриптов, джобы с построчным логом, защита от path traversal
    - agent_runtime.py 23 агента из AGENT_PROMPTS.md -> bureau-роли, исполнение
    make-целей/скриптов, запись задач/deliverables/сообщений, LLM-маршрутизация
    - krsupabase.py клиент PostgREST на httpx (без supabase-py)
    Frontend (frontend/ = EngineeringTea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
2026-10-15 frontend: vendor gnuradio-world as submodule (browser GNU Radio / WASM)
    777arc/gnuradio-world подключён как git submodule в
    frontend/vendor/gnuradio-world — второй, браузерный путь к GNU Radio
    поверх нативной ко-симуляции (make gnuradio).
    Добавлен frontend/vendor/README.md с инструкцией по сборке редактора.
2026-10-15 requirements: align REQ-21..25 with the STM32 zero-IF SDR (drop legacy ESP32/Bragg)
    Требования ЭМС были написаны под отменённую акустооптическую схему
    (ESP32 + Wi-Fi 2.4/5 ГГц + ПЛИС + лазер 650 нм + нож Фуко + BPW34).
    Плата krystal-radio — это zero-IF SDR на STM32F103C8T6 с USB CDC и
    линейным питанием AMS1117-3.3.
    Переписано под фактическую конструкцию:
    REQ-21 — 3 секции: ВЧ-аналог / цифровая / питание; δ(Al, 1 ГГц) = 2.59 мкм
    (в тексте было 0.025 мм — завышено в 10 раз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
2026-10-15 requirements: rebuild tree by receiver subsystems, retire the Brig design
    Прежняя структура требований была унаследована от отменённого
    акустооптического приёмника: 4 камеры, кристалл TeO2, PMMA, лазер 650 нм,
    нож Фуко, фотодиоды BPW34, ПЛИС и канал Wi-Fi на ESP32. Правка отдельных
    файлов оставляла эту схему в основе, поэтому требования описывали чужое
    изделие.
    Теперь требования описывают **Krystal Radio — zero-IF SDR на STM32F103C8T6**
    и разлож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
2026-10-15 finish remaining work: enclosure CAD, ML tests, backend for frontend
    Корпус (REQ-MECH-01/02) — было «Planned», теперь построен:
    - hardware/enclosure/build_enclosure_fc.py — параметрическая модель FreeCAD,
    headless, размеры выведены из out/circuit.json (плата 88.6×85.1 мм)
    - 92.6×89.1×17.5 мм, стенка Al 0.5 мм, 3 секции с перегородками,
    рекурсия под RFI-прокладку по периметру, Ø3 силикагель, 4×М3
    - выход: FCStd + STEP + STL + out/enclosure.json
    - цель make enclosure, включена в make all
    Тесты ML (REQ-ANA-03) — 26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
2026-10-15 agent-driven order flow: multi-agent orchestrator + Order tab
    Заказ из интерфейса проходит мультиагентную обработку:
    frontend --POST /api/order--> Order (свободный текст)
    |
    v
    Planner -> план шагов
    (агент + цель для каждого)
    |
    v
    Executor: топологический,
    независимые шаги параллельно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
2026-10-15 fix(git): remove stray local_footprints gitlink that broke submodule commands
    local_footprints/ — shallow-клон https://github.com/KiCad/kicad-footprints,
    случайно попавший в индекс как gitlink ещё в коммите 498503b0. Он не был
    зарегистрирован в .gitmodules, поэтому:
    * любое обращение к подмодулям падало с
    "fatal: no submodule mapping found in .gitmodules for path 'local_footprints'";
    * в свежем клоне каталог появлялся пустым — 115 МБ данных, обещанных
    README/manifest, физически отсутствовали;
    * требова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
2026-10-15 agent-functional graph: универсальный движок заказов вместо хардкода
    Заказ из интерфейса проходит граф функций-агентов. Движок НЕ знает
    про Krystal Radio: всё конкретное лежит в agents.project.yaml как данные.
    frontend --POST /api/order--> supervisor (модель + инструменты)
    tools (выполняет вызовы)
    нужна помощь -> await_human -> interrupt() -> ответ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
2026-10-15 MCP-сервер, поток событий, план на утверждение и Nous Portal
    Доводит заказ до нормальной работы: интерфейс больше не форма с кнопкой,
    а управление графом.
    backend/mcp.py — инструменты над проектом по протоколу MCP:
    OpenCode, Claude Code и Codex получают тот же набор, что и веб-интерфейс:
    list_targets, describe_target, submit_plan, run_target, read_artifacts.
    Наружу выставлено ровно то же, что есть внутри, — внешний агент не
    получает больше пр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
2026-10-15 Уровни инструментов реально ограничивают вызов + правка пресета hermes
    make_bindings возвращал все инструменты независимо от уровня: схемы
    показывались урезанными, а вызвать скрытое можно было напрямую. «Компактный»
    набор был украшением. Теперь уровень ограничивает и показ, и вызов.
    Пресет hermes убран. Документация Nous Research прямо предупреждает, что
    семейство Hermes 4 «настроено под чат и рассу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
2026-10-15 Репозиторий из терминала, бесплатные модели по умолчанию, песочница заказа
    scripts/repo.sh — создание и публикация репозитория без веб-интерфейса.
    Причина, по которой раньше приходилось открывать GUI: в ~/.git-credentials
    лежит пароль, а не API-токен, и я пробовал передавать его как Bearer — API
    его отвергал. Оказалось, что Forgejo принимает тот же пароль по HTTP Basic
    и для API, ничего вводить не нужно.
    repo.sh init <им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
2026-10-15 Песочница подключена к исполнителю; OpenCode на бесплатных моделях
    Песочница заказа (work/orders/<id>) теперь не создаётся вхолостую:
    - engine._execute_one выполняет команды в рабочем каталоге заказа, а не
    в корне проекта. Команда собирается по описанию настоящего проекта,
    поэтому она одинакова в обоих местах;
    - engine.set_workdir задаёт каталог; пусто — команды идут в корень,
    как и должно быть для прямых вы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
2026-10-15 OpenCode на бесплатных моделях: проверка живости, .env, MCP-замкнутость
    scripts/oc.py спрашивает каталог, но не доверяет ему: каждая помеченная
    :free модель проверяется живым запросом, не отвечающие отсеиваются. Без
    этого модель по умолчанию могла оказаться нерабочей, а отказ выглядел
    как «Payment required» — то есть как неверный ключ.
    Ключ берётся из ~/.hermes/auth.json и кладётся в .env с правами 600,
    в gitignore добавл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
2026-10-15 Изоляция заказа: настоящие копии вместо ссылок, запрет разрушающих целей
    Проверял, что агент не может тронуть основной проект, и нашёл три пути.
    1. Разрушающие цели запускались напрямую.
    Инструмент run_target проверял только «есть ли такая цель», поэтому
    plan-обход ни при чём: `distclean` через MCP снёс out/, .venv и
    node_modules основного проекта. Причина — не в песочнице: при неудачном
    её создании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
2026-10-15 Агенты: имена от фронтенда + проект только для чтения
    1. Имена агентов зафиксированы в описании проекта.
    Все 23 идентификатора бюро (AGENT-MK-01 и так далее), которые
    показывает /api/agents, перенесены в agents.project.yaml — это данные,
    а не код. Генератор промптов берёт их оттуда, а не выдумывает новые.
    kириллические имена и идентификаторы из шаблона glob больше не
    вырождаются в AGENT-ART-TASK. Перегене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
2026-10-15 Агенты: инструменты с dict-вызовами, логи агентов в интерфейс
2026-10-15 UI: архив артефактов при завершении заказа
2026-10-15 UI: превью SVG/3D в архиве агентов
2026-10-15 UI: публичные заказы и 3D/чертежи в Projects tab
2026-10-15 Агенты: архив выходных по проекту + очистка песочниц
2026-10-15 Агенты: разблокировать проект до создания sandbox ( cp readonly fix)
2026-10-15 Агентно-функциональный: live-журнал шагов + проект «только для чтения»
2026-10-15 Universal: generic project scaffolder + switch selected project
2026-10-16 remove redundant kicad->spice converter: native kicad-cli netlist --format spice covers it
2026-10-17 Снимок конвейера: дизайнер проектирует узлы сам, модули — через каталог
    Каталог готовых решений убран из контура (solutions/*, tools/solutions.py):
    топологию узлов даёт первоисточник (даташит/аппнота/книга —
    knowledge/electronics_sources.md), номиналы — расчёт или даташит реальной
    детали. Готовые модули (TP4056 и подобные) остаются: агент находит их сам
    или инструментом part_search в каталоге поставщика (локальный ср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
2026-10-28 Инструмент создания символов, отложенные корпуса и новые модули агентов
    - kicad_libs: действие create_symbol — библиотекарь создаёт символы
    в local_symbols (symbol_name/symbol_value/symbol_footprint)
    - schematic_from_json: корпус не блокирует сборку — назначается
    по типу компонента или позже библиотекарем
    - stages: отсутствие корпуса на стадии library — предупреждение,
    а не ошибка (корпуса подтверждает kicad/библиотекарь)
    - новые м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
2026-10-28 Fix typo in README for LED driver project
2026-11-10 feat: integrate best of auto-pcb/ai-pcb-generator/text-to-cad; constructor drawings, ML placement surrogate, agent loops, breadboard 3D, frontend 3D viewer
2026-11-10 feat: UI/UX — build progress bar in header, breadboard 3D, three.js viewer animations
2026-11-10 feat: Bolt-style multi-language code agent (prompt->run->fix) + CI/CD workflows
2026-11-10 feat: departments UI, agent CI, software/biz/science/data-science flows wired
2026-11-10 feat: agent-all target, all departments wired, full integration
2026-11-10 auto-improve: итерация 1 - planner: добавлен кэш планов, engine: добавлено автовосстановление, stages: добавлены параллельные стадии
2026-11-10 pipeline-improve: planner: добавлено обучение на истории заказов
